shourya-khatiyan/Prime-TheHumanoid/obsidian-robot-vault/VAYN-TheUltimateBrain/Building VAYN - 6.2/VAYN — Phase 1 Electronics + RT Core Architecture.md

> **Revision note (2026-10-20, VAYN-6.2.1):** corrected in place to match the built hardware and live measurements:  
> gearbox 20:1 → **30:1 two-stage planetary (6:1 × 5:1)**; motor-turn sector 18° → **12°**  
> motor **EaglePower LA8308 KV90**, 20 pole pairs (counted)  
> torque targets → **30 N·m continuous / 50 N·m proof, theoretical**  
> RT computer Mac Mini → **Dell Latitude 5490** (PREEMPT_RT kernel 7.0)  
> Phase-1 power 6S battery → **bench PSU at about 24 V**  
> arm "3 kg / 10–13 N·m" → **1.414 kg / 3.26 N·m** (v0)  
> output reference: **hall homing** (the shoulder CAD has no output encoder)  
> ODESC firmware **0.5.1**, CAN currently 250 kbit/s (to be set to 1 Mbit/s)  
> The questions in §10 have been answered. See [VAYN-6.2.1](../VAYN - 6.2.1.md) and the [RT Core implementation spec](RT Core Implementation - VAYN 6.2.1.md).

### 1.1 The actuator is a 30:1 design (30 N·m continuous / 50 N·m proof targets)
Earlier docs used an 80:1 / 80+ N·m assumption, and then a 20:1 analysis. The built shoulder (`Prime-TheHumanoid/body parts/shoulder`) uses a **30:1 two-stage planetary**: stage 1 is 6:1 (18/36/90 teeth), stage 2 is 5:1 (18/27/72 teeth). That gives:

\[ K_t \approx \frac{8.27}{90}=0.0919\ Nm/A \] (ODrive convention; 90 KV is the seller's value, not measured)
`Ideal output per amp:`
\[ 0.0919\times30\approx2.76\ Nm/A \]
`At 87% gearbox efficiency (assumed in the actuator profile, unproven):`
\[ \boxed{\approx2.40\ Nm/A} \]

So this actuator is documented as:
> **30:1 reduction; 30 N·m continuous (about 12.1 A in** **`shoulder/cad/calc.txt`****) and 50 N·m proof targets. Theoretical; continuous torque must be proven by the thermal test.**

---

### 1.2 The motor's 22 A rating cannot be treated as our continuous actuator rating
This is probably the most important mechanical/electrical correction.
The motor is a drone motor. Its published current rating assumes substantial airflow from the propeller. Inside a relatively enclosed actuator, we cannot assume it can continuously dissipate the same heat. Pasted text
Therefore:

```css
22 A motor rating
        ≠
22 A continuous actuator rating
```

The real continuous rating will come from the **thermal test**.

---

### 1.3 Output encoder is now a Phase-1 requirement, not a later improvement
Previously I treated the second encoder as something we could add later.
I would change that.
Because the motor-side AS5047P is single-turn and the reduction is 30:1:
[ 360^\\circ / 30 = 12^\\circ ]
The motor encoder alone cannot tell us which 12° joint sector we're currently in after power-up.
Therefore:

```markdown
Motor AS5047P
      ↓
ODESC
      ↓
motor control

Output absolute encoder
      ↓
sensor MCU
      ↓
RT Core
```

The output encoder establishes the absolute joint position and resolves the motor-turn ambiguity. The analysis explicitly recommends treating it as required before the arm moves. Pasted text
So I now consider:
> **2 × AS5047P per actuator**  
> one motor-side + one output-side  
> a much more appropriate Phase-1 architecture, assuming we indeed use AS5047P for the output sensor.

> **Update (2026-10-20):** the shoulder CAD has no output encoder; it has a **DRV5033 hall homing sensor** on the output flange. Because 30:1 is an exact integer ratio, any reference better than ±6° (reference pose by hand, or the hall edge) selects the 12° sector, and the motor encoder then gives the absolute joint angle at about 0.03° precision. The output encoder is no longer a hard gate before arm motion. It stays the recommended later upgrade for homing without motion and two-channel plausibility. Note also that the AS5047P's 0.022° is its _resolution_; its _accuracy_ is ±0.8° (datasheet). See [VAYN-6.2.1 §8](../VAYN - 6.2.1.md).

---

### 1.4 Safety is now part of the actuator architecture, not a later Phase-1 addition
Our previous plan could be interpreted as:

```text
ODrive
→ RT Core
→ safety later
```

That is too loose.
The v0 arm is 1.414 kg, and the shoulder gravity torque is about 3.26 N·m with the arm horizontal; it rises to about 9.2 N·m with the planned "stage 2" wrist, gripper and 0.5 kg payload (`arm/cad/calc.txt`, `arm/research.md`). Loss of drive can cause the arm to fall. On ODESC3.6, a watchdog timeout or any drive fault disarms the motor. The new analysis therefore makes the **safe state** an architectural decision that has to happen before unrestricted arm testing. Pasted text
We therefore need to define:

```haskell
normal fault
→ controlled stop

hard fault
→ drive off + brake/safe mechanism

power loss
→ fail-safe mechanical/passive state
```

The exact mechanism is still open.

---

### 1.5 We need a Sensor/Interface MCU in addition to the Safety MCU
This is a new architectural element.
The RT computer (now a Dell Latitude 5490 laptop; previously a Mac Mini) has no native SPI/I²C/GPIO interface suitable for directly reading the output encoder, the hall homing sensor and future sensors.
So we should separate:

```cpp
Sensor MCU
    ↓
reads output encoder / future IMU
    ↓
CAN
    ↓
RT Core
```

from:

```markdown
Safety MCU
    ↓
independent safety monitoring
    ↓
fault response
```

The analysis explicitly recommends keeping the sensor-interface function separate from the Safety MCU so that the safety firmware stays small and deterministic. Pasted text
This is a good design decision, and I would adopt it.

---

### 1.6 The first RT control mode should be simpler than full torque-mode impedance control
This is another important change.
Previously our mental model was:

```text
RT Core
→ desired torque
→ ODESC torque mode
```

I would **not start there anymore**.
The new analysis recommends initially using the ODESC's own cascaded position/velocity control loops, which operate much faster and avoid putting a network-delay-sensitive damping loop immediately across CAN.
So our initial control architecture becomes:

```css
RT Core
   ↓
desired position
+
torque feedforward
   ↓
CAN
   ↓
ODESC
   ↓
position/velocity loops
   ↓
FOC/current control
```

Only later, once we have measured:

```swift
output encoder
Kt
friction
backlash
thermal behavior
CAN delay
```

do we move toward:

```sql
RT Core
   ↓
full joint impedance
   ↓
desired torque
   ↓
ODESC torque/current mode
```

The analysis estimates roughly 1–3 ms network delay and specifically warns that this constrains how much damping we can safely put into a network-level impedance loop. Pasted text
That is a much more conservative progression.

---

# 2. Revised Phase 1 architecture
Our physical Phase-1 prototype should now look like this:

```sql
                         VAYN PHASE 1
                              │
                 ┌────────────┴────────────┐
                 │                         │
                 ▼                         ▼
        ┌─────────────────┐       ┌─────────────────┐
        │  DELL 5490      │       │   SAFETY MCU    │
        │                 │       │                 │
        │ Linux           │       │ watchdog        │
        │ PREEMPT_RT      │       │ current         │
        │ RT Core         │       │ voltage         │
        │                 │       │ temperature     │
        └────────┬────────┘       │ encoder/fault   │
                 │                │ E-stop          │
                 │ CAN            └────────┬────────┘
                 │                         │
                 └────────────┬────────────┘
                              │
                         CAN BUS
                              │
        ┌─────────────────────┼─────────────────────┐
        │                     │                     │
        ▼                     ▼                     ▼
   ┌─────────┐          ┌─────────────┐       future nodes
   │ ODESC   │          │ Sensor MCU  │
   │ 3.6     │          │             │
   │         │          │ Hall homing │
   │ FOC     │          │ IMU later   │
   │ current │          └─────────────┘
   │ control │
   └────┬────┘
        │
      3-phase
        │
        ▼
     BLDC MOTOR
        │
   motor AS5047P
        │
     gearbox
        │
        ▼
    JOINT OUTPUT
        │
 DRV5033 hall homing (output AS5047P later)
```

---

# 3. Revised Phase-1 stages
I would now divide Phase 1 into **nine gates**.

---

## P1.0 — Requirements + safety freeze
Before we write serious code or spin anything:
### Freeze:

```sql
continuous torque target
peak torque target
maximum joint velocity
joint range
payload
duty cycle
stopping time
```

The current sensible starting point is:

```text
30 Nm continuous target   (shoulder/cad/calc.txt; earlier draft said 20)
50 Nm peak/proof target   (shoulder/cad/calc.txt; earlier draft said 35)
```

but we should explicitly mark those as **requirements/targets**, not measured capabilities. Pasted text
### Also freeze the safe-state behavior.
For example:

```sql
CAN failure
USB failure
ODESC fault
RT Core crash
Safety MCU crash
battery disconnect
E-stop
over-temperature
over-current
over-voltage
encoder failure
```

For every one:

```css
What happens to the joint?
```

This becomes our **Phase-1 Safety State Table**.

---

# P1.1 — Electrical power architecture
For Phase 1 we use a **bench power supply at about 24 V** with a current limit. A 6S-class battery (about 24 V) remains the later option.
At 24 V:
[ 90KV\\times24V\\approx2160RPM ]
At 30:1:
[ 2160/30\\approx72RPM ]
So roughly:

```perl
24 V
→ ~72 rpm output no-load (432 °/s)
```

The analysis warns against 12S for Phase 1 because a full 12S pack reaches 50.4 V before considering regenerative overshoot against the ODESC's 56 V limit.

A bench PSU usually **cannot absorb regenerated energy**. The ODESC is configured (read live) to send regen into its 2 Ω brake resistor (`dc_max_negative_current = -0.01`). Verify the resistor with a multimeter, and set the over-voltage trip to about 28 V for a 24 V bus.

For the later battery setup we need:

```text
6S battery (later; Phase 1 uses a bench PSU)
↓
anti-spark connector
↓
fuse
↓
contactor / power stage
↓
ODESC
```

and a proper regeneration strategy.

---

# P1.2 — ODESC identification and bring-up
Before motor power:

```text
Computer
   ↓ USB
ODESC
```

We collect:

```swift
hardware revision
firmware version
serial number
original configuration
CAN pinout
SPI pinout
termination
brake resistor circuit
```

And:
> **Do not flash firmware yet.**  
> The reason is that the ODESC3.6 is a clone and its firmware/hardware behavior must be identified before we blindly apply official ODrive assumptions. Pasted text  
> We should make an **ODESC Fact Sheet**.

---

# P1.3 — Motor + encoder commissioning
Do this with:

```diff
motor
+
ODESC
+
AS5047P
```

but **gearbox disconnected**.
We establish:

```css
pole pairs
phase resistance
inductance
encoder direction
encoder offset
motor direction
current limits
velocity limits
```

Start conservatively around:

```css
~5 A
```

for initial calibration/testing, as recommended in the analysis. Pasted text
Then:

```bash
slow velocity test
```

before anything remotely aggressive.

---

# P1.4 — Motor thermal instrumentation
This needs to move much earlier than our old plan.
The motor has no trusted built-in winding temperature measurement for our application.
We need:

```sql
NTC / thermistor
      ↓
motor winding/end-turn
      ↓
Sensor/Safety system
```

The important test points are:

```css
6 A
8 A
12 A
```

for approximately:

```python
30–60 min
```

while measuring winding temperature.
That will give us the first real continuous-duty data. Pasted text Pasted text

---

# P1.5 — Gearbox + actuator characterization
Only after the motor itself is understood:

```verilog
motor
 ↓
gearbox
 ↓
joint output
```

Then experimentally measure:
### Torque
Measure actual:
[ T_{output}/I_{motor} ]
This gives us the real effective (K_t) after losses.
### Efficiency
Measure input electrical/mechanical power against output mechanical power.
### Friction
Measure output breakaway torque in both directions.
### Backlash
Apply known torque in each direction and measure output movement.
### Thermal behavior
Hold:

```css
6 A
8 A
12 A
```

and measure steady-state temperature.
The result is a real actuator datasheet rather than relying on calculations. Pasted text

---

# P1.6 — Absolute joint sensing
This is now a hard gate before arm movement.
We need:

```bash
AS5047P #1
→ motor
→ ODESC

AS5047P #2
→ joint output
→ Sensor MCU
→ CAN
→ RT Core
```

The output encoder determines:

```scss
absolute joint position
joint zero
motor-turn ambiguity
```

At 14-bit resolution:
[ 360/16384 \\approx 0.02197^\\circ ]
so the raw encoder resolution is approximately:
[ \\boxed{0.022^\\circ} ]
The analysis recommended this architecture because the gearbox creates a joint ambiguity from a single motor-side turn: 12° at the current 30:1.

> **Update (2026-10-20):** this gate is replaced for Phase 1 by hall homing or reference-pose homing (see §1.3 update and [VAYN-6.2.1 §8](../VAYN - 6.2.1.md)). The output encoder becomes a later upgrade.

---

# P1.7 — Safety system
Now we bring in:

```diff
Safety MCU
+
E-stop
+
power control
+
brake / passive safety mechanism
```

The Safety MCU should independently monitor:

```sql
DC voltage
DC current
motor temperature
ODESC temperature
output encoder
E-stop
ODESC heartbeat
RT heartbeat
```

The analysis also points out that the Nucleo board itself is only a prototype board and has **no CAN transceiver or safety certification**, so an external CAN transceiver is required and a custom safety board will ultimately be preferable. Pasted text

---

P1.8 — RT Core development and real-time validationBuilding VAYN - [6.2.md](http://6.2.md)
•

# Building VAYN-6.2 — Versatile Arbitrated Embodied Nervous-System

> **VAYN-6.2 is not one AI model. It is a complete robot control system in which different computers and models have different jobs.**

# 1. VAYN-6.2 in very simple language

Think of the robot as having **three main computers**:

```text
             ┌─────────────────────┐
             │   AI COMPUTER       │
             │   Jetson Orin NX    │
             │                     │
             │ "What should I do?" │
             └──────────┬──────────┘
                        │
                 movement reference
                        │
                        ▼
             ┌─────────────────────┐
             │   RT MOTION CORE    │
             │                     │
             │ "How do I move      │
             │  safely right now?" │
             └──────────┬──────────┘
                        │
                   motor commands
                        │
                        ▼
             ┌─────────────────────┐
             │     ACTUATORS       │
             └─────────────────────┘

             ┌─────────────────────┐
             │    SAFETY MCU       │
             │                     │
             │ "Is anything        │
             │  dangerously wrong?"│
             └─────────────────────┘
```

The three computers **do not have equal authority**.

The key rule is:

```text
Orin = intelligence
RT Core = physical control
Safety MCU = independent protection
```

The Orin can disappear and the robot should still have a physical control path. The VAYN-6.2 document explicitly makes the RT Motion Core the owner of stabilization, arbitration, safety validation, fallback and final actuator commands, while the Safety MCU is independent.

---

# 2. The easiest way to understand the four parts

VAYN uses:

```text
THINK → PREDICT → MOVE → SURVIVE
```

# THINK = "What do I want to do?"

This is the intelligent/high-level part.

Example:

You say:

> "Pick up the red bottle."

The robot needs to figure out:

```text
What is the bottle?
Where is it?
Which hand should I use?
What skill should I execute?
```

This is where the VLM, memory and task planner live.

It is **not** controlling motors directly.

Think of it as the robot's **decision maker**.

---

# 3. PREDICT = "What is going to happen?"

Suppose the robot sees:

```text
cup is here
```

But the camera image is already 50 ms old.

The robot has moved during those 50 ms.

So instead of blindly saying:

> "The cup is exactly where the camera saw it."

the predictive system asks:

> "Given how the robot moved, where is the cup/robot likely to be now?"

And similarly:

> "If I move my hand like this, where will my hand/body probably be 30 ms later?"

VAYN-6.2 specifically uses a **hybrid prediction idea**:

```text
Known physics / kinematics
           +
learned residual
           +
contact information
           ↓
     predicted state
```

So we're not asking a neural network to relearn all of physics from zero.

---

# 4. MOVE = "What exact movement should happen?"

Now the robot has:

```text
task
+
vision
+
physical state
+
optional prediction
+
constraints
```

The action policy decides:

> "Move the right hand toward this position."

But this is very important:

# The AI does NOT say:

```text
Motor 1 = 2.37 A
Motor 2 = 1.83 A
Motor 3 = ...
```

Instead it produces a **motion reference**.

For example:

```text
Move right hand here
Move body this way
Put foot here
Maintain this grip force
```

The document calls this a **skill-specific motion reference**.

For example:

```text
GRASP

hand position
hand orientation
joint posture
grip force
contact mode
```

or:

```text
WALK

base velocity
turning velocity
footstep target
timing
body posture
```

---

# 5. SURVIVE = "Can the physical robot actually do this safely?"

This is the most important part of VAYN.

Suppose the AI says:

```text
Move arm here
```

The RT Motion Core asks:

```text
Is this allowed?
Is the joint limit exceeded?
Is the torque too high?
Is the command stale?
Is the robot falling?
Do I need to correct the motion?
```

Then it converts the reference into actual motor control.

Simplified:

```text
AI says:
"Put hand here"

        ↓

RT Motion Core

        ↓

check limits
check state
stabilize body
calculate trajectory
apply impedance/torque control

        ↓

motor driver

        ↓

motor
```

That ownership is explicitly frozen in VAYN-6.2.

---

# 6. Why do we need the RT Motion Core?

This is probably the **single most important concept** to understand before we build anything.

Imagine the Orin runs Linux and your neural model takes:

```text
50 ms
```

or crashes.

You don't want:

```text
AI crashed
   ↓
motors suddenly lose control
   ↓
robot falls
```

Instead:

```text
AI crashed
   ↓
RT Motion Core notices
   ↓
rejects stale command
   ↓
uses fallback behavior
   ↓
keeps controlling the robot
```

That is why VAYN calls it **real-time physical control** rather than simply putting everything inside Python/PyTorch.

---

# 7. Why the Safety MCU exists

Now imagine the RT computer itself crashes.

We don't want:

```text
Orin ──X
RT Core ──X
       ↓
motors continue doing something dangerous
```

The Safety MCU is another independent layer.

It watches things such as:

```text
motor current
encoder status
temperature
driver state
heartbeats
E-stop
```

and can constrain or disable actuation when necessary.

The important part is that it should not depend on:

```text
Linux
CUDA
VLM
Orin software
```

for its basic safety role.

---

# 8. So the robot has two different kinds of "brain"

This distinction is useful:

# AI brain

```text
"I want to pick up the cup."
```

# Physical brain

```text
"Your arm is moving too fast.
Your body is leaning.
Slow down.
Shift COM.
Don't exceed this torque."
```

The first is intelligent and flexible.

The second is **fast, predictable and physically constrained**.

VAYN-6.2 is basically saying:

> Don't force one computer/model to do both jobs.

---

# 9. What actually runs on the Orin?

The baseline assigns the Orin things like:

```text
Camera processing
Visual encoder
Object tracking
World model
Action policy
Cognitive model
Task planner
Event manager
Logging
Model management
```

So the Orin is doing the **expensive AI work**.

It is not the final authority on the motors.

---

# 10. What actually runs on the RT Motion Core?

This is where the real robotics/control engineering happens:

```text
IMU
Encoder
Force/torque
Contact information
       ↓
State estimation
       ↓
Stabilization
       ↓
Command arbitration
       ↓
Safety validation
       ↓
Trajectory generation
       ↓
Impedance / torque control
       ↓
Motor drivers
```

The RT core is the robot's **physical nervous system**.

The document explicitly assigns state estimation, arbitration, validation, fallback, stabilization, trajectory generation and impedance control here.

---

# 11. What is "physical state"?

The RT computer maintains the authoritative physical state.

For example:

```text
q            = joint positions
q_dot        = joint velocities

base pose
base velocity
body orientation

motor torque/current

contact state

COM position
COM velocity
```

Think:

```text
S_phys = "What is physically happening to my body right now?"
```

The Orin can **read** this state.

It doesn't get to create a competing version of physical truth.

---

# 12. Where does vision fit?

Vision is separate from physical state.

For example:

```text
Physical state:
"My right elbow is at 1.2 rad."

Vision:
"There is a red cup 40 cm in front of me."

Task state:
"I need to pick up that cup."

Prediction:
"My hand will probably reach this position in 30 ms."
```

VAYN intentionally keeps these representations separate because visual information contains details that cannot be compressed into simple physical variables.

---

# 13. What is the Reflex Layer?

Imagine the robot is holding a cup.

The high-level policy says:

```text
Hold cup
```

Suddenly:

```text
cup starts slipping
```

We don't want to wait for:

```text
camera
→ vision model
→ planner
→ policy
→ new command
```

Instead fast sensors can react:

```text
tactile / force / IMU / joint feedback
           ↓
        reflex
           ↓
small correction
```

For example:

```text
increase grip force
```

or:

```text
move wrist slightly
```

The important part is that the reflex is **bounded**.

It doesn't get unlimited authority.

---

# 14. What does "bounded" mean?

Suppose the AI says:

```text
move arm normally
```

and the reflex detects something unusual.

It can add:

```text
Δu_reflex
```

but only within a predefined authority.

Conceptually:

```text
final request =
normal AI request
+
limited reflex correction
```

The RT core decides whether that final command is actually allowed.

So:

```text
AI
 │
 ├── "move here"
 │
 ▼
Reflex
 │
 └── "slightly correct"
 │
 ▼
RT Core
 │
 └── "I decide what is physically allowed"
```

This is important because otherwise three systems could fight over the actuator.

---

# 15. What happens if AI stops?

This is where VAYN becomes much easier to understand.

# Normal

```text
Orin
 ↓
RT Core
 ↓
Robot
```

# Orin failure

```text
Orin X

RT Core
 ↓
fallback
 ↓
Robot remains physically controlled
```

# RT Core failure

```text
RT Core X

Safety MCU
 ↓
hardware-defined safety response
```

The exact final behavior depends on your actuator hardware: brakes, passive damping, driver safe-state behavior, etc.

So **we cannot finish the safety architecture without eventually knowing the actuator design**.

---

# 16. What does "stale command" mean?

Suppose the AI says:

```text
Move arm to position X
```

and then the AI freezes for 2 seconds.

We absolutely do not want the robot thinking:

> "This is the newest command, so I'll keep using it."

Every important command therefore contains:

```text
timestamp
sequence_id
valid_until
```

So the RT core can say:

```text
command expired
      ↓
reject
      ↓
fallback
```

This freshness idea is one of the important frozen architectural rules.

---

# 17. The entire robot in one example

Let's say you say:

> **"Pick up the bottle."**

# Step 1 — THINK

VLM:

```text
Task = pick up bottle
Object = bottle_01
Hand = right
Skill = GRASP
```

# Step 2 — PERCEIVE

Camera:

```text
Bottle location
Bottle orientation
Scene geometry
```

# Step 3 — PREDICT

Prediction:

```text
Given robot motion + sensing delay:
expected hand/object state = X
```

# Step 4 — MOVE

Action policy:

```text
Move right hand to X
Approach at this velocity
Use this grip force
```

# Step 5 — REFLEX

Tactile:

```text
Contact detected
Slip probability increasing
```

Reflex:

```text
increase grip slightly
```

# Step 6 — RT CORE

RT controller:

```text
Check joint limits
Check velocity
Check torque
Maintain balance
Combine nominal + reflex
Generate motor commands
```

# Step 7 — SAFETY MCU

Safety MCU:

```text
Everything within limits?
Heartbeat alive?
Motor current safe?
Temperature safe?
```

# Step 8 — ACTUATORS

Motors physically move.

That's VAYN-6.2.

---

# 18. The important part: we are NOT going to build everything at once

This is where your original architecture document is actually very good.

The document explicitly says the development should happen in phases, starting with physical control and only later adding the advanced AI components.

The actual build should look like this:

```text
PHASE 1
Physical control
        ↓
PHASE 2
Basic robot behavior
        ↓
PHASE 3
Vision
        ↓
PHASE 4
Prediction
        ↓
PHASE 5
Reflex
        ↓
PHASE 6
Cognition
        ↓
PHASE 7
Generalist / advanced AI
```

---

# 19. Phase 1 is the REAL beginning

This is where I would start with you.

We build:

```text
ACTUATORS
    ↓
MOTOR DRIVERS
    ↓
RT MOTION CORE
    ↓
STATE ESTIMATOR
    ↓
STABILIZATION
    ↓
IMPEDANCE CONTROL
    ↓
SAFETY MCU
```

And **this must work without the Orin**.

That is explicitly the first development phase in your baseline.

---

# 20. What Phase 1 actually means in practical terms

We don't start by training a VLM.

We don't start by building a world model.

We don't start by training an LNN.

We don't even need the full humanoid intelligence yet.

We first need to make one joint behave correctly.

Something like:

```text
Encoder
   ↓
position estimate
   ↓
controller
   ↓
motor driver
   ↓
motor
   ↓
encoder
   └──────────────┐
                  │
                  └── feedback loop
```

Then:

```text
one joint
↓
one actuator
↓
one limb
↓
multiple joints
↓
whole body
```

---

# 21. Then we build the robot's physical "brain"

Once actuators work:

```text
IMU
+
encoders
+
force sensors
        ↓
state estimator
        ↓
"Where is my body?"
```

Then:

```text
state
+
desired motion
        ↓
stabilization/controller
        ↓
motor commands
```

This becomes the RT Motion Core.

---

# 22. Then we make it move without AI

Before adding the fancy neural system:

```text
STAND
WALK
SIT
REACH
GRASP
```

using conventional/controlled methods.

Why?

Because otherwise, when something fails later, we won't know whether the problem is:

```text
motor
encoder
controller
state estimator
AI
vision
prediction
```

The baseline explicitly requires baseline locomotion and manipulation before research components.

---

# 23. Only then do we add AI

Once the physical robot works:

```text
Physical robot
      +
vision
      ↓
object understanding
```

then:

```text
vision
+
physical state
+
task
      ↓
action policy
```

then:

```text
prediction
```

then:

```text
reflex
```

then:

```text
VLM
```

This keeps debugging manageable.

---

# 24. Minimum VAYN-6.2

You don't actually need the full architecture to say:

> "I have started VAYN."

The minimum functioning version in your document is:

```text
Safety MCU
+
RT Motion Core
+
State Estimator
+
Stabilization
+
Impedance Control
+
Baseline Locomotion
+
Baseline Manipulation
+
Basic Perception
```

The more advanced pieces such as world model, reflex, Flow Matching, VLM, event manager, distillation and free-form policy are optional research additions.

That is extremely important.

---

# 25. So how we'll actually build it

I suggest we treat this as a real engineering project with the following sequence:

```text
VAYN-6.2 IMPLEMENTATION
│
├── 0. Hardware definition
│
├── 1. Actuator interface
│
├── 2. Safety MCU
│
├── 3. RT Motion Core
│     ├── real-time loop
│     ├── encoder reader
│     ├── IMU
│     ├── state estimator
│     ├── limits
│     ├── trajectory generator
│     └── impedance controller
│
├── 4. Single-joint testing
│
├── 5. Multi-joint testing
│
├── 6. Whole-body state estimation
│
├── 7. Stabilization
│
├── 8. Basic locomotion
│
├── 9. Basic manipulation
│
├── 10. Orin communication
│
├── 11. Visual perception
│
├── 12. Action policy
│
├── 13. Prediction
│
├── 14. Reflex
│
├── 15. VLM / task manager
│
└── 16. Full VAYN integration
```

And we should **test every layer before connecting the next one**.

---

# 26. One thing we need to settle before writing code

Your VAYN-6.2 document intentionally leaves some hardware choices open:

```text
RT processor
Actuator communication bus
Actuator safety mechanism
Motor drivers
Sensors
```

Those are not arbitrary software details. They determine how we implement the RT Motion Core.

The document itself says the RT hardware and actuator bus are still engineering parameters rather than frozen choices.

So the next stage should be:

```text
VAYN-6.2
      ↓
PHYSICAL ROBOT HARDWARE
      ↓
RT HARDWARE SELECTION
      ↓
ACTUATOR INTERFACE
      ↓
PHASE 1 IMPLEMENTATION
```

**We can build this with you step-by-step, including the actual code, processes, communication protocol, folder structure, controller mathematics, simulation, testing and eventually the Orin integration.**

# The first thing I would build is **Phase 1: one complete actuator control chain** — encoder → RT controller → motor driver → motor → feedback — because everything above it depends
Now the RT computer becomes important (Dell Latitude 5490 since 2026-10-20; this section originally described a Mac Mini).
## RT Core software stack

```swift
Ubuntu
   ↓
PREEMPT_RT
   ↓
C++
   ↓
VAYN RT Core
   ↓
SocketCAN
   ↓
CAN adapter
   ↓
ODESC
```

The RT Core should have:

```text
INIT
CHECKS
READY
RUN
FAULT
SAFE
```

as explicit states. Pasted text
And the real-time thread needs:

```cs
locked memory
fixed priority
CPU affinity
no allocation in loop
lock-free logging path
```

rather than simply "run a C++ loop on Linux." Pasted text

---

# P1.9 — Real RT-controlled single actuator
Only now do we combine everything:

```css
                 RT CORE
                    │
            desired position
            + torque FF
                    │
                   CAN
                    │
                 ODESC
                    │
            position/velocity
                 loops
                    │
                  FOC
                    │
                  BLDC
                    │
                gearbox
                    │
                 joint
              ↙         ↘
     motor encoder    output encoder
          │                 │
        ODESC           Sensor MCU
          │                 │
          └────── CAN ──────┘
                    │
                 RT Core
```

This is our first **true VAYN physical control loop**.

---

# 4. Revised RT Core development path
We should not wait until the physical actuator exists to write RT Core.
We'll develop it in parallel.
### RT-0 — Simulation

```css
desired q
 ↓
impedance/controller
 ↓
simulated actuator
 ↓
q, qdot
 ↓
feedback
```

Use the actual estimated parameters:

```text
30:1
Kt ≈ 0.092 (8.27/90; measure)
backlash 0.09–0.22° (CAD)
friction
delay ≈ 2–3 ms (measure)
arm inertia
motor/gear inertia
```

The analysis specifically recommends building the model around the measured values rather than generic assumptions. Pasted text

---

### RT-1 — Linux real-time timing
Run:

```diff
PREEMPT_RT
+
cyclictest
+
CPU stress
+
logging stress
```

But cyclictest isn't enough.
We need:

```cpp
RT thread
 ↓
SocketCAN
 ↓
USB-CAN
 ↓
CAN bus
 ↓
ODESC
 ↓
reply
 ↓
RT thread
```

and measure the **entire end-to-end path**.
The analysis explicitly calls for histogram, 99.9th percentile and worst-case latency over hours under CPU, USB, Ethernet and logging load. Pasted text
That becomes one of the exit criteria for the RT computer (now the Dell Latitude 5490; see the implementation spec §3.7 for the measurement procedure and targets).

---

# 5. CAN architecture is now clearer
For Phase 1 I would use:

```swift
Classic CAN
1 Mbit/s
```

with a SocketCAN-native adapter, preferably isolated.
Topology:

```cs
[120Ω]
   │
Dell 5490 (USB-CAN)
   │
   ├──── ODESC
   │
   ├──── Safety MCU
   │
   └──── Sensor MCU
   │
[120Ω]
```

Only the two physical ends get 120 Ω termination.
With roughly 0.11–0.135 ms per 8-byte standard frame at 1 Mbit/s (135 bit-times worst case with stuffing), one joint at 1 kHz is possible, but this absolutely does **not** scale to ten joints with the same message budget on one classic-CAN bus.

> **Update (2026-10-20):**  
> Firmware 0.5.1 has no periodic encoder messages, so the RT core must poll. That costs about 325 µs of bus time per joint per cycle (command, RTR, reply), which is about 33% load at 1 kHz.  
> The ODESC is currently at **250 kbit/s**, where even one joint at 1 kHz would need about 130% of the bus. It must be set to 1 Mbit/s.  
> See [VAYN-6.2.1 §12](../VAYN - 6.2.1.md).  
> That means we should design our software with:

```diff
actuator abstraction
+
bus abstraction
```

from the start, rather than hardcoding everything to "one CAN bus forever."

---

# 6. Updated control strategy
This is the most important software change.
## Level 1 — First real actuator

```rust
RT Core

desired position
+
gravity torque feedforward

        ↓ CAN

ODESC

position loop
velocity loop
current loop
FOC
```

The ODESC is doing the fast inner loops.

---

## Level 2 — After characterization
Once we know:

```css
Kt
friction
backlash
output position
thermal limits
network delay
```

we can move to:

```markdown
RT Core

state estimation
      ↓
impedance control
      ↓
joint torque
      ↓
CAN
      ↓
ODESC torque mode
```

This is where VAYN's true joint-level impedance controller begins to become useful.

---

# 7. Updated Phase-1 hardware list
So the "electronics we need" list has changed.
## Required
### Motor side
- EaglePower LA8308 KV90 BLDC motor (have)
- Flipsky ODESC3.6, firmware 0.5.1 (have)
- AS5047P #1 (have; must be mechanically mounted on the motor)
- encoder magnet (Ø6 × 2.5 diametric)
- motor temperature sensor (10 kΩ NTC; ODESC GPIO4 is taken by the encoder CS, so another pin or the Safety MCU must read it)
### Joint side
- DRV5033 hall homing sensor + Ø3 × 2 N52 magnet (in the shoulder CAD)
- output-side AS5047P: later upgrade, not a Phase-1 gate
### RT side
- Dell Latitude 5490 (have; replaces the Mac Mini)
- Ubuntu 26.04 + PREEMPT_RT kernel 7.0 (installed)
- isolated SocketCAN CAN adapter with hardware timestamps (to buy)
### Safety
- NUCLEO-G474RE/G484-class MCU board — exact board still needs confirmation
- CAN transceiver
- E-stop
- DC-rated fuse
- anti-spark connector
- contactor/relay
- chosen passive safe-state mechanism
### Sensor interface
- separate small MCU for output encoder / future IMU
- CAN transceiver
### Power
- Bench PSU at about 24 V with a current limit for Phase 1 (have; rating to confirm); 6S battery later
- appropriate wiring
- regeneration strategy
- DC bus protection

This is materially more complete than our previous list.

---

# 8. Phase-1 exit criteria
I would define Phase 1 as **complete only when all of these are true**:
### Actuator

```css
[✓] Motor calibrated
[✓] AS5047P motor encoder validated
[✓] Gearbox assembled
[✓] Absolute joint angle validated (hall / reference-pose homing; output encoder later)
[✓] Kt experimentally measured
[✓] Efficiency measured
[✓] Friction measured
[✓] Backlash measured
[✓] Thermal curve measured
[✓] Continuous torque experimentally established
```

### RT Core

```css
[✓] PREEMPT_RT installed
[✓] RT timing characterized
[✓] CAN path characterized
[✓] State machine implemented
[✓] Limits implemented
[✓] Command freshness implemented
[✓] Logging implemented
[✓] Simulation passes
```

### Safety

```css
[✓] E-stop tested
[✓] RT heartbeat tested
[✓] ODESC heartbeat tested
[✓] encoder fault tested
[✓] over-current response tested
[✓] over-temperature response tested
[✓] over-voltage response tested
[✓] CAN disconnect tested
[✓] power-loss response tested
```

### Control

```css
[✓] ODESC position control works
[✓] gravity compensation works
[✓] output position tracks correctly
[✓] slow-motion tests pass
[✓] full-range motion passes
[✓] disturbance tests pass
```

The VAYN Phase-1 philosophy remains the same: **one complete actuator/joint loop first, then expand to multiple joints.** Pasted text (2)

---

# 9. What I would NOT do yet
I would explicitly remove these from immediate Phase 1 work:

```css
ROS2 integration
Jetson integration
VLM
RL policy
whole-body AI
Isaac Sim
MPC
full humanoid
```

ROS2 can come later.
Jetson can come later.
The first objective is:
> **One actuator that can safely move, hold, stop, recover from faults, and report its actual state.**  
> That is much more useful than having a beautiful software architecture with an actuator we don't understand thermally or mechanically.

---

# 10. The few things I need you to confirm

> **Answered (2026-10-20):**  
> **A. Motor:** EaglePower LA8308 KV90 (in hand). 20 pole pairs, counted (40 magnets). KV not measured. The ODESC measured phase R = 0.0846 Ω and L = 37 µH.  
> **B. Gearbox:** 30:1 = 6:1 (18/36/90) × 5:1 (18/27/72), two-stage planetary (`shoulder/cad/calc.txt`).  
> **C. Output encoder:** not in the shoulder CAD. A DRV5033 hall homing sensor is used instead; an output encoder is a later upgrade.  
> **D. Safety MCU:** none bought yet. Recommended NUCLEO-G474RE + 3.3 V CAN transceiver (implementation spec §19).  
> **E. Safe state:** **D, guarded and tethered rig only**, for Phase 1.  
> **F. Power:** bench PSU (rating to confirm, recommended setting 24 V); no battery for Phase 1.  
> **G. RT computer:** the Mac Mini is dropped. The RT host is a Dell Latitude 5490 (i5-8350U), Ubuntu 26.04, PREEMPT_RT kernel 7.0.  
> The resulting plan is the [RT Core implementation spec](RT Core Implementation - VAYN 6.2.1.md). The original questions are kept below for history.

I've tried to infer everything possible from the analysis. I **do not** need you to reconfirm things we can calculate, like the ~35 Nm theoretical peak.
I need these specific answers because they materially change the hardware or software architecture:
### A. Motor
1. **Exact motor model / datasheet** — especially the manufacturer's stated 90 KV, 22 A, 0.186 Ω values.
2. Do you physically have the motor with you? If yes, we can determine **pole pairs from the rotor** rather than guessing.
### B. Gearbox
1. Please confirm the **actual final reduction is 20:1** and give me the exact stage arrangement/ratios from the latest CAD. The new analysis appears to be based on a different gear arrangement than our earlier "planetary + cycloidal" discussion, so I don't want to silently merge the two designs.
### C. Output encoder
1. Are we agreeing to use **a second AS5047P on the joint output**?
2. I recommend yes.
3. Do you already have the second AS5047P board and the two encoder magnets, or do we need to add them to the purchase list?
### D. Safety MCU
1. Which physical board do you actually have / intend to buy:
2. **NUCLEO-G474RE** or **STM32G484RE-based board**?
3. Do you already have a CAN transceiver module, or should we include one?
### E. Safe state
1. Which of these are you willing to use for the first physical arm test?

```cs
A. Mechanical brake
B. Phase-short / dynamic braking
C. Counterbalance spring
D. Guarded + tethered test rig only
```

My recommendation is **D for the earliest motor/gearbox experiments**, followed by a real fail-safe mechanism before unrestricted arm movement.
### F. Power
1. Do you already have a **6S battery/power source**? Tell me its:

```java
battery chemistry
capacity
maximum discharge current
BMS (if applicable)
connector
```

### G. Mac Mini
1. Confirm the exact Mac Mini model/year and whether you're okay installing Linux on it completely or whether you need to preserve macOS.

---

Once you give me those answers, I can turn this into a **final Phase 1 master plan with hardware BOM, electrical topology, software milestones, testing gates, and exact dependency order** rather than continuing to change the architecture later.
