shourya-khatiyan/Prime-TheHumanoid/obsidian-robot-vault/VAYN-TheUltimateBrain/VAYN Docs.md

# VAYN Documentation

A central index of the imported VAYN documents.

## Core architecture

- [VAYN - 1.md](VAYN - 1.md)
- [VAYN - 2.md](VAYN - 2.md)
- [VAYN - 3.md](VAYN - 3.md)
- [VAYN - 4.md](VAYN - 4.md)
- [VAYN - 5.md](VAYN - 5.md)
- [VAYN - 6.md](VAYN - 6.md)
- [VAYN - 6.2.md](VAYN - 6.2.md)
- [VAYN - 6.2.1.md](VAYN - 6.2.1.md): RT Motion Core Hardening Revision
- [VAYN - 6.3.md](VAYN - 6.3.md)
- [VAYN - 7.md](VAYN - 7.md)

## Related VAYN documents

- [From v1-v5.md](From v1-v5.md)
- [VAYN-Link vs other models.md](VAYN-Link vs other models.md)
- [VAYN-6.2: A Safety-Partitioned Multi-Timescale Architecture for Humanoid Robot Intelligence.md](VAYN-6.2_ A Safety-Partitioned, Multi-Timescale Architecture for Humanoid Robot Intelligence.md)
- [Building VAYN - 6.2.md](Building VAYN - 6.2/Building VAYN - 6.2.md)
- [Implementation Flow - VAYN 6.2.md](Building VAYN - 6.2/Implementation Flow - VAYN 6.2.md)
- [Electronic integration with VAYN](Building VAYN - 6.2/VAYN Electronic.md)
- [VAYN - Phase 1 Electronics for RT Core Architecture](Building VAYN - 6.2/VAYN — Phase 1 Electronics + RT Core Architecture.md)
- [RT Core Implementation - VAYN 6.2.1](Building VAYN - 6.2/RT Core Implementation - VAYN 6.2.1.md)
- [Safety MCU — Nucleo Build Guide](Building VAYN - 6.2/Safety MCU - Nucleo Build Guide.md)
- [RT Core - From Fundamentals to Advanced](Building VAYN - 6.2/RT Core - From Fundamentals to Advanced.md)
- [motor specification and actuator details](Building VAYN - 6.2/motor specification and actuator details.md)
- [VAYN - Phase 1 Electronics + RT Core Architecture](Building VAYN - 6.2/VAYN - Phase 1 Electronics + RT Core Architecture.md)
