shourya-khatiyan/Prime-TheHumanoid/obsidian-robot-vault/VAYN-TheUltimateBrain/VAYN - 6.2.md

> **Revision note (2026-10-20):**
> The structure of this baseline is unchanged and remains frozen.
> The RT Motion Core is refined by [**VAYN-6.2.1 — RT Motion Core Hardening Revision**](VAYN - 6.2.1.md). It adds two validation gates, braking-distance limits, the task and timing model, the fault-to-reaction matrix, homing, the CAN budget and `ACTION_ACK_V1`.
> It also fills parameterized items for Phase 1: RT hardware is a Dell Latitude 5490 with PREEMPT_RT, and the actuator bus is CAN 1 Mbit/s to an ODESC3.6.
> Where this document says "the exact processor remains an engineering decision" (§6) or leaves the bus open (§54), see 6.2.1 for the Phase-1 values.

# VAYN-6.2 — Versatile Arbitrated Embodied Nervous-System

## Implementation-Ready Heterogeneous Robot Intelligence Architecture

**Version:** 6.2  
**Status:** Architecture-Freeze Baseline  
**Baseline Tag:** VAYN-6.2-baseline  
**Primary Edge AI Target:** NVIDIA Jetson Orin NX 16GB  
**Control Architecture:** Heterogeneous AI + real-time motion control + independent safety supervision  
**Application:** Humanoid robotics, whole-body control, locomotion, manipulation, perception, prediction, and adaptive robot intelligence

---

# 1. Executive Summary

VAYN-6.2 is a hierarchical, heterogeneous robotic intelligence architecture designed to separate semantic reasoning, physical prediction, motion generation, reactive behavior, deterministic control, and safety.

The architecture is based on four fundamental responsibilities:

**THINK → PREDICT → MOVE → SURVIVE**

These responsibilities are implemented at different computational timescales and, where appropriate, on different hardware.

The architecture consists of:

1. **Cognitive Layer** — semantic understanding, reasoning, memory, task planning, and high-level decision making.
    
2. **Task and Skill Layer** — converts high-level intent into structured or free-form executable objectives.
    
3. **Perception Layer** — extracts visual and semantic information while maintaining a separate physical state.
    
4. **Predictive Layer** — forecasts short-horizon physical states using kinematic/dynamics prediction and, where useful, a learned residual model.
    
5. **Action Policy Layer** — generates motion references rather than raw motor-level commands.
    
6. **Reflex Layer** — produces bounded corrective residuals from fast physical feedback such as force, tactile, IMU, and joint data.
    
7. **RT Motion Core** — continuously owns stabilization, command arbitration, safety validation, trajectory generation, fallback behavior, and actuator command generation.
    
8. **Independent Safety MCU** — independently supervises the robot and can constrain or disable actuation regardless of the AI computer's state.

The most important architectural rule is:

> **The AI system can increase the robot's capabilities, but loss of the AI system must not automatically mean loss of physical controllability.**

VAYN-6.2 is therefore explicitly designed to degrade from full intelligence toward increasingly conservative physical control rather than directly transition from "AI operating" to "motors off."

The architecture does not assume that any particular neural model, parameter count, frequency, latency, or prediction mechanism will work as intended. Those values remain engineering parameters to be measured on the final hardware and software stack.

---
# 2. Architecture Philosophy

## 2.1 THINK
The cognitive layer answers:

- What should the robot do?
    
- Why should it do it?
    
- Which skill or behavior is appropriate?
    
- What objects and goals are relevant?
    
- Has the task changed?

This layer operates slowly compared with physical control.

---

## 2.2 PREDICT

The predictive layer answers:

- Where will the robot be after its command and sensing delays?
    
- What physical state is likely to occur next?
    
- Is contact expected?
    
- How certain is the prediction?

Prediction is used to compensate for latency and improve planning, but it is not a mandatory dependency.

---

## 2.3 MOVE

The action layer answers:

- What movement should be performed?
    
- What trajectory or motion reference should be executed?
    
- What corrective residual should be applied?

The action policy generates motion references.

The RT Motion Core converts those references into physically valid commands.

---

## 2.4 SURVIVE

The low-level control and safety system answers:

- Can the robot remain physically stable?
    
- What happens if the AI stops responding?
    
- What happens if a command is stale?
    
- What happens if a controller fails?
    
- What happens if an actuator reports a dangerous fault?
    
- When should motors be limited or disabled?

This layer must not depend on VLM inference.

---

# 3. Core Architectural Rules

VAYN-6.2 follows the following rules.

### Rule 1 — RT Motion Core owns physical control

The RT Motion Core always owns:

- Stabilization
    
- Command arbitration
    
- Safety validation
    
- Fallback reference generation
    
- Trajectory generation
    
- Impedance control
    
- Final actuator commands

The Orin does not directly own actuator control.

---

### Rule 2 — Safety MCU is independent

The Safety MCU must operate independently of:

- Linux
    
- CUDA
    
- VLM inference
    
- Orin application processes
    
- General-purpose middleware

It has its own safety-relevant sensing wherever the hardware permits.

---

### Rule 3 — No learned model bypasses safety

All neural commands pass through the RT control and safety architecture.

No neural network may directly bypass:

- Joint limits
    
- Velocity limits
    
- Torque/current limits
    
- Thermal limits
    
- Command validity
    
- Emergency-stop mechanisms

---

### Rule 4 — Stale commands cannot run indefinitely

Every control command must have:

- Timestamp
    
- Sequence ID
    
- Validity information
    
- `valid_until`

Expired commands cannot remain active indefinitely.

---

### Rule 5 — State is explicit, but vision remains available

VAYN-6.2 does not attempt to compress every relevant visual detail into a single explicit physical state.

The system maintains:

**Physical state + visual representation + task state + predicted state**

as separate but coordinated information domains.

---

### Rule 6 — Experimental modules must have baselines

Every proposed research component must be compared with a simpler alternative.

Examples:

- LNN vs GRU vs MLP
    
- Learned prediction vs kinematic prediction
    
- Reflex vs no reflex
    
- Event-driven cognition vs scheduled cognition
    
- Small student vs generalist baseline

---

# 4. High-Level Architecture

```text
                           VAYN-6.2
                              │
                  ┌───────────▼───────────┐
                  │     COGNITIVE LAYER   │
                  │                       │
                  │ VLM / Reasoning       │
                  │ Memory / Planning     │
                  │ ~0.5–3 Hz / events    │
                  └───────────┬───────────┘
                              │
                         Task / Intent
                              │
                  ┌───────────▼───────────┐
                  │   TASK / SKILL LAYER  │
                  │                       │
                  │ Structured skills     │
                  │ + Free-form pathway   │
                  └───────────┬───────────┘
                              │
          ┌───────────────────┴───────────────────┐
          │                                       │
          ▼                                       ▼
┌──────────────────────┐               ┌────────────────────────┐
│  VISUAL PERCEPTION   │               │  RT MOTION CORE        │
│                      │               │                        │
│ Visual encoder       │               │ Physical state         │
│ Object tracking      │               │ State estimation       │
│ Geometry / depth     │               │ Stabilization           │
│ Scene features       │               │ Arbitration             │
└──────────┬───────────┘               │ Safety validation       │
           │                           │ Fallback                 │
           ▼                           │ Impedance control        │
┌──────────────────────┐               └────────────┬───────────┘
│ VISUAL FEATURE CACHE │                            │
└──────────┬───────────┘                         Actuators
           │
           ▼
┌──────────────────────┐
│ HYBRID WORLD MODEL   │
│                      │
│ Kinematics / physics │
│ Learned residual     │
│ Contact model        │
│ Uncertainty          │
└──────────┬───────────┘
           │
           ▼
┌──────────────────────┐
│    ACTION POLICY     │
│                      │
│ Task                 │
│ Visual features      │
│ Physical state       │
│ Predicted state      │
│ Constraints          │
└──────────┬───────────┘
           │
      Nominal reference
           │
           ▼
┌──────────────────────┐
│    REFLEX LAYER      │
│                      │
│ IMU                  │
│ Force                │
│ Tactile              │
│ Contact              │
│ Joint feedback       │
│                      │
│ Bounded residual     │
└──────────┬───────────┘
           │
           ▼
       RT MOTION CORE

        ┌────────────────────────────────┐
        │      INDEPENDENT SAFETY MCU    │
        │                                │
        │ Watchdog                       │
        │ Current monitoring              │
        │ Encoder monitoring              │
        │ Fault detection                │
        │ Temperature                    │
        │ Hard limits                    │
        │ E-stop                         │
        │ Motor enable                   │
        └────────────────────────────────┘
```

---

# 5. Hardware Architecture

VAYN-6.2 contains three principal compute domains.

## 5.1 AI Compute Domain

Primary target:

**NVIDIA Jetson Orin NX 16GB**

Primary responsibilities:

- Visual perception
    
- Visual feature extraction
    
- World-model inference
    
- Action-policy inference
    
- Cognitive model
    
- Task planning
    
- Event management
    
- Logging
    
- Model management

The Orin is not the sole physical control computer.

---

# 6. Real-Time Motion Domain

A separate real-time-capable processor is responsible for the RT Motion Core.

The exact processor remains an engineering decision.

The hardware must provide sufficient compute for:

- Physical state estimation
    
- Stabilization
    
- Command arbitration
    
- Safety validation
    
- Fallback control
    
- Trajectory generation
    
- Impedance control
    
- Real-time communication with actuators

The controller must have sufficient deterministic timing margin after accounting for:

- OS/runtime overhead
    
- communication
    
- sensor processing
    
- estimator computation
    
- stabilization
    
- actuator communication

---

# 7. Independent Safety MCU

The Safety MCU is independent from the RT Motion Core.

Its purpose is not to perform full robot control.

Its responsibilities are:

```text
Supervise
Detect Fault
Constrain
Disable
```

It monitors safety-relevant information directly where possible.

Potential signals include:

- Encoder position
    
- Motor current
    
- Driver status
    
- Temperature
    
- Motor enable
    
- Emergency stop
    
- Communication heartbeat

The exact sensing architecture is determined by the actuator electronics.

---

# 8. Real-Time Motion Core

The RT Motion Core is the central physical-control authority.

It operates continuously during normal operation.

The neural system provides references.

The RT Motion Core turns those references into physically valid motion.

```text
AI Reference
     ↓
Command Arbitration
     ↓
Safety Validation
     ↓
Stabilization
     ↓
Trajectory Generation
     ↓
Impedance / Torque Control
     ↓
Motor Driver
     ↓
Actuator
```

The RT Motion Core does not disappear when the AI computer disappears.

---

# 9. Stabilization Ownership

VAYN-6.2 explicitly avoids having two independent balance controllers that must hand control from one to the other.

The RT Motion Core always owns stabilization.

Possible stabilization implementations include:

### Primary candidate

- Model-based whole-body control
    
- Whole-body inverse dynamics
    
- MPC
    
- Other deterministic control approaches

### Contingency

A compact learned stabilizer may be used if the classical controller cannot meet the required agility.

However:

> **Any learned stabilizer used for this purpose must run inside the RT Motion Core's independent control domain rather than depend on the Orin.**

Therefore:

```text
AI on Orin
    ↓
Motion Reference
    ↓
RT Stabilizer
    ↓
Actuator
```

not:

```text
Orin Balance Policy
      ↕
RT Balance Policy
```

---

# 10. Physical State Ownership

The RT Motion Core is the single owner of the robot's physical control state.

Define:

```text
S_phys
```

as the authoritative real-time physical state.

It may include:

- Joint position
    
- Joint velocity
    
- Base position
    
- Base orientation
    
- Base linear velocity
    
- Base angular velocity
    
- Torque/current estimates
    
- Contact state
    
- Contact probability
    
- Center of mass
    
- Center-of-mass velocity
    
- Control-related uncertainty

The Orin consumes this state.

It does not create a competing "physical truth" stream.

---

# 11. VAYN State Representation

VAYN-6.2 uses several complementary representations:

```text
VAYN_STATE_V1 =
{
    S_phys,
    V_scene,
    G_task,
    S_pred,
    uncertainty
}
```

Where:

### `S_phys`

Physical state owned by the RT Motion Core.

### `V_scene`

Visual scene representation.

### `G_task`

Task and goal representation.

### `S_pred`

Predicted future physical state.

### `uncertainty`

Confidence information associated with estimation and prediction.

---

# 12. Sensor Architecture

Sensors are divided according to their role.

## 12.1 Physical Sensors

Primary users:

- RT Motion Core
    
- Reflex layer
    
- Safety MCU

Examples:

- IMU
    
- Joint encoder
    
- Motor current
    
- Torque sensor
    
- Force sensor
    
- Foot-contact sensor
    
- Tactile sensor

---

## 12.2 Semantic Sensors

Primary user:

- Orin AI domain

Examples:

- RGB cameras
    
- Stereo cameras
    
- Depth cameras
    
- LiDAR
    
- Microphone

The same sensor can be used by multiple layers, but the timing and ownership of each data product must remain explicit.

---

# 13. State Estimation

The RT state estimator fuses physical sensing.

Conceptually:

```text
IMU
 +
Encoders
 +
Force / Torque
 +
Contact
        ↓
State Estimator
        ↓
S_phys
```

The estimator may use:

- EKF
    
- UKF
    
- Factor graph
    
- Other validated filtering approach

A learned estimator may be investigated experimentally.

The deployed system must have a clearly defined authoritative physical state output.

---

# 14. Visual Perception

The visual subsystem converts camera information into:

```text
V_scene
```

Potential outputs include:

- Visual features
    
- Object tracks
    
- Object pose
    
- Geometry
    
- Scene context
    
- Relevant visual descriptors

The visual subsystem should not be assumed to perfectly describe the environment.

Visual uncertainty and data age should be retained where useful.

---

# 15. Visual Feature Cache

The visual encoder does not necessarily need to run at the same frequency as the action policy.

For example:

```text
Visual Encoder:
10–20 Hz target

Action Policy:
25–50 Hz target
```

The action policy consumes the latest valid feature representation.

Each cached feature must contain:

```text
timestamp
sequence_id
source_id
frame_id
valid_until
```

This makes visual age measurable.

---

# 16. Visual Freshness

Visual freshness is skill-dependent.

Examples:

```text
Walking:
relatively tolerant of older visual features

Reach:
moderately sensitive

Grasp:
more sensitive

Fine manipulation:
highly sensitive
```

Therefore there is no universal visual TTL.

The TTL becomes a configuration parameter for each skill.

---

# 17. Cognitive Layer

The cognitive layer handles:

- Language
    
- Semantic reasoning
    
- Scene understanding
    
- Task decomposition
    
- Memory
    
- Skill selection
    
- High-level planning

It is not inside the hard real-time control path.

Its output is structured intent rather than direct actuator commands.

---

# 18. Task and Skill Manager

The Task Manager converts:

```text
Intent
  ↓
Task
  ↓
Skill
  ↓
Parameters
```

Example:

```text
Task:
Pick up the red cup

Skill:
GRASP_OBJECT

Parameters:
object_id = cup_03
hand = right
approach = front
speed_limit = configured value
force_limit = configured value
```

---

# 19. Hybrid Skill Architecture

VAYN-6.2 uses two pathways.

## Structured Skill Path

Examples:

- WALK
    
- STAND
    
- SIT
    
- REACH
    
- GRASP
    
- RELEASE
    
- PUSH
    
- PULL
    
- RECOVER

Advantages:

- Easier constraints
    
- Easier testing
    
- Easier safety validation
    
- More predictable behavior

---

## Free-Form Path

Used for:

- Unstructured tasks
    
- Long-tail tasks
    
- Novel combinations
    
- Tasks outside the predefined skill library

The free-form path remains subject to the same lower-level control and safety system.

---

# 20. Skill-Specific Motion References

The action policy does not send an undefined generic "trajectory."

It sends a structured motion reference appropriate for the selected skill.

## WALK Reference

Possible fields:

```text
base_linear_velocity
base_angular_velocity
footstep_targets
footstep_timing
body_pose_target
COM_target
contact_phase
```

---

## MANIPULATION Reference

Possible fields:

```text
end_effector_pose
end_effector_velocity
joint_posture_target
grip_force_target
contact_mode
```

---

## WHOLE-BODY Reference

Possible fields:

```text
task-space targets
posture target
COM target
contact targets
priority
constraints
```

---

## RECOVERY Reference

Possible fields:

```text
COM target
foot-placement target
body orientation
protective posture
maximum allowed velocity
```

---

# 21. Motion Reference Interface

All motion references must specify:

```text
reference_type
frame_id
units
timestamp
sequence_id
priority
valid_until
constraints
```

The frame and unit definitions are part of the interface contract.

SI units should be used unless a subsystem-specific contract explicitly defines otherwise.

---

# 22. Required and Optional Fields

Each interface field must be classified as:

```text
REQUIRED
OPTIONAL
DEFAULTED
FORBIDDEN
```

The RT Motion Core must never silently infer missing critical information.

Examples:

```text
Required field missing
→ reject command
```

```text
Optional field missing
→ use documented default
```

```text
Posture field absent
→ retain documented controller behavior
```

---

# 23. Command Arbiter

The Command Arbiter operates inside the RT Motion Core.

The Orin may generate:

```text
u_nominal
```

and a reflex subsystem may produce:

```text
Δu_reflex
```

The RT Core determines:

```text
u_requested = u_nominal + bounded(Δu_reflex)

u_final = RT_Control(u_requested)
```

The RT Core enforces the reflex authority limits.

The Orin is not trusted to enforce its own limits.

---

# 24. Reflex Authority

The reflex layer is allowed to modify the nominal action only within a defined authority envelope.

Conceptually:

```text
|Δu_reflex| ≤ AuthorityLimit(skill, state)
```

The limit can vary with:

- Skill
    
- Joint
    
- Controller mode
    
- Robot state
    
- Disturbance level

The authority envelope remains experimentally determined.

---

# 25. Reflex Layer

The reflex layer is designed for rapid physical correction.

Possible inputs:

- IMU
    
- Encoder state
    
- Torque/current
    
- Force
    
- Tactile
    
- Contact state

Possible outputs:

- Joint residual
    
- Foot-placement correction
    
- Grip-force correction
    
- COM correction
    
- Contact response
    
- Disturbance rejection

The reflex does not replace the RT Motion Core.

---

# 26. Reflex Model Candidates

Possible models:

- MLP
    
- GRU
    
- Small recurrent model
    
- State-space model
    
- LNN/CfC

The architecture does not assume LNN superiority.

The correct comparison is:

```text
MLP
vs
GRU
vs
LNN/CfC
```

under comparable:

- Parameter budgets
    
- Input information
    
- Training data
    
- Latency constraints
    
- Disturbances

---

# 27. Locomotion Reflex

For locomotion, the baseline locomotion policy may already contain disturbance rejection.

Therefore a separate learned reflex residual is an experiment rather than a mandatory component.

The experimental comparison is:

```text
Locomotion Policy
        vs
Locomotion Policy + Reflex Residual
```

Metrics include:

- Fall rate
    
- Recovery rate
    
- Reaction latency
    
- Stability
    
- Energy
    
- Tracking error

---

# 28. Manipulation Reflex

Manipulation is the primary intended application of the reflex research.

The system can use:

```text
Visual Policy
   +
Tactile
   +
Force
   +
Joint feedback
      ↓
Contact Reflex
```

Potential applications:

- Slip recovery
    
- Grip-force adjustment
    
- Unexpected contact
    
- Collision response
    
- Small trajectory correction

---

# 29. Reflex Training

The reflex must be explicitly trained on disturbances.

Training scenarios should include:

```text
forward push
backward push
lateral push
foot slip
unexpected contact
late contact
sensor noise
sensor dropout
actuator delay
control delay
object collision
```

Recovery is considered learned only when the corresponding corrective behavior is demonstrated in training/evaluation.

---

# 30. Predictive World Model

The predictive layer is designed to reduce the effect of sensing and computation latency.

It predicts:

```text
future physical state
```

rather than generated future video frames.

Input:

```text
S_phys
+
action buffer
+
task context
+
contact state
```

Output:

```text
S_pred
+
uncertainty
```

---

# 31. Hybrid Prediction Architecture

VAYN-6.2 does not require the neural network to rediscover basic physics.

The prediction pipeline is:

```text
Current State
+
Known Action
+
Actuation Delay
        ↓
Kinematic / Dynamics Prediction
        ↓
Baseline Prediction
        +
Learned Residual
        +
Contact Model
        ↓
Predicted State
+
Uncertainty
```

This allows the learned model to focus on effects that are difficult to capture analytically.

---

# 32. Prediction Targets

Potential predicted quantities:

- Joint position
    
- Joint velocity
    
- Base pose
    
- Base velocity
    
- COM position
    
- COM velocity
    
- Contact probability
    
- Object-relative motion
    
- Expected physical state
    
- Prediction uncertainty

The final prediction vector is task-dependent.

---

# 33. Contact-Aware Prediction

Contact events may produce discontinuous changes.

Relevant events include:

- Foot-ground contact
    
- Hand-object contact
    
- Impact
    
- Slip
    
- Grasp
    
- Collision

The prediction system therefore represents contact explicitly.

Potential contact modes:

```text
FREE_MOTION
FOOT_CONTACT
HAND_CONTACT
OBJECT_CONTACT
IMPACT
SLIP
RECOVERY
```

---

# 34. Adaptive Prediction Trust

Prediction should not be trusted equally in every situation.

Conceptually:

```text
low uncertainty
→ use prediction more strongly
```

and:

```text
high uncertainty
→ reduce reliance on prediction
→ rely more on current physical state
→ potentially reduce motion aggressiveness
```

Prediction is therefore an assistive capability rather than a single point of failure.

---

# 35. Prediction Ablation

The required baseline set is:

```text
A — No Prediction

B — Kinematic Extrapolation

C — Physics / Dynamics Prediction

D — Learned Residual Prediction

E — Hybrid Prediction
```

The learned component must demonstrate measurable benefit over simpler alternatives before becoming a required deployment component.

---

# 36. Action Policy

The Action Policy receives:

```text
Task
+
V_scene
+
S_phys
+
S_pred
+
Contact State
+
Constraints
```

and generates a motion reference.

Initial design target:

**Approximately 25–50 Hz**

The final rate is determined by measured latency and compute capacity.

---

# 37. Prediction-Optional Policy

The action policy should support operation with or without a learned predicted-state input.

Conceptually:

```text
Policy Input =
S_phys
+
V_scene
+
Optional S_pred
+
Task
```

This permits:

- Full predictive mode
    
- Physics-only prediction
    
- Prediction-disabled mode
    
- Degraded operation

The training distribution must include the intended degraded modes.

---

# 38. Receding-Horizon Execution

The action policy must not generate a long open-loop action sequence and execute it blindly.

Instead:

```text
Generate future reference
        ↓
Execute short portion
        ↓
Measure new state
        ↓
Generate updated reference
        ↓
Blend
        ↓
Continue
```

Example:

```text
250 ms future reference
        ↓
execute only an initial portion
        ↓
new state measurement
        ↓
new 250 ms reference
```

The exact execution window remains a measured parameter.

---

# 39. Trajectory Blending

New references must be integrated continuously with existing motion.

The system should preserve, where required:

- Position continuity
    
- Velocity continuity
    
- Acceleration continuity
    
- Appropriate jerk limits

This reduces command discontinuities at policy-update boundaries.

---

# 40. Flow Matching

Flow Matching may be used as a motion-generation method.

It can be investigated for:

- Reach
    
- Manipulation
    
- Whole-body movement
    
- Multimodal trajectories

Flow Matching is not treated as:

- A safety mechanism
    
- A replacement for feedback control
    
- A deterministic actuator controller
    
- A guarantee of cross-chunk continuity

All Flow Matching outputs pass through the same motion-reference, arbitration, safety, and control layers.

---

# 41. RT Stabilization

The RT stabilization layer is responsible for maintaining physical stability.

Possible control objectives include:

- Body orientation
    
- COM regulation
    
- Foot placement
    
- Whole-body constraints
    
- Joint limits
    
- Contact constraints
    
- Balance

Possible approaches:

```text
Whole-Body Control
MPC
Inverse Dynamics
Model-Based Stabilization
Compact Learned Stabilizer
```

The selected controller must be verified on the chosen hardware and embodiment.

---

# 42. Impedance Control

A conceptual joint-space impedance controller is:

```text
τ = Kp(qd − q)
  + Kd(q̇d − q̇)
  + τff
```

where:

- `q` = current joint position
    
- `qd` = desired position
    
- `q̇` = current velocity
    
- `q̇d` = desired velocity
    
- `Kp` = stiffness
    
- `Kd` = damping
    
- `τff` = feed-forward torque

The deployed system must also enforce:

- Torque limits
    
- Current limits
    
- Velocity limits
    
- Thermal constraints
    
- Saturation handling
    
- Actuator-specific compensation

Physical compliance comes from the actuator/control system, not from trajectory smoothness alone.

---

# 43. Fallback Architecture

Fallback behavior is state-dependent.

There is no single universal fallback action.

Possible physical conditions include:

```text
STABLE
MOVING
UNSTABLE
RECOVERING
FALLING
HARDWARE_FAULT
```

The fallback strategy depends on the current state.

---

# 44. AI Failure

If the Orin becomes unavailable:

```text
Orin failure
     ↓
RT Motion Core continues operating
     ↓
determine robot state
     ↓
select fallback reference
     ↓
continue physical control
```

The RT Motion Core does not require the Orin to remain active.

---

# 45. State-Dependent Safe-State Strategy

The robot may respond differently depending on its physical condition.

## Stable Standing

Possible response:

```text
Maintain / settle posture
```

## Walking

Possible response:

```text
Decelerate
→ stabilize
→ transition toward safe posture
```

## Unstable but Recoverable

Possible response:

```text
Recovery controller
→ stabilize
```

## Falling

Possible response:

```text
Protective/fall-mitigation behavior
```

## Hardware Fault

Possible response:

```text
Actuator-specific hardware safety mode
```

A motor power cut is a possible final hardware response but is not considered the universal definition of safe behavior.

---

# 46. `valid_until` Semantics

When an AI-generated reference reaches `valid_until`:

```text
Command expires
     ↓
reject stale command
     ↓
bounded extrapolation window
     ↓
RT fallback reference
```

The extrapolation window is:

- Finite
    
- Skill-specific
    
- Measured experimentally

The robot must never depend indefinitely on stale AI commands.

---

# 47. Bounded Extrapolation

During the short expiration window, the RT Motion Core may extrapolate the existing reference using bounded:

- Velocity
    
- Acceleration
    
- Jerk

After the maximum allowed window:

```text
reference = INVALID
```

The RT Motion Core switches to its fallback reference source.

---

# 48. Bumpless Degradation

The RT Motion Core remains active during both normal and fallback operation.

Therefore degradation occurs at the reference level.

```text
AI Reference
      ↓
smooth transition
      ↓
Fallback Reference
```

rather than:

```text
AI Controller
      ↓
sudden controller shutdown
      ↓
different controller
```

The handover should preserve compatible state wherever possible.

---

# 49. RT Controller Failure

If the RT Motion Core fails:

```text
RT heartbeat lost
        ↓
Safety MCU detects failure
        ↓
hardware-defined mitigation
```

The Safety MCU must not be expected to perform full humanoid stabilization unless it has the necessary hardware capability.

Possible actuator-level mitigation includes:

- Passive damping
    
- Mechanical brakes
    
- Controlled torque-off
    
- Driver-level safe mode
    
- Energy dissipation
    
- Other actuator-specific protection

The actual mechanism must be designed together with the actuator hardware.

---

# 50. Actuator Safety Dependency

Safe-state behavior depends on:

- Actuator back-drivability
    
- Mechanical braking
    
- Passive damping
    
- Driver behavior
    
- Motor-controller behavior
    
- Mechanical stops
    
- Battery/contactor architecture
    
- Stored mechanical energy
    
- Robot geometry

Therefore:

> **Actuator design and safety-state design must be finalized together.**

---

# 51. Independent Safety MCU Behavior

The Safety MCU continuously checks:

```text
Orin heartbeat
RT Core heartbeat
Motor driver status
Current
Temperature
Encoder status
Emergency stop
```

Depending on the fault:

```text
Normal
→ no intervention

Warning
→ constrain

Fault
→ disable affected actuator/system

Critical fault
→ execute hardware safety response
```

The exact safety response must come from hazard analysis and actuator characteristics.

---

# 52. Collision Detection

Human-safety-relevant collision detection should not depend entirely on vision.

Potential independent indicators include:

- Motor current
    
- Torque deviation
    
- Encoder error
    
- Unexpected acceleration
    
- Force sensors
    
- Tactile sensors
    
- Actuator-driver fault signals

Vision may supplement collision perception but should not be the only mechanism available to detect dangerous physical interaction.

---

# 53. Software Architecture

The main software domains are logically separated.

```text
Safety MCU
    │
    └── Independent hardware safety

RT Motion Controller
    ├── State estimation
    ├── Command arbiter
    ├── Safety validator
    ├── Stabilization
    ├── Fallback
    ├── Trajectory generation
    └── Impedance control

Orin
    ├── Vision
    ├── Visual encoder
    ├── World model
    ├── Action policy
    ├── Cognitive model
    ├── Event manager
    └── Data/logging
```

Large image/feature data should use efficient zero-copy/shared-memory mechanisms where practical.

Hard control loops should not rely on general-purpose messaging deadlines.

---

# 54. Orin-to-RT Communication

The Orin communicates motion references to the RT Motion Core through a deterministic or bounded-latency communication path.

Candidate technologies include:

- EtherCAT
    
- CAN-FD
    
- Deterministic Ethernet
    
- Other suitable real-time interfaces

The final choice is dependent on:

- Actuator architecture
    
- Required bandwidth
    
- Required latency
    
- Network topology
    
- Controller hardware

---

# 55. Communication Timing Contract

The Orin-to-RT interface must be measured for:

- Communication latency
    
- Jitter
    
- Packet loss
    
- Queueing delay
    
- Synchronization error
    
- Failure-detection time

The architecture should have a defined budget for each.

---

# 56. Data Freshness Contract

Every asynchronous data product should have:

```text
timestamp
sequence_id
source_id
frame_id
deadline
valid_until
```

The consumer can calculate:

```text
data_age =
current_time - timestamp
```

Data exceeding its TTL or validity window must be:

- Rejected
    
- Down-weighted
    
- Replaced
    
- Or trigger a degraded mode

---

# 57. Clock Synchronization

Within one compute domain, a common monotonic or hardware timestamp system should be used.

Across distributed hardware, an appropriate synchronization mechanism should be used when necessary.

Possible mechanisms include:

- Hardware timestamps
    
- PTP
    
- Other synchronized clock systems

The requirement is not "use PTP everywhere."

The requirement is:

> **The timing relationship between components must be known and measurable.**

---

# 58. Cognitive Event Manager

The Event Manager controls when expensive semantic computation should occur.

Potential signals:

```text
semantic novelty
object motion
task relevance
scene change
prediction error
physical anomaly
user input
```

The event system operates using:

```text
Periodic low-cost monitoring
+
Event-driven escalation
```

It is not purely event-driven.

---

# 59. Periodic Coverage

The Event Manager must periodically inspect relevant information even when no explicit event is detected.

This prevents:

- Slow changes
    
- Low-motion important objects
    
- Gradual scene changes
    
- Event-detector failures

from remaining invisible indefinitely.

The exact periodic rate is parameterized.

---

# 60. Cognitive Model Scheduling

The cognitive model runs asynchronously.

Potential triggers:

```text
new task
task failure
important object detected
unexpected environment
large prediction error
user instruction
skill completion
```

The robot should not stop physical control merely because cognitive inference is slow.

---

# 61. Compute Scheduling

VAYN-6.2 does not rely on CUDA stream priority as a hard real-time mechanism.

GPU jobs are managed through application-level scheduling and workload control.

Typical GPU workloads:

```text
Vision
Visual Encoder
World Model
Action Policy
VLM
```

The hard physical control path remains outside the GPU dependency chain.

---

# 62. Compute Degradation

If AI resources become constrained:

```text
Reduce VLM frequency
        ↓
Reduce expensive visual processing
        ↓
Reduce background inference
        ↓
Reduce non-critical AI workloads
        ↓
Preserve RT motion and safety
```

The principle is:

> **Reduce intelligence before reducing safety-critical physical control.**

---

# 63. Edge Deployment Profile

The primary Orin NX profile uses:

```text
Small Visual Encoder
+
Compact World Model
+
Small Action Policy
+
Small Reflex Model
+
Event-Driven Cognitive Model
+
RT Motion Core
+
Safety MCU
```

Initial model-size targets are:

|Component|Initial target|
|---|--:|
|Fast perception|10–50M parameters|
|Semantic perception|50–300M|
|World model|20–100M|
|Action policy|20–100M|
|Reflex|1–10M|
|Cognitive model|Approximately 1–3B quantized|

These are engineering targets, not proven runtime guarantees.

---

# 64. Memory and Compute Feasibility

A model fitting into physical memory is not sufficient evidence of feasibility.

Feasibility must be evaluated across:

```text
Memory capacity
+
Memory bandwidth
+
Compute throughput
+
Latency
+
Thermal load
+
Concurrent workload contention
```

For every model, measure:

- Model memory
    
- Activation memory
    
- Runtime buffers
    
- Inference latency
    
- Memory traffic
    
- GPU utilization
    
- CPU utilization
    
- Power
    
- Temperature

---

# 65. Generalist Deployment Profile

A larger deployment target may use a higher-capacity AI platform.

This profile can support:

- Larger VLA models
    
- Larger visual backbones
    
- More context
    
- Larger world models
    
- More generalist action policies

The physical-control hierarchy remains unchanged.

The hardware changes.

The safety principles do not.

---

# 66. GR00T Relationship

VAYN-6.2 does not define GR00T as an internal mandatory component.

Instead, a GR00T-class generalist system may serve as:

- A benchmark
    
- A teacher
    
- A high-capacity deployment option
    
- A source of demonstrations

This avoids conflating a large generalist VLA with the smaller edge policy.

---

# 67. Teacher–Student Strategy

A possible development strategy is:

```text
Large Generalist Teacher
        ↓
Robot-specific fine-tuning
        ↓
Demonstrations
        +
Corrective rollouts
        ↓
Student Policy
        ↓
Orin NX
```

This strategy is experimental.

The student is not assumed to retain all teacher capabilities.

The initial student target should be:

- Robot-specific
    
- Embodiment-specific
    
- Skill-specific where appropriate

---

# 68. Training Architecture

Training is staged.

## Stage 1 — Perception

Train:

- Object detection
    
- Tracking
    
- Depth
    
- Pose
    
- Visual representation
    
- Contact perception

---

## Stage 2 — State Estimation

Train and validate sensor fusion under:

- Noise
    
- Bias
    
- Dropout
    
- Timing error
    
- Encoder error
    
- Contact uncertainty

---

## Stage 3 — Prediction

Train:

```text
S_phys + action
→ future state
```

using estimator outputs rather than only perfect ground-truth states.

---

## Stage 4 — Action Policy

Suggested progression:

```text
Behaviour Cloning
        ↓
Simulation Training / RL
        ↓
Disturbance Training
        ↓
Controlled Real-World Fine-Tuning
```

---

## Stage 5 — Reflex

Train using:

- Slip
    
- Push
    
- Impact
    
- Unexpected contact
    
- Sensor noise
    
- Sensor dropout
    
- Delays
    
- Actuation disturbances

---

## Stage 6 — Cognitive Model

Train/configure the cognitive system independently.

Output:

```text
Task
+
Skill
+
Parameters
+
Constraints
```

rather than direct motor commands.

---

# 69. Training With Deployment Errors

Downstream modules must be trained using the conditions they will see during deployment.

Training should include:

```text
sensor noise
state-estimation error
visual staleness
latency
timestamp jitter
dropped frames
contact uncertainty
actuation delay
communication jitter
```

This prevents the system from depending on unrealistic perfect information.

---

# 70. Data Architecture

The robot should record multi-rate synchronized information.

## High Rate

Potentially:

```text
IMU
Joint encoders
Motor current
Torque
Force
Contact
Tactile
```

## Medium Rate

```text
Physical state
Policy state
Policy references
Reflex residuals
Controller state
```

## Vision Rate

```text
Images
Visual features
Object tracks
Scene state
```

## Event-Driven

```text
VLM decisions
Task transitions
Skill transitions
Faults
Contacts
Mode transitions
```

---

# 71. Replay Infrastructure

All critical experiments should be replayable offline.

```text
Robot Run
     ↓
Recorded Sensor Stream
     ↓
Offline Replay
     ↓
New Model
     ↓
Comparison
```

Replay should preserve, where possible:

- Original timestamps
    
- Sequence IDs
    
- Sensor order
    
- Data age
    
- Policy outputs
    
- Mode transitions

This allows new models to be evaluated without repeating the entire physical experiment.

---

# 72. Versioned Interfaces

Required interface families include:

```text
STATE_V1
VISUAL_FEATURE_V1
TASK_V1
ACTION_V1
CONTACT_V1
SAFETY_V1
```

These interfaces must be version-controlled.

A downstream model must not silently receive a changed representation after an upstream model update.

---

# 73. STATE_V1

Conceptual content:

```text
timestamp
sequence_id

base_pose
base_velocity

joint_position
joint_velocity

torque_estimate

contact_state
contact_probability

COM
COM_velocity

uncertainty
```

The exact field count is embodiment-dependent.

---

# 74. VISUAL_FEATURE_V1

Conceptual content:

```text
timestamp
sequence_id
frame_id

feature representation
object information
scene metadata

confidence
valid_until
```

The representation is designed for policy consumption rather than human readability.

---

# 75. TASK_V1

Conceptual content:

```text
task_id
skill_type
object_id
target
parameters
constraints
priority
timestamp
valid_until
```

The task contract should distinguish required from optional fields.

---

# 76. ACTION_V1

Conceptual content:

```text
timestamp
sequence_id
skill_id
reference_type
frame_id
motion reference
constraints
confidence
valid_until
```

The motion reference is skill-dependent.

Examples:

```text
walking
→ base velocity + footstep targets

manipulation
→ end-effector + joint + force targets

recovery
→ COM + foot placement + posture
```

---

# 77. CONTACT_V1

Conceptual content:

```text
timestamp
sequence_id
contact_state
contact_probability
contact_location
force estimate
confidence
```

This interface allows contact information to be shared between:

- State estimation
    
- Prediction
    
- Manipulation policy
    
- Reflex
    
- Safety

---

# 78. SAFETY_V1

Conceptual content:

```text
timestamp
sequence_id

motor_enable
fault_state

joint limits
velocity limits
torque limits
thermal limits

E-stop state
watchdog state

controller heartbeat
```

The Safety MCU maintains its own hardware-level safety state independently.

---

# 79. Command Expiration

When an `ACTION_V1` command expires:

```text
expired command
      ↓
reject
      ↓
bounded continuation if permitted
      ↓
RT fallback reference
```

The maximum continuation duration is skill-specific.

No indefinite stale-command execution is permitted.

---

# 80. Mode Management

VAYN-6.2 uses explicit operating modes.

```text
FULL
COGNITIVE_DEGRADED
PREDICTION_DEGRADED
VISION_DEGRADED
POLICY_DEGRADED
AI_OFFLINE
RT_DEGRADED
HARDWARE_FAULT
EMERGENCY
```

Transitions must be defined and logged.

---

# 81. Full Mode

```text
Cognition
+
Perception
+
Prediction
+
Action Policy
+
Reflex
+
RT Motion Core
+
Safety MCU
```

This is the nominal operating condition.

---

# 82. Cognitive-Degraded Mode

```text
No VLM / limited reasoning
        ↓
Current skill continues
        ↓
Task manager operates from existing state
```

Physical control continues normally.

---

# 83. Prediction-Degraded Mode

```text
Learned predictor unavailable
        ↓
Kinematic / physics prediction
or
current-state control
```

The policy must have been trained/evaluated for the relevant degraded representation.

---

# 84. Vision-Degraded Mode

```text
Vision unavailable
        ↓
IMU
+
Encoders
+
Force
+
Tactile
+
RT control
```

Depending on the task:

- Slow down
    
- Restrict behavior
    
- Complete current safe motion
    
- Transition toward fallback mode

---

# 85. Policy-Degraded Mode

If the action policy becomes unavailable:

```text
RT Motion Core
        ↓
fallback reference
        ↓
stabilization
```

The robot does not simply freeze its last neural command indefinitely.

---

# 86. AI-Offline Mode

If the Orin completely fails:

```text
RT Motion Core
        +
Safety MCU
```

remain active.

The RT Motion Core determines the state-dependent response.

---

# 87. RT-Degraded Mode

If the RT controller reports degraded operation:

```text
Safety MCU
        ↓
evaluate fault
        ↓
hardware-defined mitigation
```

The robot is not assumed to retain full balance capability unless the remaining hardware supports it.

---

# 88. Emergency Mode

Emergency handling is determined by:

- Fault type
    
- Robot posture
    
- Motion state
    
- Actuator properties
    
- Environmental conditions
    
- Hazard analysis

Possible outcomes include:

- Constrained control
    
- Controlled stop
    
- Protective posture
    
- Braking
    
- Controlled torque-off
    
- Motor disable

---

# 89. Power and Thermal Management

A Power/Thermal Manager monitors:

- GPU temperature
    
- CPU temperature
    
- System power
    
- Battery state
    
- Battery current
    
- Motor temperature
    
- Controller temperature

When resources are limited:

```text
Reduce expensive AI
        ↓
Reduce VLM
        ↓
Reduce visual workload
        ↓
Reduce background computation
        ↓
Maintain physical control
```

Safety-critical control should not be the first subsystem sacrificed for power or temperature.

---

# 90. Cybersecurity

The system should provide:

- Secure boot
    
- Signed firmware
    
- Signed model packages
    
- Authenticated software updates
    
- Versioned configuration
    
- Rollback
    
- Local recovery image
    
- Network isolation of safety controller
    
- Authenticated control communication

No remote software interface should bypass the RT safety and control path.

---

# 91. OTA and Model Rollback

Model updates should use controlled deployment.

```text
Candidate Model
       ↓
Offline Validation
       ↓
Regression Testing
       ↓
Deployment Package
       ↓
Versioned Installation
       ↓
Runtime Monitoring
       ↓
Rollback if required
```

The active model version should always be identifiable.

---

# 92. Online Adaptation

Uncontrolled continuous model updates are not part of the baseline architecture.

Local adaptation can be explored experimentally.

Core model changes must pass through:

```text
Data Collection
→ Training
→ Validation
→ Regression
→ Controlled Deployment
```

---

# 93. Latent Interface Stability

If learned latent representations are used internally, they must have versioned contracts.

Example:

```text
LATENT_V1
LATENT_V2
```

A downstream model must not silently consume a changed latent distribution.

Where possible, stable explicit interfaces should be preferred over undocumented latent coupling.

---

# 94. Latency Architecture

Total robot response time is represented as:

```text
L_total =
    L_sensor
  + L_readout
  + L_transport
  + L_perception
  + L_state
  + L_prediction
  + L_policy
  + L_reference
  + L_RT
  + L_actuation
```

The system must measure these components individually.

No single value should be called "the robot latency" unless the measurement definition is explicitly stated.

---

# 95. Prediction Horizon Selection

Prediction horizon should be derived from measured system latency and task dynamics.

Longer prediction:

```text
more latency compensation
+
more accumulated prediction error
```

Shorter prediction:

```text
less prediction error
+
less latency compensation
```

The correct horizon is therefore task- and system-dependent.

---

# 96. Contact Prediction Limitation

Prediction should be expected to become less reliable around:

- Impacts
    
- Unexpected contact
    
- Slip
    
- Sudden friction changes
    
- Unmodeled interaction

The architecture therefore uses:

```text
Prediction
+
Uncertainty
+
Reactive sensing
```

instead of relying entirely on long-horizon prediction.

---

# 97. Locomotion Architecture

Locomotion follows:

```text
Task
 ↓
WALK skill
 ↓
Locomotion policy
 ↓
Motion reference
 ↓
Optional bounded reflex
 ↓
Command Arbiter
 ↓
RT Motion Core
 ↓
Stabilization
 ↓
Impedance Control
 ↓
Actuator
```

The RT Motion Core remains the final physical authority.

---

# 98. Manipulation Architecture

Manipulation follows:

```text
Task
 ↓
Object understanding
 ↓
Manipulation skill / free-form policy
 ↓
Visual features
+
Physical state
+
Tactile / force
 ↓
Action Policy
 ↓
Motion reference
 ↓
Contact Reflex
 ↓
Command Arbiter
 ↓
RT Motion Core
 ↓
Impedance Control
 ↓
Actuator
```

---

# 99. Research Hypotheses

VAYN-6.2 should primarily test the following.

## H1 — Contact Reflex

A tactile/force-based bounded residual improves manipulation performance under contact disturbances.

---

## H2 — Latency-Compensated Prediction

Hybrid prediction improves closed-loop performance under realistic sensing/inference latency compared with no prediction and physics-only baselines.

---

## H3 — Event-Driven Cognition

Semantic event-driven escalation reduces expensive reasoning workload without unacceptable task degradation.

---

# 100. Ablation Framework

Each hypothesis is evaluated independently.

```text
Baseline
      ↓
+ Prediction
      ↓
+ Reflex
      ↓
+ Event Cognition
```

Prediction specifically uses:

```text
No Prediction
Kinematic
Physics
Learned Residual
Hybrid
```

Reflex specifically uses:

```text
No Reflex
MLP
GRU
LNN/CfC
```

This ensures that the architecture is evidence-driven.

---

# 101. Performance Metrics

## Control Metrics

- Average latency
    
- 99th-percentile latency
    
- Worst observed latency
    
- Deadline miss rate
    
- Control jitter
    
- Sensor-to-actuator latency

---

## Prediction Metrics

- Position error
    
- Velocity error
    
- COM prediction error
    
- Contact classification
    
- Multi-step error growth
    
- Uncertainty calibration

---

## Reflex Metrics

- Recovery success
    
- Reaction time
    
- Residual magnitude
    
- Overshoot
    
- Stability impact
    
- Contact-force error

---

## Locomotion Metrics

- Fall rate
    
- Recovery rate
    
- Foot-placement error
    
- COM tracking
    
- Walking stability
    
- Energy consumption

---

## Manipulation Metrics

- Task success
    
- Slip recovery
    
- Contact-force error
    
- Object-placement error
    
- Grasp stability
    
- Collision response

---

## Hardware Metrics

- GPU utilization
    
- CPU utilization
    
- Memory usage
    
- Memory bandwidth
    
- Power
    
- Temperature
    
- Thermal throttling

---

# 102. Feasibility Criteria

A system component is deployable only when:

### Memory

```text
weights
+
activations
+
runtime buffers
+
system overhead
<
available memory
```

### Compute

```text
worst-case workload
<
available compute margin
```

### Timing

```text
worst-case latency
<
allocated deadline
```

### Communication

```text
transport
+
queueing
+
jitter
<
allocated timing budget
```

### Thermal

```text
sustained workload
<
thermal capability
```

### Safety

```text
AI failure
≠
loss of safety supervision
```

---

# 103. Architecture Freeze Rules

VAYN-6.2 is considered frozen at the structural level.

The architecture should not be redesigned merely because:

- A model needs tuning
    
- A specific neural network fails
    
- A parameter needs adjustment
    
- A frequency needs adjustment
    
- An experimental component provides no benefit

Experimental components can be removed without reopening the complete architecture.

---

# 104. Conditions for Reopening the Architecture

The freeze may be reopened if measurements show a structural failure such as:

```text
RT compute margin fundamentally insufficient
```

```text
Orin-to-RT communication cannot meet required timing
```

```text
Actuator architecture cannot support required failure behavior
```

```text
RT stabilization cannot meet required agility
```

```text
A required interface is physically infeasible
```

```text
Hardware architecture fundamentally conflicts with the safety requirements
```

These are architecture-level failures.

---

# 105. Experimental Failure Does Not Automatically Break the Architecture

For example:

```text
LNN performs no better than GRU
```

Result:

```text
remove LNN
```

not:

```text
redesign VAYN
```

Similarly:

```text
World model provides negligible improvement
```

Result:

```text
remove learned residual
```

while retaining:

```text
kinematic / physics prediction
```

if that remains useful.

---

# 106. Development Phases

## Phase 1 — Physical Control Foundation

Build:

```text
Actuators
+
Motor Drivers
+
Safety MCU
+
RT Motion Core
+
State Estimator
+
Stabilization
+
Impedance Control
```

This system must operate without the AI computer.

---

## Phase 2 — Baseline Robot Behavior

Implement:

```text
Baseline Locomotion
+
Baseline Manipulation
```

before introducing research components.

---

## Phase 3 — Visual Perception

Add:

```text
Visual Encoder
+
Object Tracking
+
Visual Feature Cache
```

---

## Phase 4 — Hybrid Prediction

Add:

```text
Kinematic / Physics baseline
+
Learned residual
+
Contact prediction
```

Run the prediction ablation.

---

## Phase 5 — Reflex

Add:

```text
Tactile / Force Reflex
```

Evaluate manipulation and locomotion separately.

---

## Phase 6 — Cognitive Layer

Add:

```text
VLM
+
Task Manager
+
Event Manager
```

---

## Phase 7 — Generalist Benchmark

Evaluate against appropriate large-model baselines.

---

# 107. Minimum Viable VAYN-6.2

The minimum functioning architecture is:

```text
Safety MCU
+
RT Motion Core
+
State Estimator
+
Stabilization
+
Impedance Control
+
Baseline Locomotion
+
Baseline Manipulation
+
Basic Perception
```

The following are optional research additions:

```text
World Model
Reflex
Flow Matching
VLM
Event Manager
Teacher/Student Distillation
Free-Form Policy
```

This allows the physical robot platform to become functional before all AI components are complete.

---

# 108. Development Environment

The development stack should maintain separate environments for:

### Simulation

- Robot dynamics
    
- Sensor simulation
    
- Disturbance injection
    
- Policy training
    
- Prediction experiments

### Offline Evaluation

- Dataset replay
    
- Model comparison
    
- Latency profiling
    
- Safety scenario replay

### Hardware-in-the-Loop

- Real actuators
    
- Real controller
    
- Simulated environment
    
- Fault injection

### Physical Robot

- Constrained real-world experiments
    
- Progressive autonomy
    
- Human-supervised tests

---

# 109. Hardware-in-the-Loop Testing

Before autonomous physical operation, test:

```text
Sensor dropout
Communication loss
Orin shutdown
RT heartbeat loss
Stale action
Invalid action
Encoder fault
Motor-current anomaly
Temperature fault
E-stop
```

The purpose is to verify the degradation architecture independently of nominal AI performance.

---

# 110. Safety Test Sequence

The recommended sequence is:

```text
No AI
 ↓
RT controller only
 ↓
RT + safety MCU
 ↓
Add baseline policy
 ↓
Add perception
 ↓
Add prediction
 ↓
Add reflex
 ↓
Add cognition
```

Each added component must preserve previously verified safety behavior.

---

# 111. Logging Requirements

Log at minimum:

```text
sensor timestamps
state estimates
visual feature timestamps
task state
policy outputs
reflex outputs
arbitrated commands
safety decisions
controller mode
fault events
model versions
temperature
power
```

Every autonomous run should be reconstructable from its logs to the greatest practical extent.

---

# 112. Model Management

Every deployed model must have:

```text
model_id
version
training dataset version
configuration version
interface version
quantization format
deployment runtime
```

Model changes must be traceable.

---

# 113. Reproducibility

Every experiment should record:

- Robot configuration
    
- Software version
    
- Model version
    
- Controller configuration
    
- Sensor configuration
    
- Environment
    
- Test condition
    
- Random seed where applicable
    
- Hardware power mode
    
- Thermal state

This prevents performance claims that cannot be reproduced.

---

# 114. Safety Standards Strategy

VAYN-6.2 does not assign a fixed SIL, PL, or equivalent safety target before hazard analysis.

The process is:

```text
Application
 ↓
Hazard Identification
 ↓
Risk Assessment
 ↓
Safety Functions
 ↓
Required Risk Reduction
 ↓
Applicable Standards
 ↓
Implementation
 ↓
Verification
```

Standards selection must depend on the robot's intended application and operating environment.

For industrial dynamically stable robots, ISO/CD 25785-1 is relevant to safety requirements for actively controlled dynamically stable industrial mobile robots, including bipedal robots, but remains under development.

For service-robot applications, ISO/FDIS 13482 is under approval and is intended to replace ISO 13482:2014; applicability depends on the deployment context.

---

# 115. Long-Term Learning Architecture

A long-term learning pipeline may be:

```text
Robot Experience
      ↓
Data Collection
      ↓
Dataset Curation
      ↓
Offline Training
      ↓
Evaluation
      ↓
Regression
      ↓
Candidate Model
      ↓
Controlled Deployment
      ↓
Monitoring
      ↓
Rollback if required
```

The robot is therefore part of a controlled learning loop rather than an uncontrolled self-modifying system.

---

# 116. Core Architectural Tradeoffs

VAYN-6.2 intentionally accepts the following tradeoffs.

### Generality vs. Edge Efficiency

Large generalist policies offer greater behavioral coverage.

Small policies provide better edge deployment efficiency.

---

### Structured Skills vs. Free-Form Behavior

Structured skills provide:

- Safety
    
- Testability
    
- Predictability

Free-form policies provide:

- Generality
    
- Long-tail behavior
    
- Compositionality

The architecture supports both.

---

### Prediction Horizon vs. Prediction Accuracy

Longer prediction compensates more latency but accumulates more error.

Shorter prediction is more accurate but compensates less latency.

---

### Reflex Authority vs. Policy Stability

More reflex authority enables stronger correction.

Too much authority can interfere with the nominal policy.

Therefore reflex authority is bounded and experimentally determined.

---

### Large Model Capability vs. Hardware Constraints

More parameters do not automatically produce more useful edge capability.

The deployment model must fit:

- Memory
    
- Compute
    
- Timing
    
- Thermal
    
- Communication constraints

---

# 117. What VAYN-6.2 Does Not Claim

VAYN-6.2 does not claim:

- That a parameter count guarantees intelligence.
    
- That active MoE parameters equal the total capability of a dense model.
    
- That Flow Matching automatically produces safe motion.
    
- That trajectory smoothness automatically creates physical compliance.
    
- That CUDA scheduling provides deterministic hard real-time behavior.
    
- That a learned world model can perfectly predict contact events.
    
- That an LNN is automatically superior to an MLP or GRU.
    
- That the Orin NX can run every proposed model at every target rate.
    
- That any numerical latency target is guaranteed before measurement.
    
- That a small student model retains all generality of a large teacher.
    
- That online learning is automatically safe.
    
- That vision alone is sufficient for physical safety.
    
- That cutting motor power is a universal safe-state strategy.
    
- That the architecture is superior to current leading robot systems before comparative evaluation.

---

# 118. Primary Research Differentiators

The architecture intentionally narrows its research claims.

The strongest candidates are:

## 1. Manipulation Contact Reflex

Use tactile and force information to provide a bounded residual that improves contact-rich manipulation.

---

## 2. Latency-Compensated Hybrid Prediction

Combine:

```text
known physical prediction
+
learned residual
+
contact information
+
uncertainty
```

to compensate for measured system latency.

---

## 3. Event-Driven Semantic Reasoning

Use low-cost monitoring and semantic events to activate expensive cognitive reasoning only when required.

These components are hypotheses to be experimentally validated.

---

# 119. Final Architecture Summary

VAYN-6.2 can be summarized as:

```text
                         THINK
                ┌────────────────────┐
                │ Cognition / VLM     │
                │ Memory / Reasoning  │
                └─────────┬──────────┘
                          │
                     Task / Intent
                          │
                ┌─────────▼──────────┐
                │ Task / Skill Layer │
                │ Structured + Free  │
                └─────────┬──────────┘
                          │
                          ▼
                     PERCEPTION
                          │
              ┌───────────┴───────────┐
              │                       │
              ▼                       ▼
          V_scene                  S_phys
              │                       │
              └───────────┬───────────┘
                          ▼
                       PREDICT
                          │
                ┌─────────▼──────────┐
                │ Hybrid World Model │
                │ Physics + Residual │
                │ Contact + Uncertainty
                └─────────┬──────────┘
                          │
                       S_pred
                          │
                          ▼
                        MOVE
                          │
                ┌─────────▼──────────┐
                │   Action Policy    │
                │ Motion Reference   │
                └─────────┬──────────┘
                          │
                    Nominal Reference
                          │
                          +
                 Bounded Reflex Residual
                          │
                          ▼
                ┌──────────────────────┐
                │   RT MOTION CORE     │
                │                      │
                │ State Estimation     │
                │ Command Arbitration  │
                │ Safety Validation    │
                │ Stabilization        │
                │ Fallback             │
                │ Trajectory Generation│
                │ Impedance Control    │
                └──────────┬───────────┘
                           │
                         Robot

                      SURVIVE
                ┌──────────────────────┐
                │   Independent MCU    │
                │                      │
                │ Watchdog             │
                │ Fault Detection      │
                │ Current / Encoder    │
                │ Thermal Monitoring   │
                │ Hard Limits          │
                │ E-Stop               │
                │ Motor Enable         │
                └──────────────────────┘
```

---

# 120. Final System Principle

VAYN-6.2 is based on the following principle:

> **High-level intelligence should be allowed to fail without causing uncontrolled physical behavior.**

The architecture therefore assigns different responsibilities to different layers:

```text
THINK
    Cognition and task reasoning

PREDICT
    Physical prediction and uncertainty

MOVE
    Action policy and bounded reactive correction

SURVIVE
    RT stabilization, deterministic control, and independent safety
```

The Orin AI system provides capability.

The RT Motion Core provides continuous physical control.

The Safety MCU provides independent supervision.

The actuators execute only commands that survive the lower-level constraints.

---

# 121. Architecture-Freeze Status

VAYN-6.2 is frozen at the structural level.

The following are frozen:

```text
Four responsibility model:
THINK / PREDICT / MOVE / SURVIVE

RT Motion Core always owns stabilization

RT Motion Core owns command arbitration

RT Motion Core owns safety validation

RT Motion Core owns final actuator commands

Safety MCU is independent

Safety MCU has independent safety sensing

State-dependent fallback

Skill-specific motion references

Freshness / TTL contracts

Versioned interfaces

No AI bypass of safety

AI degradation before safety degradation

Baseline-before-novelty principle
```

The following remain parameterized:

```text
RT hardware
Actuator bus
Model sizes
Inference frequencies
Control frequencies
Visual TTLs
Prediction horizons
Command-expiration window
Reflex authority
Safety thresholds
Memory allocation
Compute allocation
```

The following remain experimental:

```text
LNN / GRU / MLP reflex model
Learned prediction residual
Flow Matching
Tactile reflex
Locomotion residual
Event-driven cognition
Teacher/student distillation
Free-form policy
```

---

# 122. Final Development Rule

After this freeze, architectural changes should be driven by measurements rather than intuition.

The development sequence is:

```text
DESIGN
   ↓
IMPLEMENT
   ↓
MEASURE
   ↓
COMPARE
   ↓
ABLATE
   ↓
VALIDATE
   ↓
DEPLOY
```

The next phase is therefore not another architecture revision.

The next phase is engineering:

```text
1. Select RT Motion Core hardware
2. Select actuator communication bus
3. Finalize actuator safety mechanism
4. Define ACTION_V1
5. Define timing budgets
6. Build RT controller
7. Build Safety MCU
8. Build baseline locomotion/manipulation
9. Instrument the complete system
10. Begin controlled ablation experiments
```

VAYN-6.2 should be considered successful only when its major claims are supported by measured evidence on the actual robot hardware.

---

# 123. Final Statement

VAYN-6.2 is not designed to maximize neural model size or architectural complexity.

It is designed to combine:

**semantic intelligence, physical prediction, learned reaction, deterministic control, and independent safety**

without requiring one subsystem to perform every function.

The resulting system follows a single architectural rule:

> **Large models provide reasoning where reasoning is valuable. Small learned models provide fast adaptation where learning is useful. Deterministic controllers provide physical stability. Independent hardware provides protection when the AI system fails.**

This is the frozen VAYN-6.2 baseline from which implementation, benchmarking, and experimental validation should proceed.
