shourya-khatiyan/Prime-TheHumanoid/obsidian-robot-vault/Research article and blogs/Locomotion Model training.md

training will majorly happen in a simulation environment, training policies using Proximal Policy Optimization (PPO), and also handling the "sim-to-real" gap.

### Our Locomotion Architecture

To achieve state-of-the-art results, our tech stack:

- **Simulation Environment:** NVIDIA Isaac Lab for massive parallelization of environments on the GPU.
    
- **RL Framework:** RSL-RL, specifically tailored for legged locomotion using PPO.
    
- **Deployment:** Exporting the trained PyTorch policy to ONNX or TensorRT, and running inference via ROS 2 on the robot's onboard compute.

### Execution Roadmap

Here is the step-by-step plan to build our locomotion brain from scratch:

1. **Building the Digital Twin (URDF/MJCF):** Export the CAD models into a URDF or MJCF file, defining the exact mass, inertia tensors, friction coefficients, and joint/actuator limits to match the physical hardware.
    
2. **Setting Up the Simulation Environment:** Install NVIDIA Isaac Lab, import the digital twin, set up procedural terrain, and configure the observation space to include joint positions, velocities, IMU data, and user velocity commands.
    
3. **Shaping the Reward Function:** Program task rewards for tracking forward velocity, apply smoothness penalties for excessive joint torque to protect the motors, and set survival rewards that penalize falling.
    
4. **Implement Domain Randomization:** Add simulated noise to the observations, randomize the robot's mass and ground friction, and apply random lateral pushes during training to ensure the policy can survive the real world.
    
5. **Train the Teacher-Student Policy:** Train a "Teacher" policy that has access to exact physics data, then train a "Student" policy to mimic those actions using only the sensors actually available on our physical robot.
    
6. **Hardware Deployment (Inference):** Export the final Student policy to ONNX, set up a ROS 2 node on the robot's compute board, and write a low-level PD control loop to track the neural network's target joint positions at a high frequency.
