shourya-khatiyan/Prime-TheHumanoid/obsidian-robot-vault/Research article and blogs/Setting up for training.md

Now that we have our URDF file, our exact next step is to import this digital twin into our physics simulator, NVIDIA Isaac Lab, to verify its physical behavior and wire up the inputs and outputs for our neural network.

**The "Drop Test" (Verifying the URDF)**
Before we attempt to train the AI, we must ensure our digital body isn't fundamentally broken. When converting CAD to URDF, tiny glitches often happen that ruin physics simulations.

- **Checking for "Explosions":** If the invisible collision boundaries of two parts (like the thigh and the shin) overlap in the URDF, the physics engine calculates an infinite collision force. The robot will instantly fly apart or "explode" the millisecond the simulation starts. We must adjust the collision meshes until the robot rests peacefully.
    
- **Verifying Joint Limits:** We will manually move the robot's joints using a digital slider. We need to ensure the knees bend the right way and that the motors stop exactly where the physical metal limits would stop them.
    
- **Testing Mass and Gravity:** We lift the robot in the virtual air and drop it. If it floats like a feather or falls impossibly fast, our mass or inertia values from the CAD export are incorrect and need to be fixed.

**Setting Up the Training Sandbox**
Once the single robot's physics are stable, we build the environment where the AI will practice.

- **The Infinite Floor:** We start with a perfectly flat, high-friction ground plane. We will not add stairs, slopes, or obstacles yet; our first milestone is simply standing up and balancing.  
    
- **Cloning the Robot:** We will write a script to spawn 4,096 identical copies of our robot in a massive grid on the screen. This allows the AI to practice walking 4,096 times faster than real time, with every clone feeding its successes and failures back into our single master policy.

**Wiring the Digital Brain (Observations & Actions)**
We must explicitly code what the neural network is allowed to "feel" (inputs) and "do" (outputs).

- **Defining the Observation Space (Sensors):** We write code to collect data from the digital robot at every fraction of a second. We bundle up the simulated IMU data (is the pelvis tilting?), the current joint angles (how far are the knees bent?), and the user command (which direction do we want to go?).
    
- **Defining the Action Space (Motors):** We configure the output channels. The neural network will spit out a target angle for each leg motor. We configure our simulated motors to move toward those target angles using the specific stiffness and damping parameters of our real-world actuators.
