shourya-khatiyan/Prime-TheHumanoid/obsidian-robot-vault/Research article and blogs/Training on a Budget.md

# Blog: Scaling VLA Model Training on a Budget: Lessons From 100+ Fine-Tunes

> https://www.roboticscenter.ai/blog/scaling-vla-training-on-a-budget

Based on the latest industry data from the Robotics Center of Silicon Valley, here is a comprehensive breakdown of the insights gained from over 100 VLA model fine-tuning runs, tailored to your goal of building an efficient, high-performance robotic brain.

---

## Part 1: Article Summary (Lessons from 100+ Fine-Tunes)

The article dispels the myth that fine-tuning a 7B-parameter Vision-Language-Action (VLA) model is restricted to elite, well-funded research labs. By analyzing hundreds of training iterations, researchers proved that high-quality, task-specific robotics policies can be trained using accessible, consumer-to-mid-tier enterprise hardware (like a single 24GB or 40GB GPU) combined with Parameter-Efficient Fine-Tuning (PEFT) methods.

The overarching takeaway is that compute is a commodity, while clean data is the actual bottleneck. The success of an embodied AI model scales primarily with data quality, task-appropriate camera placement, and rigorous physical evaluation frameworks—not the raw parameter size of the model.

---

## Part 2: The "Red Pill" Insights

These are the unfiltered realities of robot learning that challenge standard deep-learning assumptions:

- Model Size is Merely Third Place: A massive model will not save you from a messy pipeline. The literal predictors of real-world robotic success are ranked as follows: (1) Data Quality $\rightarrow$ (2) Camera Setup $\rightarrow$ (3) Model Size.
- The Loss Curve Is a Lie: Standard training loss curves do not correlate with real-world physical success. A model can display a beautifully declining loss graph while consistently crashing your humanoid hardware.
- The Data Scaling Law Secret: Expanding your dataset yields significantly better results than upgrading your model architecture. Doubling your high-quality demonstration data completely outperforms upgrading from a 1B model to a 7B model.
- Adapters Match Full Training: You do not need to rewrite or fine-tune all 7 Billion parameters. Freezing the base VLA and utilizing Low-Rank Adaptation (LoRA) reduces trainable parameters by 100x while yielding identical manipulation performance.

---

## Part 3: Actionable Evidence

To apply these insights directly to your dual-system brain development, utilize this empirical evidence:

- Quantization Constraints: If you lack massive multi-GPU clusters, you can run OpenVLA fine-tuning on a single 40GB A100 or 24GB consumer card by loading the base model in 4-bit NF4 quantization (QLoRA). It slashes memory usage in half with minimal throughput penalties.
- Hyperparameter Defaults: When initializing your System 2 LoRA adapter, set the rank explicitly to 16 or 32. Going lower (rank 8) causes the model to underfit complex, bimanual humanoid tasks; going higher (rank 64) induces rapid overfitting on limited datasets.
- Memory Optimization Stack: To prevent your edge training/inference from crashing, your codebase _must_ activate:
    
    1. FlashAttention-2: Reduces attention memory consumption by 3–4x.
    2. Gradient Checkpointing: Discards intermediate activations to halve your peak memory footprint at a modest 20–30% throughput cost.
    
- The Data Curation Threshold: Do not scale your model until you cross 500 well-curated demonstration episodes. If you have fewer than 500 episodes, a simpler, non-language-conditioned action decoder (like Octo) reliably beats a 7B model.

---

## Part 4: What We Can Learn (Applying This to Your Architecture)

Incorporate these major design principles directly into your Fused Single-Engine (System 2 + System 1) framework:

## 1. Implement Early-Stopping Based Solely on Real Rollouts

Do not let your System 2 model train indefinitely based on token accuracy. Because LoRA adapters overfit rapidly on compact robotics datasets, you must implement an evaluation checkpoint pipeline. Test the model using at least 50 simulated or real physical rollouts, and freeze training the moment real-world task success peaks, ignoring the mathematical training loss.

## 2. Standardize Your Action Normalization Immediately

The absolute most common engineering failure mode in VLA deployment is an action normalization mismatch. If the training demonstrations track joint velocities or angles in one format (e.g., radians normalized between -1 and 1) but your System 1 Fast Reactor pushes raw ticks or unnormalized values to the motors, the robot will behave erratically despite a flawless model architecture. Lock, version, and hardcode your action normalization constraints before writing a single line of your fused TensorRT engine.

## 3. Anchor Your Robot's Extrinsic Camera Matrices

Because your fused architecture directly bridges visual feature tokens to low-level motor torques, it is hyper-sensitive to spatial data. Physical camera drift (vibrations from the humanoid walking or moving its head) will alter the spatial tokens coming out of the vision encoder. If the extrinsic camera angles wander, your dense latent vectors will lose alignment, causing the reactor to miss physical targets entirely. Build a rigid physical mount for your cameras and execute a camera re-calibration sequence before every major testing session.

Given that data quality and action boundaries dictate success, let me know:

- How are you currently segmenting your training episodes (how do you mark the exact start and end frames of a task)?
- What camera hardware and mounting positions (egocentric/head-mounted vs. static workspace cameras) are you using?

I can help you design a data quality checklist and coordinate-mapping script to ensure your data format integrates seamlessly with your fused model.
