shourya-khatiyan/Prime-TheHumanoid/obsidian-robot-vault/self discussions/budget and expenditure.md

(jay) 15k[pcb] - 1200 + 99 + 149 + 25 + 89 + 99 + 35 + 418 + 398 + 799 + 49 + 85 + 300 = rs. 3745, 11255 left
(navi) 15k [workspace] = completely spent, 0 left
(shourya) 10k [gaerbox] = rs. 15k left
