shourya-khatiyan/Prime-TheHumanoid/obsidian-robot-vault/VAYN-TheUltimateBrain/From v1-v5.md

### Version 1: The Standard Modular Brain (The Bureaucracy)

**How it worked:**

In traditional robotics, engineers build the brain using separate, isolated software programs called **Nodes** (usually running on a system called ROS2). You have one Node for the cameras, one Node for the high-level AI (the thinking), and one Node for the motors (the moving).

**The Technical Translation:**
- **Inter-Process Communication (IPC):** Because these programs are isolated, they cannot share memory. To talk to each other, the vision program must take its mathematical plan, pack it into network bytes (a process called **Serialization**), send it through the computer's internal network, and the motor program must unpack it (**Deserialization**).

**Why it needed an upgrade:**
Think of IPC as inter-office mail. The vision department writes a letter, puts it in an envelope, and sends it to the motor department. This packing and unpacking takes **30 to 50 milliseconds**. For a computer, that is an eternity. If the robot slips, the legs don't get the "catch yourself" letter until 50 milliseconds later. By then, the robot is already on the floor.

### Version 2: The Monolithic Fused Engine (The Single Room)

**How it worked:**
To eliminate the inter-office mail delay, we took the massive 7-billion parameter vision AI and the fast motor AI and fused them into one single, massive software file (a `.engine` file). 

**The Technical Translation:**
- **TensorRT Engine & Subgraphs:** We compiled the math into a single file with two different "paths" (subgraphs).
- **Zero-Copy Memory:** Because they were in the same file, the vision part and the motor part could directly hand data to each other instantly. The data physically never moved inside the computer chip. The delay dropped to 0.0 milliseconds.

**Why it needed an upgrade:**
1. **SM Starvation (The Checkout Lane Problem):** The computer chip does math using physical calculator cores called **Streaming Multiprocessors (SMs)**. Think of these as checkout lanes at a grocery store. The 7-billion parameter vision model is a customer with 100 overflowing shopping carts; it takes over every single lane. When the fast motor program needs to calculate the robot's balance 200 times a second, all the lanes are blocked. The motors stall, and the robot falls.
2. **Catastrophic Coupling:** Because everything is crammed into one file, if a corrupted camera pixel causes the vision AI to crash, the motor AI dies with it. A single glitch causes the robot to instantly go limp.

### Version 3: The Tri-System Zero-Copy (The Shared Whiteboard)

**How it worked:**
We separated the vision AI and the motor AI back into two different files so a crash in one wouldn't kill the other, but we didn't go back to sending letters.

We allocated a single, permanent block of Video RAM (VRAM). The vision AI was hardcoded to write its plan to this specific memory address, and the motor AI was hardcoded to read from it. We called this the **Shared Latent Tensor**. We also introduced a middle-layer called the Cerebellum to help bridge the two speeds.

**The Technical Translation:**
- **CUDA Streams:** To fix the grocery store checkout problem, we gave the motor AI a VIP fast-pass. We put it on a "Maximum Priority Non-Blocking CUDA Stream." This means the computer chip is physically forced to pause the massive vision math, instantly calculate the motor balance, and then resume the vision math.

**Why it needed an upgrade:**
1. **L2 Cache Thrashing (The Erased Memory):** The computer has a small, ultra-fast memory area right next to the calculator cores called the L2 Cache. The massive 7-billion parameter vision model was so big it constantly flooded and erased this fast memory. The motor AI was forced to fetch its data from the slow, main RAM, causing micro-stutters.
2. **Latent Stagnation (The Blind Spot):** The big vision model was so heavy it could only update the shared whiteboard 5 times a second (every 200 milliseconds). For the 199 milliseconds in between, the motor AI was blindly acting on old instructions, completely unaware if the world had changed.

### Version 4: The Adaptive State-Space (The Lightweight Brain)

**How it worked:**
We decided the 7-billion parameter vision model was just too fat for our edge computer. We deleted it and replaced it with a sleek, 1.7-billion parameter model. Because it was so small, we could run it much faster.

**The Technical Translation:**
- **Vision-Mamba (State Space Model):** Older AIs (like ChatGPT) use a memory system that keeps a log of every word or picture they see. Eventually, this log gets so huge the computer crashes (Out of Memory). A State Space Model works like a magical ZIP file that never grows. It mathematically compresses all past memories into a fixed-size box.
- **The Thalamic Gate:** We added a motion-detector (pixel-entropy filter) to the camera. If the room is completely still, it slows the brain down to 1 thought per second to save battery. If something moves, it cranks the brain up to 10 thoughts per second.
- **1-Step Consistency Policy:** Instead of giving the motors one rigid command ("move exactly 12 inches"), the motor AI generated a **Vector Field**—a fluid range of acceptable movements.

**Why it needed an upgrade:**
1. **The Parameter Paradox (The Dumb Brain):** A 1.7-billion parameter model is blazing fast, but it doesn't have enough artificial neurons to understand complex physics. It doesn't instinctively know that a glass cup is fragile or that a lopsided box will tip over.
2. **State Dilution (Amnesia):** That magical Mamba ZIP file that never grows? It turns out that if you keep shoving new rooms and new memories into a fixed-size box, the old memories get overwritten and diluted. After walking for 5 minutes, the robot would forget what the first room looked like.
3. **Torque Chatter (Shaking Motors):** The fluid "Vector Field" motor commands gave the robot too many options. To turn those options into electrical currents for the motors 200 times a second, the math had to randomly sample the options. This statistical noise made the motors vibrate violently, stripping their physical metal gears.
4. **Photon Latency (Living in the Past):** A standard camera takes 33 milliseconds to open its shutter and collect light. Even if our AI calculates an answer in 0.0 milliseconds, it is calculating a response to a picture that is 33 milliseconds old.

### Version 5: The Final Unified Architecture (VAYN-5)

To build VAYN-5, we stopped treating the robot like a calculator and started treating it like a biological creature. We engineered ways to predict the future, manage extreme intelligence without overheating the chip, and output smooth, biological muscle movements.

Here is the absolute deep-dive into how VAYN-5 works today.
#### 1. Zero-Copy Asynchronous Execution (The Foundation)

VAYN-5 keeps the greatest success of Version 3: The Shared Whiteboard.

The entire brain runs in a single process. A block of Video RAM is pinned open. The top brain writes to it, the bottom brain reads from it. No data is ever serialized, packed, or mailed. The latency between the top brain and the bottom brain remains exactly 0.0 milliseconds. Hardware VIP lanes (CUDA streams) ensure the motors are never starved for calculator cores.

#### 2. The Thalamic Gate (Dynamic Frequency)

The motion-detector algorithm remains. By measuring **Pixel Entropy** (how many pixels change color from frame to frame), the robot knows when to pay attention. If it is staring at a wall, the brain runs at 1Hz (1 thought per second). If an object is thrown at it, the gate unlocks the hardware, allowing the brain to spike to 25Hz to track the object in real-time.

#### 3. System 2: The Cortex (The Time-Traveling Expert)

The Cortex is the high-level brain. It looks at the cameras, understands human commands, and decides the robot's main goal (the Intent). We solved both the "Dumb Brain" problem and the "Camera Lag" problem here.

- **Sparse Mixture of Experts (SMoE):** To understand complex physics, you _need_ an 8-billion parameter model. But to run fast, you _need_ a 1.5-billion parameter model. SMoE gives us both. We built an 8-billion parameter brain, but divided it into distinct "expert" pathways (e.g., an expert for grasping, an expert for walking). When the robot looks at a cup, a router instantly turns on _only_ the 1.5-billion parameters that know about cups. The rest of the brain stays asleep. We get massive, deep intelligence, but only pay the computational cost of a tiny model.

- **The Generative Latent World Model:** How do we fix the 33-millisecond camera shutter lag? We stop reacting to the current picture. We turned the Cortex into an **Autoregressive** model—an AI that predicts the future. When a camera frame comes in, the Cortex mathematically hallucinates what the _next_ 33 milliseconds of reality will look like. It builds its plan based on that hallucinated future. By the time the electrical signals reach the physical motors to move the arm, the real world has exactly caught up to the hallucination. The robot effectively neutralizes hardware lag by predicting the future.

#### 4. System 1.5: The Cerebellar Bridge (The Hot-Stove Reflex)

Even at 25Hz, the Cortex is too slow to save the robot if it steps on a patch of ice. System 1.5 is a microscopic, ultra-fast brain layer sitting right below the Cortex, acting like a human reflex.

- **High-Frequency Multimodal Injection:** The Cerebellum does not use slow cameras. It is hardwired directly to the tactile touch sensors in the fingertips, the pressure pads in the feet, and the audio microphones. It reads this data **1,000 times a second (1kHz)**.

- **Liquid Neural Network (LNN):** Standard AI ticks like a clock. An LNN is a continuous-time model; its math flows constantly like a river. If the foot slips on ice, the LNN feels the pressure change instantly. It intercepts the Cortex's plan, mathematically bends it, and sends a "throw your arms out to balance" command to the spine before the Cortex even realizes the robot is falling.

- **The Kalman Gate:** Because the LNN flows like water, the constant vibrations of the robot walking can cause the math to drift, making the robot forget its main goal (State Washout). The Kalman Gate acts as a mathematical rubber band. It allows the Cerebellum to stretch and bend the plan to dodge a rock, but it constantly pulls the math back to the Cortex's original goal, ensuring the robot always stays on task.

#### 5. System 1: The Spinal Cord (Biological Muscle)

This is the lowest level of the brain. It takes the final plan and turns it into exact electrical currents (**PWM signals**) to physically rotate the motors. We completely eliminated the "Torque Chatter" gear-stripping problem here.

- **Flow-Matching over Action Chunking:** Instead of asking the AI "where do I move next?" every single millisecond (which results in shaky, uncertain vibrations), we use a generative math formula called **Flow Matching**. This formula calculates an "Action Chunk"—a pre-drawn, perfectly smooth, 50-step curve reaching a quarter-second into the future.

- **Fluid Compliance:** Because the curve is pre-calculated and mathematically flawless, the 200Hz motor loop simply reads the next point on the curve and glides to it. All statistical noise is eradicated. The motors run silently, and if a human pushes the robot's arm, the arm yields smoothly like a biological muscle rather than fighting back like a rigid industrial machine.

#### 6. Proprioceptive Backpropagation (Dreaming and Rewiring)

VAYN-5 does not need a cloud server to get smarter. It learns from its own physical mistakes on the edge device.

- During the day, whenever System 1.5 (the Cerebellum) has to aggressively catch the robot from a fall, the system writes down an "Error Delta"—the exact mathematical difference between what the Cortex _predicted_ would happen and what physical reality _actually_ did.

- At night, when the robot is plugged into the wall in Sleep Mode, it runs a **Low-Rank Adaptation (LoRA)** script. It uses those Error Deltas to slightly tweak the weights inside the Cortex's "experts." The robot replays its physical mistakes in its sleep, permanently rewiring its high-level reasoning so it never trips over the same obstacle the next day.
