shourya-khatiyan/Prime-TheHumanoid/obsidian-robot-vault/VAYN-TheUltimateBrain/VAYN - 4.md

# VAYN-4 — Versatile Arbitrated Embodied Nervous-System

## Architecture Documentation: Adaptive State-Space Evolution

This document details the transition from VAYN-3 (Neuromorphic Tri-System Zero-Copy Pipeline) to VAYN-4 (Adaptive State-Space Architecture). The evolution is driven by four targeted physics and compute simulations designed to stress-test the VAYN-3 constraints within a bipedal humanoid framework operating on a single Jetson Orin edge device.

---

## Simulation 1: The "Blind Reflex" (Sensory Bottleneck)

**The Scenario:**
The humanoid grasps a plastic cup that immediately begins to buckle under the grip pressure, or steps on an unstable, fracturing surface like glass.

**The VAYN-3 Bottleneck:**
In the previous architecture, the 200Hz System 1 (Spinal Cord) exclusively receives proprioceptive data (joint angles and velocities). It feels the physical resistance of the cup, but lacks the sensory context to understand what the resistance means. The tactile sensors (fingertip pressure) and acoustic sensors (the sound of crushing plastic) are routed to the 5Hz System 2 (Cortex). Consequently, the Spinal Cord acts blindly for 200 milliseconds while the Cortex processes the multi-sensory data. By the time the Cortex issues a "stop gripping" command, the cup is already crushed.

**The Breakthrough:**
High-Frequency Multimodal Injection. System 1.5 (The Cerebellar Bridge) is upgraded to natively process high-frequency 1D signals. By routing 1kHz tactile arrays, force-torque sensors, and audio waveforms directly into the active shared memory layer, the architecture bypasses the slow visual cortex entirely for reactive sensory events.

### Key Terms

* **Proprioception:** The system's ability to sense its own internal state, specifically the position, velocity, and effort of its mechanical joints.
* **Modality Mismatch:** A structural flaw where high-speed physical reactions are bottle-necked by routing fast sensory data (audio/touch) through slow analytical pipelines (vision/language).
* **High-Frequency Multimodal Injection:** The architectural routing of diverse sensor types (sound, touch, force) directly into the lowest-latency control loop (System 1.5) rather than the high-latency reasoning loop (System 2).

---

## Simulation 2: The "Rigid Reaction" (Action Space Trap)

**The Scenario:**
The humanoid is shoved laterally while navigating through a densely cluttered physical environment (e.g., a room full of chairs and scattered objects).

**The VAYN-3 Bottleneck:**
System 1 is built on a Multi-Layer Perceptron (MLP). MLPs function as deterministic regression models—they calculate a single, highly optimized numerical trajectory to recover balance. If the MLP calculates that the optimal recovery step is to place the left foot precisely 12 centimeters to the left, but a chair leg occupies that exact coordinate, the system fails. The MLP cannot hold multiple valid recovery states simultaneously; it commits to one rigid plan.

**The Breakthrough:**
Consistency Policy (1-Step Diffusion). The MLP is replaced with a continuous action-space generative model. Standard diffusion models (like image generators) take hundreds of steps and are too slow for robotics. A Consistency Model is a mathematical distillation of a diffusion model that denoises and generates a result in a single step. Instead of predicting one rigid motor trajectory, it generates a "fluid distribution" or vector field of acceptable trajectories, allowing the robot to comply dynamically if a specific path is blocked.

### Key Terms

* **Multi-Layer Perceptron (MLP):** A standard feedforward artificial neural network consisting of input, hidden, and output layers, known for mapping static inputs to static outputs.
* **Deterministic Regression:** A mathematical process that always produces the exact same single output for a given input, lacking the ability to represent uncertainty or alternative options.
* **Consistency Model:** A class of generative AI models trained to map noisy data to clean data in a single computational step, enabling the generation of complex distributions in real-time (200Hz).
* **Vector Field (Action Space):** A mathematical representation where, instead of a single point (one action), the system outputs a region of valid points (multiple acceptable actions), allowing physical compliance.

---

## Simulation 3: The "Exhausted Cortex" (Compute Waste)

**The Scenario:**
The humanoid stands completely still, observing a static, empty room for 10 consecutive seconds.

**The VAYN-3 Bottleneck:**
The 7B-parameter Vision-Language-Action (VLA) Cortex operates on a hardcoded, fixed 5Hz loop. Even when nothing in the visual field changes, the system forces 35 billion parameter calculations per second. This continuously floods the Jetson Orin's L2 cache and rapidly drains the battery for zero informational gain (zero entropy).

**The Breakthrough:**
Thalamic Gating. In biological systems, the thalamus gates sensory information. VAYN-4 introduces an ultra-lightweight pixel-entropy filter at the camera intake. This filter calculates how much the scene has dynamically changed. If the scene is static, the Cortex frequency is artificially suppressed to 1Hz. If an object is thrown or a human begins speaking, the Thalamic Gate forces the Cortex to spike to 10Hz, dedicating maximum compute only when physical precision is required.

### Key Terms

* **L2 Cache Thrashing:** A hardware bottleneck where a massive model constantly overwrites the CPU/GPU's fast localized memory, forcing other critical processes to wait for slower main RAM data fetches.
* **Visual Entropy:** A mathematical measure of randomness or change in a video feed. High entropy means rapid movement or new objects; low entropy means a static, unchanging scene.
* **Thalamic Gating (Dynamic Frequency Scaling):** An architectural control mechanism that dynamically speeds up or slows down a neural network's execution loop based on the complexity and urgency of incoming sensor data.

---

## Simulation 4: The "Amnesic Memory" (VRAM Collapse)

**The Scenario:**
The humanoid is given a long-horizon, multi-room instruction: "Walk to the kitchen, locate the blue mug, carry it to the living room, and place it on the glass table."

**The VAYN-3 Bottleneck:**
System 2 relies on a standard Transformer backbone. Transformers require a Key-Value (KV) cache to remember past video frames and contextual data. As the robot traverses multiple rooms, this KV cache grows exponentially with every new frame. On a Jetson Orin NX with a hard physical limit of 16GB VRAM, the Transformer exhausts all available memory, triggering a catastrophic Out-Of-Memory (OOM) crash within minutes of active navigation.

**The Breakthrough:**
State Space Models (SSMs). The Transformer backbone is completely removed. VAYN-4 utilizes a Vision-Mamba (Vim) or Jamba architecture for System 2. Mamba-class architectures possess an $O(1)$ constant memory footprint. Instead of appending new video frames to an ever-growing list, SSMs continuously compress the context into a fixed-size hidden state. The system can process video indefinitely without consuming additional VRAM.

### Key Terms

* **Key-Value (KV) Cache:** A memory mechanism used by Transformers to store previously computed data tokens, allowing the model to "remember" the start of a sequence. Its size grows linearly or quadratically with time.
* **Out-Of-Memory (OOM) Crash:** A fatal system failure occurring when software attempts to allocate more Random Access Memory (RAM/VRAM) than the hardware physically possesses.
* **State Space Model (SSM):** A type of neural architecture (like Mamba) that maps sequences through continuous-time differential equations, allowing it to compress infinite sequences into a fixed, unchanging memory footprint (denoted mathematically as $O(1)$).

---

## The Complete VAYN-4 Stack

The integration of these four breakthroughs forms the VAYN-4 architecture. It shifts the design philosophy from maximizing brute-force computation to managing hardware attention and memory states efficiently.

### 1. System 2: The Cortex (Adaptive Reasoning)

* **Backbone:** 7B Vision-Mamba (SSM).
* **Memory:** $O(1)$ constant footprint (Infinite theoretical context).
* **Clock Speed:** Governed dynamically by the Thalamic Gate (1Hz to 10Hz).
* **Output:** Semantic Latent Vector ($Z$) and Latent Velocity ($\Delta Z$).

### 2. System 1.5: The Cerebellum (Active Extrapolation)

* **Backbone:** Multimodal Liquid Neural Network (LNN).
* **Inputs:** $Z$, $\Delta Z$, 1kHz Audio, 1kHz Tactile/Force-Torque, 1kHz Proprioception.
* **Clock Speed:** 200Hz.
* **Output:** The instantly shifted, reality-adjusted Latent Vector ($Z'$).

### 3. System 1: The Spinal Cord (Fluid Execution)

* **Backbone:** 1-Step Consistency Policy (Distilled Diffusion).
* **Inputs:** $Z'$, instant joint positions.
* **Clock Speed:** 200Hz.
* **Output:** Vector field of compliant joint torques (PWM).

### Execution Flow Diagram

```text
 [ High-Res Cameras ]                  [ Tactile Arrays / Audio / Encoders ]
          │                                              │
      [Entropy Filter]                                   │
      (Thalamic Gate)                                    │
          │                                              │
          ▼                                              ▼
┌──────────────────────────────────────────────────────────────────────────────┐
│  [ SYSTEM 2: THE CORTEX ]                  │                                 │
│  Backbone: Vision-Mamba (SSM)              │                                 │
│  Freq: DYNAMIC (1Hz to 10Hz)               │                                 │
│  Context: Infinite (O(1) memory)           │                                 │
│         │                                  │                                 │
│         │ (Outputs Z & ΔZ)                 │                                 │
│         ▼                                  │                                 │
│  ==========================================================================  │
│  ||               SYSTEM 1.5: THE CEREBELLAR BRIDGE                      ||  │
│  ||                                                                      ||  │
│  ||  Architecture: Multimodal Liquid Neural Network                      ||  │
│  ||  Inputs: Z, ΔZ + 1kHz Audio + 1kHz Tactile + 1kHz Proprioception     ||  │
│  ||  Output: Instantly Extrapolated Latent State (Z')                    ||  │
│  ==========================================================================  │
│         │                                                                    │
│         │ (Zero-Copy Transfer pointer)                                       │
│         ▼                                                                    │
│  [ SYSTEM 1: THE SPINAL CORD ]                                               │
│  Backbone: 1-Step Consistency Policy (Distilled Diffusion)                   │
│  Freq: 200 Hz                                                                │
│  Function: Generates continuous fluid action distributions                   │
│                                                                              │
└────────────────────────────────────────┬─────────────────────────────────────┘
                                         ▼
                               [ Compliant Joint Torques ]

```

### Key Terms

* **Adaptive Reasoning:** The ability of the core intelligence model to throttle its own computational speed based on the necessity of the current environment.
* **Active Extrapolation:** The mathematical process where System 1.5 does not just read data, but actively calculates and shifts the intended target before passing it downstream.
* **Fluid Execution:** The physical result of the Consistency Policy, allowing the robot's limbs to yield to unexpected physical barriers rather than breaking components trying to reach a mathematically rigid target.
