shourya-khatiyan/Prime-TheHumanoid/obsidian-robot-vault/VAYN-TheUltimateBrain/VAYN - 5.md

# VAYN-5 — Versatile Arbitrated Embodied Nervous-System

## Adaptive Generative Humanoid Control System

**System Design and Engineering Specification**
The VAYN-5 architecture is a neuromorphic, edge-native humanoid control system that resolves the strict physical trilemma of robotics: the historical inability to simultaneously achieve deep physical intuition, zero-latency execution, and hardware compliance on a strictly constrained 16GB edge device.
## Part 1: The Catalyst for VAYN-5 (The Need for the Upgrade)

Prior iterations of this architecture successfully established a shared-memory pipeline but exposed catastrophic mathematical and physical bottlenecks when forced to interact with chaotic, real-world environments. The upgrade to VAYN-5 was necessitated by four specific defects in the previous baselines:

1. **The Parameter vs. Compute Paradox:** Previous architectures attempted to use a massive 7-billion parameter model to maintain physical intuition. However, calculating 7 billion parameters at high frequencies completely monopolizes the Jetson Orin NX's Streaming Multiprocessors (SMs), causing the hardware to choke. Conversely, shrinking the model below 2 billion parameters restores speed but destroys the robot's emergent physical intuition—causing it to fail at zero-shot reasoning, such as understanding that a clear glass is solid or that an asymmetrical box will tip when lifted.
    
2. **Memory Saturation (State Dilution):** Relying purely on a State Space Model (SSM) to achieve a constant memory footprint caused catastrophic forgetting. Because an SSM continually multiplies new video data into a single, fixed-size mathematical vector, the vector eventually saturates. After several minutes of navigating a physical space, the model mathematically overwrites its oldest memories, causing the robot to forget its original instructions and starting location.
    
3. **Torque Chatter (Actuator Physics):** Using a 1-step diffusion model to generate motor commands created a probabilistic "vector field." Because physical actuators require a single absolute number (e.g., exact electrical current), the system had to mathematically sample the field at 200Hz. This high-speed statistical sampling introduced noise, causing the motors to rapidly vibrate (torque chatter)—a defect that physically strips metal gears and overheats servos in minutes.
    
4. **Photon Latency (The Time-Travel Problem):** Standard hardware cameras require approximately 33 milliseconds to open their shutters and collect enough photons to form an image. Regardless of how fast the AI calculates a response, it is always reacting to the physical world as it was 33 milliseconds ago. For a bipedal robot catching a thrown object or preventing a fall, this hardware lag guarantees spatial overshoot and missed targets.

## Part 2: The VAYN-5 Unified Architecture
VAYN-5 abandons static computing paradigms. It operates as a fully asynchronous, generative brain that predicts the future to neutralize hardware latency, relies on specialized expert pathways to maximize intelligence without choking the GPU, and outputs smooth, continuous motion curves to protect physical hardware.

### 1. Core Paradigm: Zero-Copy Asynchronous Execution

The foundation of VAYN-5 is its memory routing. In standard robotics, AI models are isolated in separate software containers, and passing data between them requires copying information from the GPU to the CPU, serializing it, and sending it over a local network socket. This introduces 30 to 50 milliseconds of lethal delay.

VAYN-5 loads its entire neural stack into a single unified process on the Jetson Orin NX. Upon boot, the operating system allocates a single, fixed block of Video RAM (VRAM). The high-level vision system is hardcoded to write its calculations directly into this memory address. The low-level motor system reads from the exact same address. Data physically never moves across the motherboard, resulting in absolute 0.0ms data-transfer latency.

To prevent the vision model from starving the hardware, the motor system runs on a maximum-priority, non-blocking CUDA stream (hardware queue). The GPU is physically forced to pause vision calculations every 5 milliseconds, instantly compute the motor commands to keep the humanoid standing, and seamlessly resume the vision math.
### 2. The Thalamic Gate: Dynamic Frequency Scaling

Continuous video processing rapidly drains batteries and generates excessive heat. If a robot is staring at a static wall, forcing the brain to compute the scene 20 times a second is computational waste.

VAYN-5 utilizes a Thalamic Gate—an ultra-lightweight pixel-entropy filter sitting directly behind the camera lenses. This algorithm calculates the amount of randomness or change between visual frames. If the scene is static, the Gate artificially suppresses the main vision model's clock speed down to 1Hz (one thought per second). If an object enters the frame or a human speaks, the Gate instantly unlocks the clock speed, allowing the brain to spike to 25Hz to track high-speed dynamics.
### 3. System 2: The Cortex (SMoE + Generative World Model)

The Cortex is the highest level of the brain, responsible for visual processing, physics intuition, and semantic intent. To solve the parameter paradox and the photon-latency problem, System 2 utilizes a highly specialized dual-architecture

- **Backbone: Sparse Mixture of Experts (SMoE).** The Cortex is structured as an 8-billion parameter model, giving it the deep physical intuition required to understand gravity, occlusion, and friction. However, it is divided into distinct "expert" neural pathways. During any single calculation, a routing algorithm only activates the 1.5 billion parameters relevant to the specific objects in view. This yields the deep intelligence of an 8B model but executes with the blazing compute speed of a 1.5B model, perfectly fitting the constraints of the edge device.

- **The Generative Latent World Model:** To defeat the 33ms camera lag, the Cortex ceases to react to current images. Instead, it operates as an autoregressive predictive engine. When a camera frame arrives, the Cortex mathematically hallucinates what the next 33 milliseconds of video will look like before it happens. It generates its intent ($Z$) based on this future state. When the physical motors actually execute the movement, the physical world has exactly caught up to the robot's hallucination, resulting in perfect temporal alignment.

### 4. System 1.5: The Cerebellar Bridge (Kalman-Gated LNN)

System 1.5 sits physically between the Cortex and the Spinal Cord. It is a microscopic, continuous-time network designed to alter the robot's plan before the motors receive it, keeping the robot alive when unexpected physical collisions occur.

- **Multimodal High-Frequency Injection:** Even a 25Hz Cortex is too slow to react to a sudden slip on ice. Therefore, tactile sensors (fingertips), pressure plates (soles), and audio microphones feed raw data into System 1.5 at a blisteringly fast 1,000Hz (1kHz).
    
- **Active Extrapolation:** If the robot steps on an unstable surface, the Liquid Neural Network (LNN) processes the tactile anomaly and instantly shifts the Cortex's intended target into a "recovery" state within milliseconds, long before the Cortex's cameras register the slip.
    
- **The Kalman Gate:** Because continuous mathematical models can "drift" or forget their original goal when exposed to constant vibration (state washout), System 1.5 features a Kalman Gate. This acts as a mathematical anchor. It allows the Cerebellum to aggressively dodge obstacles and react to slips, but acts like a spring that constantly pulls the system's focus back to the Cortex's original intent, ensuring the robot never forgets its primary objective.
### 5. System 1: The Spinal Cord (Flow-Matching Action Chunking)

The lowest level of the brain translates the heavily refined intent directly into electrical currents for the physical actuators. To solve the torque chatter that destroys gears, System 1 abandons discrete, rigid mathematical steps.

- **Architecture: Flow-Matching over Action Chunking.** Instead of calculating a single, noisy 5-millisecond motor target, System 1 calculates an entire "Action Chunk"—a smooth, continuous 50-step trajectory reaching 250 milliseconds into the future.
    
- **Fluid Compliance:** By using Flow Matching (a highly stable, deterministic variant of diffusion models), the generated motor curve is mathematically perfectly smooth. The 200Hz motor loop simply reads the next point along this pre-calculated curve. Statistical noise is eradicated, the motors run silently, and the limbs move with the compliant, fluid grace of biological muscle.
### 6. Hardware Allocation & VRAM Footprint (Jetson Orin NX 16GB)

By utilizing the Sparse Mixture of Experts and aggressive INT4 quantization via TensorRT-LLM, VAYN-5 secures absolute stability on the edge device without risking Out-Of-Memory (OOM) crashes.

|**Subsystem / Resource**|**Backbone Architecture**|**Precision**|**VRAM Allocation**|
|---|---|---|---|
|**Host OS & Drivers**|Linux, CUDA Toolkit, Camera ISPs|Native|**2.0 GB**|
|**System 2 (Cortex)**|8x1B SMoE + Generative World Model|INT4|**~5.0 GB** _(Only 1.5B active per tick)_|
|**System 1.5 (Cerebellum)**|Multimodal LNN + Kalman Gate|FP16|**0.1 GB** _(Pinned in L2/SRAM)_|
|**System 1 (Spinal Cord)**|Flow-Matching Action Chunking|FP16|**2.0 GB** _(High-precision for motors)_|
|**Sensor Buffers & Zero-Copy**|1kHz Audio, Tactile, High-Res Video, Pinned Latent Memory|FP16|**1.6 GB**|
|**Dynamic Headroom**|**AVAILABLE IDLE MEMORY**|N/A|**~5.3 GB (Free)**|

### Complete VAYN-5 Execution Flow

Plaintext

```
 [ High-Res Cameras ]                  [ Tactile Arrays / Audio / Encoders ]
          │                                              │
      [Entropy Filter]                                   │
      (Thalamic Gate)                                    │
          │                                              │
          ▼                                              ▼
┌──────────────────────────────────────────────────────────────────────────────┐
│  [ SYSTEM 2: THE CORTEX ]                                                    │
│  Backbone: 8x1B Sparse Mixture of Experts (SMoE)                             │
│  Augmentation: Generative Latent World Model                                 │
│  Freq: DYNAMIC (1Hz to 25Hz)                                                 │
│         │                                                                    │
│         │ (Outputs Intent Z Hallucinated 33ms into the future)               │
│         ▼                                                                    │
│  ==========================================================================  │
│  ||               SYSTEM 1.5: THE CEREBELLAR BRIDGE                      ||  │
│  ||                                                                      ||  │
│  ||  Architecture: Multimodal Liquid Neural Network (LNN) + Kalman Gate  ||  │
│  ||  Inputs: Z + 1kHz Audio + 1kHz Tactile + 1kHz Proprioception         ||  │
│  ||  Output: Instantly Extrapolated Latent State (Z')                    ||  │
│  ||  Location: Pinned in GPU L2 Cache (Zero Memory Thrashing)            ||  │
│  ==========================================================================  │
│         │                                                                    │
│         │ (Shared VRAM Pointer - Zero-Copy Transfer)                         │
│         ▼                                                                    │
│  [ SYSTEM 1: THE SPINAL CORD ]                                               │
│  Backbone: Flow-Matching Action Chunking                                     │
│  Freq: 200 Hz (Maximum hardware priority stream)                             │
│  Function: Generates smooth 50-step continuous motion curves                 │
│                                                                              │
└────────────────────────────────────────┬─────────────────────────────────────┘
                                         ▼
                               [ Compliant Joint Torques ]
```
