shourya-khatiyan/Prime-TheHumanoid/obsidian-robot-vault/VAYN-TheUltimateBrain/VAYN - 6.md

# VAYN-6 — Versatile Arbitrated Embodied Nervous-System

## Feasible Heterogeneous Robot Intelligence Architecture

**Version:** 6.0  
**Architecture Type:** Hierarchical, heterogeneous, real-time robotic intelligence system  
**Primary Compute Target:** NVIDIA Jetson Orin NX 16GB + independent real-time safety controller  
**Application:** Humanoid and whole-body robotic control, perception, manipulation, locomotion, and adaptive intelligence

---

# 1. Abstract

VAYN-6 is a redesigned robotic intelligence architecture intended to provide a practical separation between cognitive reasoning, physical prediction, motion generation, reflexive response, and low-level actuator control.

The architecture is designed around a central principle:

> **Different robotic problems require different computational timescales, model sizes, and reliability guarantees.**

Instead of using a single large neural architecture to perform cognition, prediction, reflexes, and motor control, VAYN-6 distributes these responsibilities across specialized layers.

The system consists of:

1. A **Cognitive Layer** for semantic understanding, task reasoning, and high-level planning.
    
2. A **Predictive World Model** for short-horizon physical-state prediction and uncertainty estimation.
    
3. An **Action Policy Layer** for whole-body and manipulation motion generation.
    
4. A **Real-Time Reflex Layer** for rapid corrective responses using proprioceptive, tactile, force, and inertial information.
    
5. A **Joint and Actuator Control Layer** for deterministic impedance, torque, velocity, and current control.
    
6. An **Independent Safety Layer** implemented outside the main neural compute system.

The NVIDIA Jetson Orin NX is treated primarily as an AI compute platform rather than as the sole real-time controller. Hard safety and actuator-control functions remain independent of Linux, CUDA, and high-level neural inference.

The architecture intentionally avoids several assumptions present in earlier versions, including direct VLM-to-motor control, large high-frequency neural models, open-loop execution of long action chunks, dependence on CUDA stream priority for hard real-time behavior, and uncontrolled online model updates.

VAYN-6 should therefore be regarded as a **research and engineering architecture with explicit feasibility constraints**, rather than as a claim that all target frequencies and latencies have already been demonstrated.

---

# 2. Design Philosophy

VAYN-6 follows six primary principles.

## 2.1 Hierarchical Timescales

Robotic intelligence operates at multiple timescales.

High-level reasoning can tolerate hundreds of milliseconds of latency, while motor control and safety cannot.

Therefore:

- Cognition operates slowly and asynchronously.
    
- World-state prediction operates at an intermediate frequency.
    
- Motion policies operate faster.
    
- Reflexes operate faster still.
    
- Joint and actuator control operate at the highest deterministic frequency.

---

## 2.2 Neural Intelligence Is Not the Final Safety Authority

Neural models are probabilistic and can fail in unexpected ways.

A neural command must therefore pass through a deterministic safety layer before reaching an actuator.

The command path is:

**Neural policy → Safety validation → Real-time controller → Motor driver → Actuator**

The safety system must be capable of disabling or constraining the robot even when the main AI computer is malfunctioning.

---

## 2.3 Physical State Is Explicit

Rather than relying entirely on an unspecified shared latent representation, VAYN-6 defines an explicit physical state representation.

The learned models may internally use latent states, but important physical quantities such as joint state, body motion, contact state, and uncertainty remain explicitly represented.

---

## 2.4 Prediction Is an Assistive Layer

Prediction is used to compensate for computational and sensing delays.

However, the robot must remain capable of operating safely when prediction becomes uncertain or inaccurate.

Prediction therefore supplements reactive control rather than replacing it.

---

## 2.5 Computation Must Match the Hardware

The Orin NX 16GB is treated as a constrained edge-compute system.

The design considers:

- Memory capacity
    
- Memory bandwidth
    
- GPU utilization
    
- CPU utilization
    
- Thermal limits
    
- Sensor-processing overhead
    
- Concurrent model execution
    
- Runtime memory allocation
    
- Worst-case latency

A model is not considered feasible merely because its weights fit into memory.

---

## 2.6 Fail Gracefully

Failure of a non-critical AI component must not automatically result in total system failure.

For example:

- VLM failure should not disable the motor controller.
    
- Vision failure should allow a degraded proprioceptive mode.
    
- World-model failure should allow fallback to direct control.
    
- Orin failure should allow the independent safety controller to place the robot into a safe state.

---

# 3. High-Level Architecture

The VAYN-6 architecture is divided into six functional layers.

```text
                       VAYN-6
                          │
              ┌───────────▼───────────┐
              │    COGNITIVE LAYER    │
              │  VLM / Task Reasoning │
              │      ~0.5–3 Hz        │
              └───────────┬───────────┘
                          │
                    Task / Skill
                          │
              ┌───────────▼───────────┐
              │     TASK MANAGER      │
              │ Skill selection       │
              │ Parameters            │
              │ Constraints            │
              └───────────┬───────────┘
                          │
              ┌───────────▼───────────┐
              │   WORLD MODEL         │
              │ State prediction      │
              │ Contact prediction    │
              │ Uncertainty           │
              │       ~10–20 Hz       │
              └───────────┬───────────┘
                          │
                    Future State
                          │
              ┌───────────▼───────────┐
              │    ACTION POLICY      │
              │ Whole-body / skill    │
              │ trajectory generation │
              │       ~25–50 Hz       │
              └───────────┬───────────┘
                          │
                  Desired Trajectory
                          │
              ┌───────────▼───────────┐
              │   REFLEX LAYER        │
              │ IMU / tactile / force │
              │ encoder feedback       │
              │      ~100–250 Hz      │
              └───────────┬───────────┘
                          │
                   Corrected Command
                          │
              ┌───────────▼───────────┐
              │   SAFETY VALIDATOR    │
              │ Limits / fault checks │
              └───────────┬───────────┘
                          │
                 Safe Joint Targets
                          │
              ┌───────────▼───────────┐
              │ JOINT CONTROL LAYER   │
              │ Impedance / Torque    │
              │ ~500–1000 Hz target   │
              └───────────┬───────────┘
                          │
                     Motor Driver
                          │
                       Actuator
```

An independent safety controller exists outside the neural architecture:

```text
             INDEPENDENT SAFETY MCU
                      │
        ┌─────────────┼─────────────┐
        │             │             │
    Watchdog      Hard Limits     E-Stop
        │             │             │
        └─────────────┼─────────────┘
                      │
                Motor Enable
```

---

# 4. Hardware Architecture

## 4.1 Main AI Computer

The main AI computer is an NVIDIA Jetson Orin NX 16GB.

It is responsible for:

- Camera processing
    
- Visual perception
    
- Object tracking
    
- World-model inference
    
- Action-policy inference
    
- High-level planning
    
- VLM inference
    
- Data logging
    
- Model management
    
- Non-critical decision making

The Orin is not treated as the sole real-time control computer.

---

## 4.2 Independent Safety Controller

A separate MCU or dedicated real-time controller is responsible for:

- Emergency stop
    
- Joint-limit enforcement
    
- Motor-enable control
    
- Torque/current limit enforcement
    
- Thermal protection
    
- Communication watchdog
    
- AI heartbeat monitoring
    
- Fault handling
    
- Safe-state transition

The safety controller must be able to respond without depending on:

- Linux scheduling
    
- CUDA
    
- VLM inference
    
- GPU availability
    
- ROS message timing
    
- High-level planning

---

## 4.3 Real-Time Controller

A deterministic CPU, MCU, or actuator-level controller handles:

- Joint control
    
- Impedance control
    
- Torque control
    
- Velocity control
    
- Trajectory interpolation
    
- Sensor fusion required for control
    
- Reflex-command execution

This layer is intentionally separated from large neural models.

---

# 5. Sensor Architecture

Sensors are divided according to the type of information they provide.

## 5.1 Fast Physical Sensors

These are primarily used by the real-time layers.

Typical inputs include:

- IMU
    
- Joint encoders
    
- Joint velocity
    
- Motor current
    
- Torque sensors
    
- Force sensors
    
- Foot-contact sensors
    
- Tactile sensors

These signals are important for determining the robot's immediate physical state.

---

## 5.2 Semantic Sensors

The main semantic sensors include:

- RGB cameras
    
- Depth cameras
    
- Stereo cameras
    
- LiDAR, if available
    
- Microphones
    
- Environmental sensors

These are primarily responsible for answering questions such as:

- What objects exist?
    
- Where are they?
    
- What is the robot being asked to do?
    
- Has the environment changed?
    
- What action is appropriate?

---

# 6. Physical State Representation

VAYN-6 defines a physical state vector:

```text
S(t) =
[
    Base Position
    Base Orientation
    Base Linear Velocity
    Base Angular Velocity

    Joint Positions
    Joint Velocities

    Estimated Joint Torques

    Contact State
    Contact Probability

    Center of Mass
    Center of Mass Velocity

    Object Tracks

    Task State

    State Uncertainty
]
```

The exact dimensions depend on the robot.

The important requirement is that the state definition is explicit and version-controlled.

---

# 7. State Estimation

The state estimator combines information from:

```text
IMU
+
Joint Encoders
+
Force / Torque Sensors
+
Tactile Sensors
+
Vision
```

to produce:

```text
Estimated Physical State S(t)
+
Uncertainty
```

A filtering method such as an EKF, UKF, factor-graph estimator, or another validated state-estimation method may be used.

A learned state estimator may also be investigated, but the baseline should remain interpretable and measurable.

---

# 8. Cognitive Layer

## 8.1 Purpose

The Cognitive Layer handles problems that require semantic reasoning rather than millisecond-level physical reactions.

Examples:

- Natural-language instructions
    
- Task decomposition
    
- Object identification
    
- Goal selection
    
- High-level planning
    
- Skill selection
    
- Contextual reasoning
    
- Long-term task memory

---

## 8.2 Operating Frequency

Initial target:

**Approximately 0.5–3 Hz or event-driven**

This is a design target rather than a guaranteed benchmark.

The cognitive system does not directly generate motor commands.

---

## 8.3 Output

The cognitive system produces structured task information.

Example:

```text
Task:
    Pick up the red cup

Skill:
    GRASP_OBJECT

Object:
    cup_03

Hand:
    right_hand

Approach:
    front

Maximum speed:
    0.3 m/s

Force constraint:
    task dependent
```

The lower-level systems determine how the movement is physically executed.

---

# 9. Task Manager

The Task Manager converts high-level reasoning into an executable skill representation.

Its responsibilities include:

- Selecting the appropriate skill
    
- Maintaining task state
    
- Supplying skill parameters
    
- Applying task constraints
    
- Handling task transitions
    
- Detecting skill completion
    
- Requesting replanning when necessary

Example skill set:

```text
WALK
REACH
GRASP
RELEASE
PUSH
PULL
SIT
STAND
TURN
RECOVER
```

The skill library should remain modular so that individual skills can be trained and evaluated independently.

---

# 10. Predictive World Model

## 10.1 Purpose

The Predictive World Model compensates for latency by predicting future physical states.

It should primarily predict **robot and environment state**, rather than generating future video frames.

Input:

```text
S(t)
+
Action A(t)
+
Contact State
+
Task Context
```

Output:

```text
S(t + Δ)
+
Uncertainty
```

for one or more future horizons.

---

## 10.2 Multi-Horizon Prediction

Example:

```text
Prediction Horizon

50 ms
100 ms
150 ms
250 ms
```

The exact horizons should be determined by measured system latency and prediction accuracy.

---

## 10.3 Contact-Aware Prediction

The world model explicitly represents contact conditions.

Possible physical modes include:

```text
FREE MOTION
FOOT CONTACT
HAND CONTACT
OBJECT CONTACT
IMPACT
SLIP
RECOVERY
```

The model may use a shared network with contact-conditioned components rather than completely independent networks.

---

## 10.4 Uncertainty

Prediction must include uncertainty.

Conceptually:

```text
Predicted Position = x
Prediction Uncertainty = σ
```

Low uncertainty permits greater reliance on prediction.

High uncertainty causes the system to rely more heavily on current sensor measurements and reactive control.

---

# 11. Action Policy

The Action Policy converts:

```text
Task
+
Current State
+
Predicted State
+
Contact Information
+
Constraints
```

into a desired motion trajectory.

Initial target rate:

**25–50 Hz**

This is a design target that must be benchmarked on the actual hardware and model implementation.

---

# 12. Receding-Horizon Action Generation

The Action Policy must not generate a long trajectory and blindly execute the complete trajectory open-loop.

Instead, VAYN-6 uses receding-horizon control.

Example:

```text
Policy generates:
250 ms future trajectory

Robot executes:
~40 ms

Policy generates:
new 250 ms trajectory

Robot executes:
next ~40 ms

Policy generates:
new trajectory
...
```

The future trajectory is continually replaced as new sensor information becomes available.

This preserves the benefits of trajectory generation while maintaining feedback.

---

# 13. Trajectory Representation

The policy does not have to output raw motor commands at every millisecond.

Instead it can generate trajectory points or motion primitives.

Example:

```text
t = 0 ms      q0
t = 40 ms     q1
t = 80 ms     q2
t = 120 ms    q3
t = 160 ms    q4
t = 200 ms    q5
t = 250 ms    q6
```

A deterministic trajectory generator then interpolates between these points.

The exact representation can be:

- Joint-space trajectory
    
- Cartesian trajectory
    
- Whole-body pose trajectory
    
- Motion primitive
    
- Velocity target
    
- Task-space target

depending on the skill.

---

# 14. Trajectory Blending

When a new policy output replaces an existing trajectory, the transition should be blended.

```text
Old Trajectory ────────┐
                       ├── Blended Trajectory
New Trajectory ────────┘
```

The blending system should maintain, as appropriate:

- Position continuity
    
- Velocity continuity
    
- Acceleration continuity

This reduces discontinuities between consecutive planning cycles.

---

# 15. Flow Matching

Flow Matching may be used as an action-generation method for multimodal motion.

Suitable applications include:

- Reaching
    
- Manipulation
    
- Whole-body movements
    
- Object interaction
    
- Motion generation

However, Flow Matching is not treated as:

- A deterministic safety mechanism
    
- A replacement for feedback control
    
- A direct 1 kHz motor controller
    
- A guarantee of smoothness across independently generated action chunks

The generated trajectories must still pass through the trajectory-management, safety, and control layers.

---

# 16. Real-Time Reflex Layer

## 16.1 Purpose

The Reflex Layer provides fast physical corrections that do not require semantic reasoning.

Inputs include:

```text
IMU
Joint Encoders
Force Sensors
Tactile Sensors
Torque Estimates
Contact State
Current Motion
```

Outputs may include:

```text
Foot-placement correction
COM correction
Joint trajectory residual
Velocity correction
Posture correction
Disturbance rejection
Emergency recovery command
```

---

## 16.2 Neural Model

The reflex model should remain small.

Candidate architectures include:

- MLP
    
- GRU
    
- Small recurrent network
    
- State-space model
    
- LNN/CfC

No single architecture is assumed to be superior without experimental comparison.

This allows the system to test whether an LNN provides an actual benefit over simpler alternatives.

---

## 16.3 Target Frequency

Initial target:

**100–250 Hz neural reflex inference**

The actual rate must be established through hardware benchmarking.

The underlying joint-control loop operates independently at a higher deterministic rate.

---

# 17. Reflex Training

The reflex policy must be explicitly trained on disturbances.

Training scenarios include:

```text
Forward Push
Backward Push
Side Push

Foot Slip
Unexpected Contact

Late Foot Placement
Incorrect Contact Detection

Arm Collision
Object Collision

Sensor Noise
Sensor Dropout
Temporary Vision Loss

Actuation Delay
Control Delay
```

The objective is to learn:

```text
Physical disturbance
        ↓
State change
        ↓
Corrective response
```

A perturbation in latent or state representation alone does not guarantee useful recovery behavior.

---

# 18. Locomotion Architecture

Legged locomotion should have its own specialized control pathway.

```text
Cognitive Layer
       ↓
WALK skill
       ↓
Locomotion Policy
       ↓
Footstep / COM Controller
       ↓
Reflex Correction
       ↓
Impedance Controller
       ↓
Actuators
```

The locomotion policy can be a compact RL policy rather than a large generative model.

This reduces compute requirements and gives the architecture a conventional fallback controller.

---

# 19. Manipulation Architecture

Manipulation follows a separate pathway.

```text
Task
 ↓
Object Identification
 ↓
Manipulation Skill
 ↓
Arm / Hand Action Policy
 ↓
Contact / Tactile Feedback
 ↓
Reflex Correction
 ↓
Impedance Control
 ↓
Actuators
```

The perception and state representation can be shared with locomotion, while the final action policy remains task-specific.

---

# 20. Impedance and Torque Control

Physical compliance must be implemented at the control level.

A conceptual joint impedance controller is:

```text
τ = Kp(qd − q)
  + Kd(q̇d − q̇)
  + τff
```

where:

- `q` = current joint position
    
- `qd` = desired joint position
    
- `q̇` = current joint velocity
    
- `q̇d` = desired joint velocity
    
- `Kp` = position stiffness
    
- `Kd` = damping
    
- `τff` = feed-forward torque

Additional limits and actuator-specific terms are required in a real implementation.

A smooth trajectory by itself does not provide physical compliance.

---

# 21. Safety Validator

All neural commands must pass through a deterministic safety validator.

The validator checks:

```text
Joint Position Limits
Joint Velocity Limits
Joint Acceleration Limits
Torque Limits
Motor Current
Temperature
Battery State
Communication Health
Collision Conditions
Robot Fall State
Command Validity
```

Example:

```text
AI requests:
Knee = 170°

Safety limit:
Knee = 0°–150°

Result:
Command rejected or constrained
```

The neural policy therefore cannot directly bypass physical safety limits.

---

# 22. Independent Safety Layer

The safety system must run independently from the primary AI process.

The MCU should monitor:

```text
Orin Heartbeat
Controller Heartbeat
Motor Driver Status
Current
Temperature
Encoder Health
Communication Timeout
Emergency Stop
```

A missing heartbeat can trigger:

```text
Safe Command
Motor Disable
Controlled Shutdown
```

depending on the failure condition.

---

# 23. GPU Scheduling

VAYN-6 does not rely on CUDA stream priority as a hard real-time preemption mechanism.

Instead, the software scheduler controls when expensive GPU jobs are launched.

Example:

```text
High-frequency:
    State / Reflex on CPU/MCU

GPU:
    Vision
    World Model
    Action Policy
    VLM
```

The GPU tasks are divided into bounded workloads where possible.

Hard real-time safety does not depend on the GPU scheduler.

---

# 24. Event-Driven Cognition

The previous concept of using raw image entropy as an attention gate is replaced with a higher-level event manager.

Example event score:

```text
Event Score =
    Semantic Novelty
  + Object Motion
  + Task Relevance
  + Scene Change
  + Prediction Uncertainty
  + Physical Anomaly
```

Possible triggers:

```text
New object detected
Important object moved
Prediction unexpectedly failed
Collision detected
Task state changed
User instruction received
Environment changed
```

The event manager decides when expensive semantic reasoning is necessary.

---

# 25. Vision Architecture

Two vision pathways are used.

## Always-On Vision

Runs continuously at a comparatively low computational cost.

Possible functions:

- Object tracking
    
- Low-resolution scene understanding
    
- Motion estimation
    
- Pose estimation
    
- Depth estimation
    
- Relevant object tracking

---

## Expensive Vision

Activated when required.

Possible functions:

- High-resolution detection
    
- Segmentation
    
- Detailed VLM reasoning
    
- Fine-grained recognition

This prevents expensive semantic models from permanently occupying the computational budget.

---

# 26. Memory Architecture

Feasibility must be considered in three dimensions:

```text
1. Memory Capacity
2. Compute Throughput
3. Memory Bandwidth
```

A model fitting into 16 GB does not mean it can run at the required frequency.

For a model with effective working-set size `W` GB running at frequency `F` Hz:

```text
Approximate full-stream traffic =
W × F GB/s
```

This is only a simplified upper-level estimate because actual traffic depends on:

- Cache reuse
    
- Tensor reuse
    
- Memory hierarchy
    
- Kernel implementation
    
- Quantization
    
- Activation traffic
    
- Weight residency

Therefore every high-frequency neural component requires actual profiling.

---

# 27. Preliminary Memory Budget

The following is an initial planning budget and is not a measured runtime allocation.

```text
Operating System + Middleware      ~2 GB
Vision / Runtime                   ~1.5 GB
World Model + Action Policy       ~1.5 GB
Cognitive Model                    ~2–3 GB
CUDA / TensorRT Buffers            ~1.5–2 GB
Shared Buffers + Logging           ~0.5–1 GB

Approximate working range          ~9–11 GB

Reserved headroom                  ~5–7 GB
```

The final memory budget must be established using the actual software stack and models.

The architecture should intentionally avoid operating close to the full physical memory limit.

---

# 28. Preliminary Model-Size Targets

These values are engineering targets for initial implementation, not proven requirements.

|Component|Initial Target|Purpose|
|---|--:|---|
|Fast Perception|10–50M|Tracking / pose / lightweight perception|
|Semantic Perception|50–300M|Higher-level vision|
|World Model|20–100M|State prediction|
|Action Policy|20–100M|Motion generation|
|Reflex Policy|1–10M|Fast physical correction|
|Cognitive VLM|~1–3B quantized|Semantic reasoning|

The architecture is intentionally biased toward smaller specialized models rather than one large model.

---

# 29. MoE Usage

Mixture-of-Experts is not required for the first implementation.

If MoE is introduced later, the architecture must explicitly specify:

- Number of experts
    
- Expert size
    
- Shared parameters
    
- Top-k routing
    
- Routing location
    
- Load balancing
    
- Prefill behavior
    
- Decode behavior
    
- Memory traffic
    
- Actual active compute

The term "active parameters" must not be interpreted as equivalent to total-model intelligence.

The system should be benchmarked using actual:

- Latency
    
- Throughput
    
- Memory traffic
    
- Quality
    
- Power

rather than parameter-count assumptions.

---

# 30. Cognitive Model Behavior During Failure

The cognitive system is asynchronous.

Therefore:

```text
VLM running normally
        ↓
Task updated

VLM temporarily unavailable
        ↓
Current skill continues

VLM permanently unavailable
        ↓
Fallback task / safe state
```

A temporary VLM delay should not interrupt the low-level controller.

---

# 31. Fault-Isolated Software Architecture

The main software stack should not be implemented as one giant process.

Recommended logical separation:

```text
Safety Controller           → Independent MCU

Real-Time Control           → RT CPU / MCU
State Estimator             → CPU
Reflex Policy               → CPU / MCU

Vision                      → GPU
World Model                 → GPU
Action Policy               → GPU
Cognitive Model             → GPU

Supervisor                  → CPU
Logger                      → CPU / Storage
```

Large data structures should use efficient shared-memory or zero-copy mechanisms where available.

Hard control loops should not depend on generic high-latency messaging.

---

# 32. Data Flow

## Sensor to Action

```text
Sensors
   ↓
State Estimator
   ↓
Current Physical State
   ↓
World Model ───────→ Predicted State
   │                       │
   └──────────┬────────────┘
              ↓
        Action Policy
              ↓
       Desired Trajectory
              ↓
       Reflex Correction
              ↓
       Safety Validator
              ↓
      Impedance Controller
              ↓
          Actuator
              ↓
        Physical Robot
              ↓
            Sensors
```

This creates the closed-loop physical control path.

---

# 33. Task-Level Data Flow

```text
User Instruction
       ↓
Cognitive Model
       ↓
Task Representation
       ↓
Task Manager
       ↓
Skill Selection
       ↓
Skill Parameters
       ↓
Action Policy
```

The cognitive model therefore influences physical behavior indirectly through structured commands.

---

# 34. Latency Model

VAYN-6 does not define robot latency as a single fixed value such as 33 ms.

Total latency is represented as:

```text
Ltotal =
    Lsensor
  + Lreadout
  + LISP
  + Ltransport
  + Lperception
  + Lstate
  + Lworld
  + Lpolicy
  + Ltrajectory
  + Lcontroller
  + Lactuation
```

The actual values must be measured on the complete hardware/software stack.

The prediction horizon should then be chosen according to measured latency.

---

# 35. Adaptive Prediction Horizon

Prediction should depend on uncertainty.

Conceptually:

```text
Low Prediction Uncertainty
        ↓
Longer useful horizon
        ↓
More reliance on planned motion
```

and:

```text
High Prediction Uncertainty
        ↓
Shorter useful horizon
        ↓
More reliance on reactive control
        ↓
Potential reduction in robot speed
```

This is especially important during contact, impacts, slips, and unexpected interactions.

---

# 36. Degradation Modes

VAYN-6 defines multiple degraded modes.

## Mode 1 — Full Intelligence

```text
Vision
+
VLM
+
World Model
+
Action Policy
+
Reflex
+
Control
```

---

## Mode 2 — No VLM

```text
Vision
+
World Model
+
Action Policy
+
Reflex
+
Control
```

---

## Mode 3 — No World Model

```text
Vision
+
Direct Policy
+
Reflex
+
Control
```

---

## Mode 4 — No Vision

```text
IMU
+
Encoders
+
Force/Tactile
+
Reflex
+
Control
```

Robot speed and behavior may be reduced.

---

## Mode 5 — AI Computer Failure

```text
Orin unavailable
       ↓
Independent controller
       ↓
Safe-state behavior
```

---

# 37. Training Architecture

VAYN-6 uses staged training rather than attempting to train the entire architecture simultaneously.

## Stage 1 — Perception

Train:

```text
Detection
Tracking
Pose
Depth
Contact perception
```

---

## Stage 2 — State Estimation

Train and validate fusion of:

```text
IMU
Encoders
Force
Torque
Tactile
Vision
```

---

## Stage 3 — World Model

Train using self-supervised temporal data.

Input:

```text
S(t) + A(t)
```

Target:

```text
S(t + Δ)
```

Potential objectives:

```text
State Prediction Loss
Velocity Prediction Loss
Contact Classification Loss
Multi-Step Consistency Loss
Uncertainty Calibration Loss
```

---

## Stage 4 — Action Policy

Start with:

```text
Imitation / Behaviour Cloning
```

then progress to:

```text
Simulation Reinforcement Learning
```

and finally:

```text
Controlled Real-World Fine-Tuning
```

---

## Stage 5 — Reflex Policy

Train using:

```text
External Perturbations
Foot Slips
Unexpected Contacts
Sensor Noise
Sensor Dropout
Delay Injection
Actuation Noise
```

---

## Stage 6 — Cognitive System

Train or configure the cognitive layer independently.

Its responsibility is:

```text
Language / Scene
        ↓
Task
        ↓
Skill
        ↓
Parameters
```

rather than direct motor control.

---

# 38. On-Device Learning

Uncontrolled nightly model updates are not part of the baseline architecture.

Instead:

```text
Robot Experience
       ↓
Data Logging
       ↓
Dataset Construction
       ↓
Offline Training
       ↓
Validation
       ↓
Regression Testing
       ↓
Candidate Model
       ↓
Controlled Deployment
```

Local adaptation may still be investigated, but any update to a core model must preserve its downstream interface.

---

# 39. Latent Interface Stability

If latent representations are used between models, the representation must be version controlled.

Example:

```text
STATE_V1
ACTION_V1
TASK_V1
CONTACT_V1
```

A downstream model must not silently receive a changed representation after an upstream model update.

This reduces interface drift.

---

# 40. Safety-Critical Design Rule

The following rule applies to the entire architecture:

> **No learned model may directly bypass the deterministic safety and actuator-control layers.**

The architecture must always preserve:

```text
AI Command
     ↓
Safety Constraints
     ↓
Controller
     ↓
Motor
```

The safety controller remains capable of overriding AI commands.

---

# 41. Primary Communication Interfaces

The architecture should define explicit interfaces between modules.

## State Interface

```text
STATE_V1

timestamp
base_pose
base_velocity
joint_positions
joint_velocities
torque_estimates
contact_state
contact_probability
object_state
uncertainty
```

---

## Task Interface

```text
TASK_V1

task_id
skill_type
object_id
target_pose
speed_limit
force_limit
priority
constraints
```

---

## Action Interface

```text
ACTION_V1

timestamp
trajectory
velocity_targets
acceleration_limits
skill_id
confidence
valid_until
```

---

## Safety Interface

```text
SAFETY_V1

joint_limits
velocity_limits
torque_limits
temperature_limits
motor_enable
emergency_stop
fault_state
heartbeat
```

These interfaces should be versioned and tested independently.

---

# 42. Performance Metrics

The architecture must be evaluated using measurable metrics.

## AI Performance

```text
Task Success Rate
Object Recognition Accuracy
Action Prediction Error
World-Model Prediction Error
Reflex Success Rate
Recovery Success Rate
```

## Real-Time Performance

```text
Average Latency
99th Percentile Latency
Worst Observed Latency
Deadline Miss Rate
Control Jitter
Sensor-to-Actuator Latency
```

## Hardware Performance

```text
GPU Utilization
CPU Utilization
DRAM Bandwidth
Memory Usage
Power Consumption
Temperature
Thermal Throttling
```

## Robotic Performance

```text
Fall Rate
Slip Recovery Rate
Trajectory Error
Contact Force Error
Balance Recovery Time
Manipulation Success
Locomotion Stability
```

---

# 43. Benchmarking Strategy

VAYN-6 should not be evaluated only as a complete architecture.

Use progressive ablation.

### Baseline

```text
Conventional perception
+
standard policy
+
standard control
```

### Experiment 1

```text
Baseline
+
VAYN Reflex Layer
```

### Experiment 2

```text
Baseline
+
Reflex
+
Predictive World Model
```

### Experiment 3

```text
Previous
+
Event-Driven Cognition
```

### Experiment 4

```text
Previous
+
Uncertainty-Aware Contact Prediction
```

Each additional component should demonstrate measurable benefit.

---

# 44. Research Hypotheses

VAYN-6 is based on the following hypotheses.

## Hypothesis 1

A dedicated fast reflex layer can improve recovery from unexpected disturbances compared with relying only on a slower high-level policy.

## Hypothesis 2

Short-horizon state prediction can reduce the effect of perception and inference latency in smooth physical motion.

## Hypothesis 3

Event-driven semantic computation can reduce unnecessary high-cost inference while preserving task-relevant reasoning.

## Hypothesis 4

Separating neural action generation from deterministic actuator control can improve safety and physical robustness.

## Hypothesis 5

A heterogeneous architecture can provide a more practical allocation of computational resources than a single large model operating across all timescales.

These are hypotheses to be tested, not predetermined conclusions.

---

# 45. Components That Are Mandatory

The minimum viable VAYN-6 implementation should include:

```text
1. State Estimator
2. Compact Action Policy
3. Reflex Controller
4. Impedance / Torque Controller
5. Safety MCU
6. Basic Vision
7. Task Manager
```

The following can be introduced incrementally:

```text
World Model
Flow Matching
VLM
Event Manager
Tactile Learning
LNN/CfC Reflex Model
Advanced Online Adaptation
```

This allows the system to function before all experimental components are completed.

---

# 46. Components That Are Experimental

The following are research components rather than guaranteed improvements:

```text
LNN / CfC Reflex Model
Learned Predictive Dynamics
Flow Matching Action Generation
Semantic Event Manager
Uncertainty-Aware Contact Prediction
On-Device Adaptation
Latent-Space Planning
```

Each should have a baseline alternative.

Examples:

```text
LNN        ↔ GRU / MLP
World Model ↔ No Prediction
Flow Model  ↔ Behaviour Cloning / RL
Event Gate  ↔ Fixed Scheduling
```

---

# 47. Major Design Constraints

VAYN-6 must respect the following constraints.

### Constraint 1 — Memory Bandwidth

High-frequency large neural models are not acceptable merely because their weights fit in memory.

### Constraint 2 — Real-Time Determinism

Hard control loops cannot depend on nondeterministic GPU scheduling.

### Constraint 3 — Safety Independence

Robot safety cannot depend solely on neural inference.

### Constraint 4 — Contact Uncertainty

Prediction must explicitly account for contact and physical discontinuities.

### Constraint 5 — Interface Stability

Model updates cannot silently change downstream representations.

### Constraint 6 — Compute Budget

Every model must have a measured runtime and memory budget on target hardware.

---

# 48. What VAYN-6 Does Not Claim

VAYN-6 does not claim:

- That a particular model size guarantees intelligence.
    
- That a particular parameter count guarantees performance.
    
- That Flow Matching automatically produces safe motion.
    
- That trajectory smoothness automatically creates physical compliance.
    
- That CUDA stream priority provides hard real-time preemption.
    
- That a prediction model can perfectly predict impacts or slips.
    
- That an LNN is automatically superior to conventional recurrent or RL policies.
    
- That the Orin NX can execute every proposed model at the target frequency.
    
- That any target latency is guaranteed before hardware benchmarking.
    
- That online model updates are automatically safe.
    
- That every component must use neural networks.

---

# 49. Feasibility Position

VAYN-6 is designed to be **architecturally feasible** on an Orin NX-class edge platform because high-frequency responsibilities are deliberately assigned to smaller models and deterministic controllers.

However, architectural feasibility is not the same as demonstrated runtime feasibility.

The following must still be measured:

```text
Exact model latency
Memory usage
DRAM traffic
GPU utilization
CPU utilization
Thermal behaviour
Sensor pipeline latency
Control latency
Action-policy frequency
Reflex-policy frequency
End-to-end timing
```

No performance target should be treated as final until it is measured on the intended hardware.

---

# 50. Recommended Initial Implementation

The first implementation should be intentionally small.

## Phase 1

Build:

```text
Sensors
 ↓
State Estimator
 ↓
Basic Locomotion / Manipulation Policy
 ↓
Reflex Controller
 ↓
Impedance Controller
 ↓
Safety MCU
```

This establishes the physical control foundation.

---

## Phase 2

Add:

```text
Vision
+
Task Manager
```

---

## Phase 3

Add:

```text
Predictive World Model
```

and measure whether latency compensation actually improves performance.

---

## Phase 4

Add:

```text
VLM / Cognitive Layer
+
Event Manager
```

---

## Phase 5

Evaluate:

```text
LNN/CfC Reflex
+
Flow Matching
+
Advanced Contact Prediction
```

against simpler baselines.

---

# 51. Final Architecture

The complete VAYN-6 system can therefore be summarized as:

```text
                    ┌──────────────────────┐
                    │      COGNITION       │
                    │ VLM / Memory / Task  │
                    └──────────┬───────────┘
                               │
                               ▼
                    ┌──────────────────────┐
                    │     TASK MANAGER     │
                    │ Skills / Constraints │
                    └──────────┬───────────┘
                               │
                               ▼
                    ┌──────────────────────┐
                    │    WORLD MODEL       │
                    │ State Prediction     │
                    │ Contact + Uncertainty│
                    └──────────┬───────────┘
                               │
                               ▼
                    ┌──────────────────────┐
                    │    ACTION POLICY     │
                    │ Whole-body / Skill    │
                    │ Receding Horizon     │
                    └──────────┬───────────┘
                               │
                               ▼
                    ┌──────────────────────┐
                    │    REFLEX LAYER      │
                    │ IMU / Force / Tactile │
                    │ Rapid Correction      │
                    └──────────┬───────────┘
                               │
                               ▼
                    ┌──────────────────────┐
                    │   SAFETY VALIDATOR   │
                    │ Limits / Fault Check │
                    └──────────┬───────────┘
                               │
                               ▼
                    ┌──────────────────────┐
                    │  IMPEDANCE / TORQUE  │
                    │       CONTROL        │
                    └──────────┬───────────┘
                               │
                               ▼
                         MOTOR DRIVERS
                               │
                               ▼
                           ACTUATORS
                               │
                               ▼
                         ROBOT BODY
                               │
                               └───────────────┐
                                               ▼
                                      SENSOR FEEDBACK
                                               │
                                               └──────→
                                             State Estimator
```

Alongside this architecture:

```text
             ┌──────────────────────────┐
             │  INDEPENDENT SAFETY MCU  │
             │                          │
             │ Watchdog                 │
             │ Joint Limits             │
             │ Torque Limits            │
             │ Thermal Protection       │
             │ E-Stop                   │
             │ Motor Enable             │
             └──────────────────────────┘
```

---

# 52. Final Design Statement

VAYN-6 is a heterogeneous robotic intelligence architecture in which semantic reasoning, predictive modelling, action generation, learned reflexes, and physical control operate at different timescales and on appropriate hardware.

The architecture intentionally places:

- **Semantic intelligence** at the high level,
    
- **Predictive intelligence** at the intermediate level,
    
- **Reactive intelligence** at the fast level,
    
- **Deterministic control** at the actuator level,
    
- **Safety supervision** outside the neural system.

The central design principle is:

> **Use large models where reasoning is valuable, small models where reaction speed matters, and deterministic control where reliability is mandatory.**

This architecture is intended to be developed and validated incrementally. Its novel components should be treated as research hypotheses and evaluated through controlled experiments and ablation studies rather than assumed to provide benefits in advance.

The final goal is not to maximize model size or architectural complexity.

The goal is to construct a robotic intelligence system that is:

**computationally feasible, physically responsive, fault-tolerant, measurable, and safe to integrate with real actuators.**
