shourya-khatiyan/Prime-TheHumanoid/obsidian-robot-vault/VAYN-TheUltimateBrain/VAYN-Link vs other models.md

# VAYN-Link — Versatile Arbitrated Embodied Nervous-System

### Part 1: How the Architecture Compares to the State-of-the-Art

**1. Figure AI (Helix 02 Architecture)**

Figure recently deleted 100,000 lines of traditional C++ control theory and replaced it with a multi-tiered neural brain:

- **System 2 (Cortex):** A Vision-Language Model (VLM) running slowly, processing language and scene semantics to set "intent".
- **System 1 (Visuomotor):** A 200Hz transformer mapping cameras and tactile fingertip sensors directly to joint targets.
- **System 0 (Spinal Cord):** A 10M-parameter neural network running at an ultra-fast **1,000Hz (1kHz)**. It takes the S1 targets and human motion data to output raw actuator torques, acting as digitized muscle memory.

**2. NVIDIA GR00T-N1**

- **System 2:** A Vision-Language Module (using NVIDIA Eagle-2) that encodes images and text into latent embeddings.
    
- **System 1:** A Diffusion Transformer (DiT) flow-matching policy running at **120Hz**, which takes the latent embeddings from System 2 via cross-attention to generate fluid motor actions.

**Where  Novelty Lies:**

Both Figure and NVIDIA typically run these massive stacks on heavy, multi-GPU systems or offboard compute clusters. Your novelty is **hardware-mapping**. By using the Multi-Engine Zero-Copy methodology, you are forcing a million-dollar dual-system VLA architecture onto a $500 Jetson Orin NX by treating TensorRT not just as an optimizer, but as an asynchronous bare-metal operating system.
