shourya-khatiyan/Prime-TheHumanoid/body parts/claw/bom.md

# Neck claw — parts to buy

One claw. Printed parts are the STEP and the 3MF, in PLA. This list is only the parts you buy or already have.

Print at 15% gyroid, 3 walls, 0.2 mm layers, 0.4 mm nozzle. Do not print solid. A solid print is about 191 g and, with the servo and a full 250 ml bottle, goes over the 500 g limit.

| Qty | Part | Size | Where it goes |
|---|---|---|---|
| 1 | Tower Pro MG995 | standard servo, 25 tooth spline, body 40 × 20 × 36.5 mm | shaft points down, ears on the carriage |
| 1 | 25T metal servo horn | disk Ø20 mm, 4 × M3 on a 14 mm diagonal | between the servo and the cam. The servo's own center screw holds it |
| 2 | Compression spring, music wire | wire 0.4 mm, mean diameter 8.0 mm, 22 active coils, free length 70 mm, outside diameter 8.4 mm | one in each carriage tube |
| 4 | M3 × 12 button screw | — | drone plate, through the four slots |
| 4 | M3 nylon lock nut | — | those four drone screws |
| 2 | M3 × 12 button screw | — | stop into the rail ends |
| 2 | M3 nut | — | side pockets in the rail ends |
| 4 | M3 × 10 button screw | — | servo ears into the carriage |
| 4 | M3 nut | — | pockets in the carriage, under the ears |
| 3 | M3 × 16 button screw | — | down through the carriage into the three posts |
| 3 | M3 nut | — | pockets in the tops of the posts |
| 4 | M3 × 8 button screw | — | cam into the metal horn. The horn holes are already threaded |
| 3 | M3 × 12 button screw | — | retainer into the housing |
| 3 | M3 nut | — | pockets in the housing, under the retainer |
| 3 | M3 × 8 button screw | — | guide into the housing |
| 3 | M3 nut | — | pockets in the housing, under the guide |
| 4 | M3 × 8 button screw | — | feet into the guide |
| 4 | M3 nut | — | under the foot ears |
| 1 | Cable tie | 2.5 mm | servo lead on the carriage |
| 120 g | PLA | — | all printed parts at 15% infill. The solid model is about 191 g |

The MG995 mounting screws in the servo bag are too small for these holes. Use the M3 screws above. The four ear holes are slots, so a clone whose holes are about 1 mm off still bolts on.

Spring rate used for the mast is Gd⁴ / (8 D³ n) with G = 80,000 MPa. The two springs together push 1.6 N when the mast is extended and 2.5 N when it is fully shortened.
