shourya-khatiyan/Prime-TheHumanoid/body parts/shoulder/parts.md

# Shoulder actuator

Z = 0 is the rear face. The axis is Z, pointing toward the arm. Masses of machined parts are from the model (`shoulder/cad/mass.txt`). Bought bearings use the catalogue mass. The exact solid is `shoulder/cad/actuator.step`. Loads and fits are from `shoulder/cad/calc.txt`. Ordering detail stays in `shoulder/bom.md`.

## Summary

This is a two-stage planetary shoulder joint, 30:1 overall (6:1 then 5:1). The envelope is a plain Ø100 mm cylinder, 103.9 mm long. Modelled parts weigh about 2,568 g at the 6082-T6 density of 2.70 g/cm³. The motor adds 336 g, so the actuator is about 2.90 kg.

At 24 V the motor runs at 2,160 rpm, the first carrier at 360 rpm, and the output at 72 rpm. Continuous output is 30 N·m. Proof torque is 50 N·m, including a 50 N·m tilt case. The motor torque constant used in the calc is 0.0919 N·m/A, so 30 N·m needs about 12.1 A and 50 N·m needs about 20.2 A.

The real actuator is metal. The stage-2 sun sees about 1,350 MPa contact stress at 30 N·m, which case-hardened 20MnCr5 can carry and aluminium cannot. The fit check is a 3D print of the machined parts. Bought parts (motor, bearings, pins, screws, dowels, spring, washers, shims, magnets, electronics) are not printed.

Milling pack A (`shoulder/cad/milling/`) is the file set for the first metal quotation. Geometry is still Rev 1.4. Materials were revised on 30 October 2026 to two alloys:

- **6082-T6:** encoder lid, housing, front cover. 6061-T6 may replace it if that is what the shop has. Use one aluminium only. No anodize on this order.
- **20MnCr5, one heat:** every steel part. Carburize the teeth only: sun-1, both planet sets, both rings, and the sun on carrier-1 front. Mask that carrier plate. Leave carrier-1 rear and both carrier-2 halves annealed. 16MnCr5 may replace 20MnCr5. No second steel, no nitriding, no tooth grinding.

The rear plate (08) is 3D-printed for this build and is not in the milling STEP. The housing is still machined for the metal plug, so a 6082-T6 plate can replace the print later. Planet pins stay purchased 52100 shaft. They are the needle race and are not a third milled alloy.

Three classes for the fit-check print (unchanged files):

- **3D print, then CNC:** 01, 15, 16, 18, 21, 22, 24, 32, 33, 36, 42, 45. The print file is `shoulder/cad/actuator_print.zip`. Part 08 is printed for this build and is not sent for milling.
- **Purchase:** everything else. Shop links are given only for the bearings and the wave spring.

### Rev 1.4: motor fit (from the first build)

The LA8308 was measured with a vernier: Ø92.0 mm, 27.5 mm flat face to flat face (hub face to rear stator face; the stub and the hex are not in that 27.5), a Ø2.9 × 8.9 mm shaft stub on the front, and a hex cap on the rear. The older 32.5 mm body length is withdrawn. The phase leads are flexible and leave the rear face at a radius of 32 mm, in a bundle about 13 mm across. Rev 1.3 had three faults against this motor:

1. **The motor could not go in.** The rear lip was Ø88 mm and the front was closed by the partition, so a Ø92 motor could not pass either end. Rev 1.4 moves the lip onto the rear plate. The plate becomes a Ø94.5 plug that goes into the housing's open rear bore, and eight radial M3 countersunk screws through the housing wall hold it. The body stays a plain Ø100 cylinder.
2. **Sun-1 hit carrier-1 and the partition.** Rev 1.3 used the catalogue height of 28.5 mm. A later reading of 32.5 mm has been withdrawn. The flat-to-flat length is 27.5 mm. The generator uses 27.5. (Sun-1 on the first build was already drilled for the stub, so the stub was not the cause.) Rev 1.4 uses the measured height, moves the gearbox forward 8.4 mm, bores sun-1 Ø3.5 × 10.5 for the 8.9 mm stub, and recesses carrier-1. Every axial gap is now 1.5 mm at the nominal shim. A shim pack (part 48) sets the axial position of the motor.
3. **The rear cap is a hex that stands out of the motor.** Across flats it is 17.2–17.4 mm, so the corners are 20.1 mm. It stands 6.7 mm past the rear stator face. A Ø10 mm cover is glued on the hex and adds 6.5 mm, so the cover face is 13.2 mm past that face. The centre hole is under the cover. The plate bore is Ø21.1 mm over the hex and Ø11 mm over the cover. The plate motor face is at Z 18.4 so the cover face (Z 6.2) stays 1.0 mm clear of the chip.

The gearbox, bearings, and gears are unchanged. They move forward with the hub. The hub face is at Z 46.9.

## 01 Encoder lid

3D print for the fit check, then CNC from 6082-T6. Quantity 1. Mass 11.3 g. Size Ø59.8 mm × 2 mm.

It is the rearmost cover, from Z 0 to Z 2. Four M2 countersunk screws on a Ø54 mm circle clamp it to the rear plate. A Ø32 opening in the centre clears the encoder board. The board screws are in the rear plate, not in this lid. A slot at 0° lets the encoder cable out. A notch at 180° clears the phase-lead slot. No anodize. The screws are a light joint at 0.3 N·m.

## 02 Lid screws

Purchase. Quantity 4. Mass 0.13 g each. M2 × 4 countersunk, ISO 7046 or ISO 14581. Grade 8.8 or A2 is enough.

They sit in the lid, heads at Z 0, threaded into the rear plate. Torque 0.3 N·m. No threadlocker.

## 03 Encoder PCB

Purchase. Quantity 1. The model assigns no mass. Size 30 × 30 × 1.6 mm FR4. The four holes are a rhombus: diagonals 24 mm and 19 mm, centre to centre. An M3 screw passes freely (Ø3.4 in the model).

It sits in the rear-plate pocket, square to the axes, from Z 2.5 to Z 4.1, on the motor axis. The 24 mm pair runs corner to corner of the board. It carries the AS5047P. A shielded SPI cable leaves through the plate groove. Keep grease off this board.

## 04 Encoder IC

Purchase. Quantity 1. The model assigns no mass. Package TSSOP-14, part AS5047P-ATSM.

It is soldered on the PCB, centred on the axis, from Z 4.1 to Z 5.2. With the 1.0 mm shim the cover face is at Z 6.2, so the air from the chip to the cover face is 1.0 mm (0.5–1.5 mm across the shim range). The cover wall thickness is not measured, so that air gap is not the magnet-to-chip gap. The die wants 35–70 mT. The glued cover's runout is not measured, so the 0.5 mm centring allowance is not closed (calc §9).

## 05 PCB screws

Purchase. Quantity 4. Mass 0.46 g each. M3 × 6 pan head, ISO 7045 or ISO 14583.

They clamp the PCB to four bosses in the rear plate, on the 24 mm and 19 mm diagonals. Torque 0.6 N·m. No threadlocker.

## 06 Magnet holder

Not in this actuator. The magnet is already glued under the motor's Ø10 mm cover. Do not machine a holder and do not put a pin in the covered centre hole.

## 07 Encoder magnet

Not a separate part. It is inside the glued Ø10 mm cover on the hex. Do not fit a second magnet.

## 08 Rear mount plate

3D-printed for milling pack A. Not in the milling STEP. A later metal plate is 6082-T6, the same alloy as the housing. Quantity 1. A Ø100 × 2 mm rim (Z 0–2) and a Ø94.5 plug from Z 2 to Z 18.4.

It is the part that bolts to the torso. The plug takes the place of the old housing lip: the motor is screwed to the plug's front face, and the plate and motor slide into the housing's open rear bore together. The rim seats on the housing's rear face at Z 2. The plug is Ø94.5 k6 in the housing's H7 bore (−25 to +32 µm). Both parts are 6082-T6, so the fit does not change with temperature. Eight M3 radial holes, tapped 6 mm deep at Z 6 on 22.5° + 45° steps, take the housing screws. It carries:

- the stator screws, 4 × M4 countersunk on a Ø40 mm circle at 45°;
- six M4 wire-thread inserts on a Ø76 mm circle for the torso, and two Ø4 torso dowels;
- the encoder pocket, and the encoder cable groove at 0°;
- the phase-lead slot at 180°: through the plate at a radius of 25–39 mm, 15 mm wide. It continues as a 5 mm deep groove in the rear face out to the rim. Bend the flexible leads flat into this groove.

The motor face of the plate is bored Ø21.1 mm for the hex (corners 20.1 mm, 0.50 mm radial clearance) and Ø11 mm for the Ø10 mm cover (0.50 mm radial). The hex bore runs from Z 12.2 to the motor face. The cover bore runs from Z 6.0 to Z 12.7. The plate does not pilot the motor. The countersunk stator screws centre it. The cable groove at 0° and the phase-lead slot at 180° stay. The stator hole pattern and the torso holes are unchanged from Rev 1.3, where they fitted the real motor. Two M4 jack-screw holes in the rim are worth adding so the plug can be pushed out. No anodize when the metal plate is made.

## 09 Plate screws

Purchase. Quantity 8. Mass 0.55 g each. M3 × 8 countersunk, ISO 10642, grade 12.9.

They go radially through the 2.75 mm housing wall into the plug, heads flush with the Ø100 surface. The housing countersinks are 0.1 mm forward of the plug threads, so tightening pulls the housing back onto the plate rim. That removes play in the direction the tilt load would lift the joint. Thread engagement in the plug is 5.25 mm, strip safety factor 5.2. At the proof case each screw carries about 260 N in shear (torque plus a 66 N·m tilt), a safety factor of 12.4. Wall bearing stress is 69 MPa. Torque 1.2 N·m with Loctite 243.

## 10 (deleted)

The plate dowels are gone. The radial screws locate the plate.

## 11 Stator screws

Purchase. Quantity 4. M4 × 16 countersunk, ISO 10642.

They clamp the motor stator to the rear plate on a Ø40 mm circle, heads toward the encoder at Z 8, through the shim pack. Thread engagement in the motor is 5.6 mm minus the shim pack: 5.1, 4.6 or 4.1 mm. The motor's M4 holes are deeper than 6 mm. At 4.1 mm engagement and 2.0 N·m the strip safety factor is 2.7 (calc §9). Use the motor maker's torque, not more than 2.0 N·m into an aluminium base. Loctite 243.

## 12 Motor stator

Purchase. Quantity 1. EaglePower LA8308, KV90, measured Ø92.0 × 27.5 mm flat to flat, 336 g for the whole motor. The model is an envelope only and assigns this part no mass.

It sits in the Ø94.5 housing bore with 1.25 mm radial clearance. The mounting face is at Z 19.4, on the 1.0 mm shim pack. The hub face is at Z 46.9. The flexible phase leads leave the rear face about 30 mm from the axis, under a cover about 11 × 5 mm, and can be bent. In this model they pass through the 15 mm plate slot at 180° and bend into the rear groove. The angle around the motor has not been measured.

## 13 Motor rotor

Purchase. Quantity 1. Part of the same LA8308. The model is an envelope and assigns no mass.

The bell runs around the stator, 1.25 mm radially inside the housing bore. Sun-1 bolts to the rotor hub face at Z 46.9, which is 1.5 mm behind the partition. The Ø2.9 × 8.9 mm front shaft stub sits in sun-1's Ø3.5 × 10.5 bore with 1.6 mm to spare. The rear cap is a hex, 17.3 mm across flats in the model (measured 17.2–17.4), standing from Z 12.7 to the mounting face at Z 19.4. The Ø10 mm magnet cover continues to Z 6.2. Sun-1 in this model is still drilled 4 × M3 on Ø31 and on Ø25. The measured rotor holes are 4 × M2 on a 38 mm circle.

## 14 Motor shaft

Purchase. Quantity 1. It is part of the motor. The model shows a Ø6 mm rod from Z 22.4 to Z 44.9. That rod's mass is not the motor weight.

The rear end is inside the motor. The hex and the magnet cover are on the rotor, outside the rear face. The front end comes out as the Ø2.9 stub.

## 15 Housing

3D print for the fit check, then CNC from 6082-T6 bar. Quantity 1. Mass 349.4 g. Ø100 mm × 90.4 mm, from Z 2 to Z 92.4, no flange.

It is the structural tube. The rear is open: the Ø94.5 bore runs through the rear face, so the motor, already screwed to the plate, slides in from behind. The plate plug fills that bore from Z 2 to Z 18.4. Eight Ø3.2 holes with 90° countersinks, at Z 6.1 on 22.5° + 45° steps, take the radial plate screws. Two notches in the rear face match the plate's cable grooves: 4 × 1 mm at 0° and 15 × 3 mm at 180°.

Inside, from back to front:

- the motor bore, to Z 48.4;
- a 2.5 mm partition (Z 48.4–50.9) with the Ø41.0 mm H8 labyrinth;
- the Ø85 mm K6 bore for ring-1;
- the Ø89 mm G7 bore for the cartridge.

Twelve cooling slots, 3 mm × 20 mm at Z 19–39, pierce the motor-bore wall. Two radial slots in the front face of the partition, 3.02–3.04 mm wide and 1.5 mm deep, let the ring-1 dowels slide as the aluminium grows. The thinnest section is the 2.75 mm wall at the motor bore. At 50 N·m it sees 1.4 MPa in torsion, and 3.7 MPa in bending at the 66 N·m tilt case, so the section is set by stiffness, not by strength. The plate-screw bearing stress is 69 MPa, against a 260 MPa yield for this bar. No anodize.

## 16 Ring-1

3D print for the fit check, then CNC from annealed 20MnCr5, the same heat as the other steel parts. Quantity 1. Mass 190.8 g. Size Ø85 mm h5 × 15.35 mm. Internal gear, 90 teeth, module 0.8.

It is fixed in the housing from Z 50.9 to Z 66.25 and is the reaction ring of the first stage. The OD is a light interference at room temperature and becomes a clearance of about 44–81 µm at 80 °C, which is why the dowels, not the fit, keep it from spinning when hot. Teeth are wire-EDM while the steel is soft, then the tooth zone is carburized to 0.12–0.18 mm and 58–62 HRC. Mask the outside diameter. Allow 0.03–0.05 mm growth and do not grind the teeth. Finish the Ø85 h5 diameter after heat treatment. Inspection: dimension between Ø1.2 mm pins, Mi = 70.813 mm, plus 0.015 / minus 0. Two Ø3 mm H7 holes, 7 mm deep from the rear face, on a Ø79.5 mm circle, take the dowels.

## 17 Ring-1 dowels

Purchase. Quantity 2. Mass 0.44 g each. ISO 8734 Ø3 × 8 mm, hardened, m6.

They are pressed into ring-1 and slide in the housing slots. Axis at radius 39.75 mm, angles 45° and 225°, from Z 49.4 to Z 57.4. At the proof load each pin sees about 110 N, 16 MPa shear. A Ø4 pin pressed into both the steel ring and the aluminium housing would bind as they grow differently, so these stay Ø3 in a slot.

## 18 Sun-1

3D print for the fit check, then CNC from 20MnCr5, carburized. Quantity 1. Mass 42.8 g. Flange Ø40 mm × 3 mm, teeth Ø16 mm × 10.4 mm face, overall length 18.2 mm. 18 teeth, module 0.8.

The flange bolts to the rotor hub face at Z 46.9–49.9. The teeth run from Z 54.7 to Z 65.1 and drive the three planet-1 gears. The rear face has a Ø3.5 × 10.5 mm bore for the motor's 8.9 mm shaft stub, and a Ø18 × 0.5 mm relief that clears the hub centre. The flange is drilled for both rotor patterns: 4 × M3 countersunk on Ø31 mm, and 4 × M3 countersunk on Ø25 mm at 45°. Use the pattern that matches the motor. Carburize to a case depth of 0.12–0.18 mm, 58–62 HRC on the teeth, core 30–40 HRC. Grade 7–8 is accepted. Do not grind the teeth. Span over 3 teeth, W3 = 6.082 mm, minus 0.015 / plus 0.

The labyrinth between this flange (Ø40 h8) and the partition bore (Ø41.0 H8) is 1.00–1.08 mm on the diameter at 20 °C. The flange front face is 1.5 mm from carrier-1, and the tooth tips are 1.5 mm from the carrier-1 front plate.

## 19 Sun-1 screws

Purchase. Quantity 4. Mass 0.38 g each. M3 × 5 countersunk, ISO 10642, grade 12.9.

They clamp sun-1 to the rotor, heads toward the gears. Only about 2 mm of thread enters the rotor, so the torque is 0.8 N·m, not 1.2. On the smaller Ø25 mm circle the slip safety factor at the 50 N·m proof is 6.4. Loctite 243. Fit the four screws to the pattern the rotor actually has.

## 20 Carrier-1 rear washer

Purchase. Quantity 1. Mass 1.0 g. Size Ø48 mm / Ø42 mm × 0.3 mm. Hardened spring steel, or a stack of shims if the standard ring is the wrong size.

It is the thrust face between the stationary housing partition and the back of carrier-1, from Z 50.9 to Z 51.2. Flatness within 0.02 mm.

## 21 Carrier-1 rear

3D print for the fit check, then CNC from annealed 20MnCr5, the same heat. Quantity 1. Mass 76.0 g. Envelope Ø60 mm × 14 mm, with three posts.

The plate is from Z 51.4 to Z 54.4. Three posts run forward to Z 65.4 on a Ø44 mm circle and are tapped M3. Three Ø8 mm R7 holes on a Ø43.2 mm circle hold planet pins 1. Do not carburize this part. The R7 fit on an h6 pin is 4–28 µm interference, so the pin cannot walk.

## 22 Carrier-1 front and sun-2

3D print for the fit check, then CNC from 20MnCr5, with the sun carburized. Quantity 1. Mass 92.0 g. Plate Ø60 mm, sun-2 teeth Ø20 mm × 10 mm face, overall about 24 mm. Sun-2 is 18 teeth, module 1.0.

The plate is from Z 65.4 to Z 68.4 and closes carrier-1. A Ø19 × 1.2 mm recess in its rear face gives the sun-1 tooth tips 1.5 mm of axial clearance. Sun-2 teeth run from Z 79.4 to Z 89.4 and drive the second stage. Three M3 countersunk holes on a Ø44 mm circle bolt it to the posts. Carburize the sun to a case depth of 0.15–0.20 mm, 58–62 HRC, and mask the plate and the pin holes so they do not carburize. Grade 7–8 is accepted. Do not grind the teeth. Span over 3 teeth, W3 = 7.609 mm, minus 0.015 / plus 0. Three Ø8 mm R7 holes take the front of planet pins 1.

## 23 Carrier-1 screws

Purchase. Quantity 3. Mass 0.66 g each. M3 × 10 countersunk, ISO 10642, grade 12.9.

They clamp the carrier-1 front plate to the posts, from the front face at Z 68.4. Torque 1.2 N·m with Loctite 243.

## 24 Planet-1

3D print for the fit check, then CNC from 20MnCr5, carburized. Quantity 3. Mass 41.6 g each. Size Ø30.4 mm × 10 mm face, bore Ø12 mm. 36 teeth, module 0.8.

They orbit at radius 21.6 mm, teeth from Z 54.9 to Z 64.9, between sun-1 and ring-1. Space them at 0°, 120°, and 240°. Carburize to 0.12–0.18 mm case, 58–62 HRC, and grind the bore after hardening. Bore Ø12 N6, roundness IT5/2, Ra at or below 0.8 µm. Span over 5 teeth, W5 = 11.008 mm, minus 0.015 / plus 0. Tooth grade ISO 1328 grade 7–8 is accepted. Do not grind the teeth. Sun-1's 10.4 mm face covers at least 9.7 mm of the planet face across the shim range.

## 25 Planet-1 needle bearings

Purchase. Quantity 3, plus 2 spares. Catalogue mass about 3.1 g each. The model envelope weighs 4.9 g and is only a stand-in. Drawn-cup needle roller bearing HK0810, 8 × 12 × 10 mm, open ends.

One sits in each planet-1 bore, from Z 54.9 to Z 64.9, on the Ø8 mm pin. Press it into the Ø12 N6 bore with a stepped mandrel on the stamped end. Design to the lower catalogue rating, dynamic capacity 3.69 kN.

Buy: [INA HK0810](https://www.noksbearings.com/brand/ina/hk0810/needle-roller-bearings-ina), [SKF HK 0810 data sheet](https://documents.klium.nl/9ad58f0c-40d4-47fb-ab4e-48a1f5b26eee/en/technical-data-sheet-skf-hk-0810-hk-0810-en.pdf).

## 26 Planet pins 1

Purchase. Quantity 3. Mass 6.6 g each. Size Ø8 mm × 17 mm, 52100 (EN31) bearing steel.

Each pin is the inner race of a planet-1 needle bearing. It runs from Z 51.4 to Z 68.4, through both carrier-1 plates, 6 mm of press in each. Through-harden to 58–64 HRC, grind h6, Ra at or below 0.2 µm. The holes are Ø8 R7 (4–28 µm interference). Do not use a g6 shaft or an m6 dowel: the needle clearance would be wrong. No threads in the pin.

## 27 Planet-1 rear washers

Purchase. Quantity 3. Mass 0.24 g each. Size Ø14 mm / Ø8.2 mm × 0.3 mm. A DIN 988 ring, 8 × 14 × 0.3, is the standard candidate. Its bore is 8.04–8.19 mm, so check that one sample spins free on the Ø8 h6 pin before buying the set.

They sit behind each planet-1, from Z 54.6 to Z 54.9, so the gear does not rub the carrier.

## 28 Planet-1 front washers

Purchase. Quantity 3. Mass 0.24 g each. Same ring as 27.

They sit in front of each planet-1, from Z 64.9 to Z 65.2.

## 29 Wave spring

Purchase. Quantity 1, plus 1 spare. Mass 8.6 g in the model. Smalley SSB-0335, carbon steel. Bore clears 71.4 mm, outside fits inside 85 mm, free height 5.59 mm, thickness 0.76 mm, rate 83 N/mm, 231 N at the 2.77 mm catalogue work height.

It sits on the front face of ring-1, around Z 66.25, and pushes the rear 61813 outer ring forward. At the real stack the work height is about 2.65–3.07 mm and the force stays about 186–252 N, which is enough to keep the front bearing loaded. It acts on the floating outer ring only. A stainless option is SSB-0335-S17. Lispring LB-0335 is the drop-in alternate.

Buy: [Smalley SSB-0335](https://www.smalley.com/wave-spring/ssb-0335).

## 30 Carrier-1 front washer

Purchase. Quantity 1. Mass 1.9 g. Size Ø40 mm / Ø24 mm × 0.3 mm. Same hardened strip as the other thrust washers.

It is the thrust face between carrier-1 and carrier-2, from Z 68.6 to Z 68.9. The two carriers turn at different speeds, so this washer is what they rub on.

## 31 Rear output bearing

Purchase. Quantity 1, plus 1 spare. Catalogue mass about 130 g. The model splits it into rings, balls, and shields and under-weighs that split. 61813-2Z/C3, 65 × 85 × 10 mm, metal shields.

It is the rear output bearing, from Z 68.9 to Z 78.9. The outer ring must slide in the cartridge so the wave spring can preload the pair. The inner ring is on the Ø65 mm j5 seat of carrier-2. Order C3. A normal-clearance bearing would be preloaded by about 13 µm after the press fit and the temperature difference. C3 keeps about 2 µm of clearance. Dynamic capacity 11.9 kN, static 11.5 kN. The spare is so the cartridge bore can be matched to the measured outer diameter, 3–10 µm larger than that measurement.

Buy: [61813-2Z listing](https://en.tradebearings.com/61813_2Z-80293.html). Confirm C3 is printed on the box. The SKF shielded part is 61813-2Z/C3.

## 32 Carrier-2 rear

3D print for the fit check, then CNC from annealed 20MnCr5, the same heat. Quantity 1. Mass 232.3 g. Hub Ø65 mm × 10 mm, three posts, envelope about Ø67 mm × 21 mm.

The hub is the rear inner-ring seat, from Z 68.9 to Z 78.9, Ø65 mm j5. The posts run forward to Z 89.9 on a Ø54 mm circle and are tapped M4. The post faces are the shoulder for the rear inner ring. Three Ø8 mm R7 pin holes on a Ø45 mm circle are 6 mm deep from the front and stop on a 1.0 mm shoulder. A Ø3 mm hole through that shoulder vents the press and lets a punch drive the pin out. The rear lightening groove is Ø42–Ø59 mm and 3 mm deep, and it does not break the pin shoulder. Do not carburize this part.

## 33 Bearing cartridge and ring-2

3D print for the fit check, then CNC from annealed 20MnCr5, the same heat. Quantity 1. Mass 351.0 g. Flange Ø100 mm × 7.5 mm, spigot Ø89 mm, overall length 31.5 mm. Ring-2 is 72 teeth, module 1.0, cut in the same piece.

It is the front structure, from Z 68.4 to Z 99.9. The spigot is Ø89 mm h6 in the housing's G7 bore. The Ø85 mm bore holds both 61813 outer rings. Machine that bore after measuring the bearings: 3–10 µm larger than the measured OD, and the rear ring must still slide under the spring. Ring-2 teeth run from Z 79.2 to Z 89.6. Wire-EDM the teeth while the steel is soft. Tap the eight M2.5 cover holes first and mask them. Carburize the teeth only, case 0.15–0.20 mm, 58–62 HRC, and mask the Ø89 spigot and the Ø85 bore. Do not grind the teeth. Finish Ø89 and Ø85 after heat treatment. Eight M3 counterbored holes on a Ø93 mm circle bolt the flange to the housing. Inspection of ring-2: dimension between Ø1.5 mm pins, Mi = 70.499 mm, plus 0.015 / minus 0.

## 34 Cartridge screws

Purchase. Quantity 8. Mass 1.01 g each. M3 × 10 socket head, ISO 4762, grade 12.9.

They clamp the cartridge flange to the housing. Heads at the front of the flange. Torque 1.2 N·m with Loctite 243. Slip safety factor at the proof load is 3.4. Thread engagement in the housing is 6 mm, strip safety factor 3.3 in 6082-T6.

## 35 Cartridge dowels

Purchase. Quantity 2. Mass 0.78 g each. ISO 8734 Ø4 × 8 mm, hardened, m6.

They stop the cartridge rotating in the housing, on a Ø94 mm circle, from Z 88.4 to Z 96.4. They are a backup. The eight screws carry the torque. At the proof load each pin sees about 420 N.

## 36 Planet-2

3D print for the fit check, then CNC from 20MnCr5, carburized. Quantity 3. Mass 35.2 g each. Size Ø29 mm × 10 mm face, bore Ø12 mm. 27 teeth, module 1.0.

They orbit at radius 22.5 mm, teeth from Z 79.4 to Z 89.4, between sun-2 and ring-2. Same spacing as planet-1. Carburize to 0.15–0.20 mm case, 58–62 HRC, and grind the bore. Bore Ø12 N6. Span over 4 teeth, W4 = 10.687 mm, minus 0.015 / plus 0. This is the high-load mesh: at 30 N·m the sun contact stress is about 1,350 MPa.

## 37 Planet-2 needle bearings

Purchase. Quantity 3, plus the same 2 spares as part 25. Same HK0810, 8 × 12 × 10 mm, catalogue mass about 3.1 g.

One sits in each planet-2, from Z 79.4 to Z 89.4. Same press and same capacity as part 25.

Buy: [INA HK0810](https://www.noksbearings.com/brand/ina/hk0810/needle-roller-bearings-ina), [SKF HK 0810 data sheet](https://documents.klium.nl/9ad58f0c-40d4-47fb-ab4e-48a1f5b26eee/en/technical-data-sheet-skf-hk-0810-hk-0810-en.pdf).

## 38 Planet pins 2

Purchase. Quantity 3. Mass 9.0 g each. Size Ø8 mm × 23 mm, 52100, same specification as part 26.

Each pin runs from Z 72.9 to Z 95.9. The rear 6 mm is pressed into carrier-2 rear and stops on the 1.0 mm shoulder. The front 6 mm is pressed into a blind R7 hole in carrier-2 front, with 0.3 mm of empty hole beyond the pin so the two carrier halves clamp on their faces. Grind a 0.2 mm vent flat on the front 6 mm only, clear of the needle track, so the blind hole can vent. Through-harden 58–64 HRC, grind h6, Ra at or below 0.2 µm.

## 39 Planet-2 rear washers

Purchase. Quantity 3. Mass 0.24 g each. Same Ø14 / Ø8.2 × 0.3 mm ring as part 27.

They sit behind each planet-2, from Z 79.1 to Z 79.4.

## 40 Planet-2 front washers

Purchase. Quantity 3. Mass 0.24 g each. Same ring.

They sit in front of each planet-2, from Z 89.4 to Z 89.7.

## 41 Front output bearing

Purchase. Quantity 1, plus 1 spare. Catalogue mass about 131 g. 61813-2RS1/C3, 65 × 85 × 10 mm, contact rubber seals.

It is the front output bearing, from Z 89.9 to Z 99.9, and the seals are the gearbox seal. The outer ring is located in the cartridge. The inner ring is on the Ø65 mm j5 seat of carrier-2 front. Order C3, for the same clearance reason as part 31. Dynamic capacity 11.9 kN. Use the lower static capacity, 9.65 kN. At 30 N·m and 72 rpm the calculated life of this bearing is about 209,000 hours.

Buy: [SKF 61813-2RS1](https://www.skf.com/uk/products/rolling-bearings/ball-bearings/deep-groove-ball-bearings/productid-61813-2RS1). Order the C3 clearance variant, 61813-2RS1/C3.

## 42 Carrier-2 front

3D print for the fit check, then CNC from annealed 20MnCr5, the same heat. Quantity 1. Mass 313.9 g. Flange Ø78 mm, hub Ø65 mm, overall length 14 mm. Do not carburize this part.

This is the arm flange. The hub is from Z 89.9 to Z 100.4 and is the front inner-ring seat, Ø65 mm j5. The flange runs out to Z 103.9. Six M5 holes on a Ø52 mm circle, tapped 8 mm deep in this steel, take the arm screws. A Ø40 mm H7 pilot, 2 mm deep, centres the arm. Runout within 0.02 mm TIR, face flatness within 0.03 mm. Three Ø8 mm R7 holes, blind 6.3 mm deep, take planet pins 2. Three M4 counterbores on a Ø54 mm circle clamp this half to the rear half. A Ø3 mm radial hole in the rim at Z 102.15 holds the homing magnet.

## 43 Carrier-2 screws

Purchase. Quantity 3. Mass 2.65 g each. M4 × 16 socket head, ISO 4762, grade 12.9.

They clamp the two carrier-2 halves. Heads in the front flange. Torque 4.0 N·m exactly, with a torque driver and Loctite 243. The slip safety factor is 1.4, which is the lowest joint in the actuator, so this torque is not a suggestion.

## 44 Homing magnet

Purchase. Quantity 1, plus 2 spares. Mass 0.10 g. Size Ø3 × 2 mm NdFeB N52, axially magnetised.

It is glued in the rim of the output flange at radius 36.8 mm, Z 102.15, pole facing outward. At the 1.2–2.0 mm gaps used here the field is 97–201 mT, far above the hall sensor's 6.8 mT maximum operate point. Glue with structural epoxy.

## 45 Front cover

3D print for the fit check, then CNC from 6082-T6. Quantity 1. Mass 22.3 g. Size Ø100 mm outside, Ø80 mm inside, 3 mm thick.

It is the bearing retainer, from Z 99.9 to Z 102.9. The lip touches only the front outer ring. Eight M2.5 countersunk screws on a Ø93.2 mm circle bolt it to the cartridge. A pocket at 270° holds the hall sensor, with a wire slot to the outside edge. No anodize.

## 46 Hall sensor

Purchase. Quantity 1, plus 2 spares. The model assigns no mass. TI DRV5033FAQDBZR, SOT-23, omnipolar, open drain. Bandwidth 20–30 kHz. Operate point ±3.5 mT typical, ±6.8 mT maximum. Supply 2.5–38 V.

It sits in the cover pocket at 270°, from Z 101.0 to Z 102.6, facing the homing magnet across about 1.2–2.0 mm. A 10 kΩ pull-up to 3.3 V is required. The older DRV5032FB samples at 5 Hz and would miss the magnet, which is in view for about 14 ms, so do not fit that part. DRV5033AJ is an acceptable, less sensitive, alternate.

## 47 Cover screws

Purchase. Quantity 8. Mass 0.29 g each. M2.5 × 6 countersunk, ISO 7046 or ISO 14581.

They clamp the cover to the cartridge. The cartridge threads are M2.5 and must be tapped and masked before the teeth are carburized. Torque 0.8 N·m with Loctite 222, so they can be removed without damaging the small threads.

## 48 Motor shims

Purchase, or laser-cut from shim stock. Quantity: a set of 0.25 mm and 0.5 mm shims, enough to stack 0.5–1.5 mm. The nominal pack is 2 × 0.5 mm. Size Ø50 / Ø21.1 mm, four Ø4.5 mm holes on a Ø40 mm circle at 45°. Stainless or spring-steel shim stock. The bore is Ø21.1 so it clears the hex corners.

They sit between the rear plate (Z 18.4) and the motor mounting face (Z 19.4 at the 1.0 mm pack), and set where the motor and sun-1 sit axially without moving the gearbox. To choose the pack: screw the motor to the plate on the nominal 1.0 mm pack and measure from the plate front face to the rotor hub face. The pack is 1.0 + (28.5 − reading) mm, rounded to 0.25 mm. Across 0.5–1.5 mm every axial gap (rotor to partition, sun-1 to both carrier-1 plates) stays between 1.0 and 2.0 mm. The air from the chip to the cover face stays between 0.5 and 1.5 mm (calc §9).
