shourya-khatiyan/Prime-TheHumanoid/body parts/shoulder/cad/milling/drawing/18_sun_1.pdf

VAYN shoulder · milling drawing · 18 Sun-1 | Pack A · Rev 1.4 · redrawn 31 Oct 2026

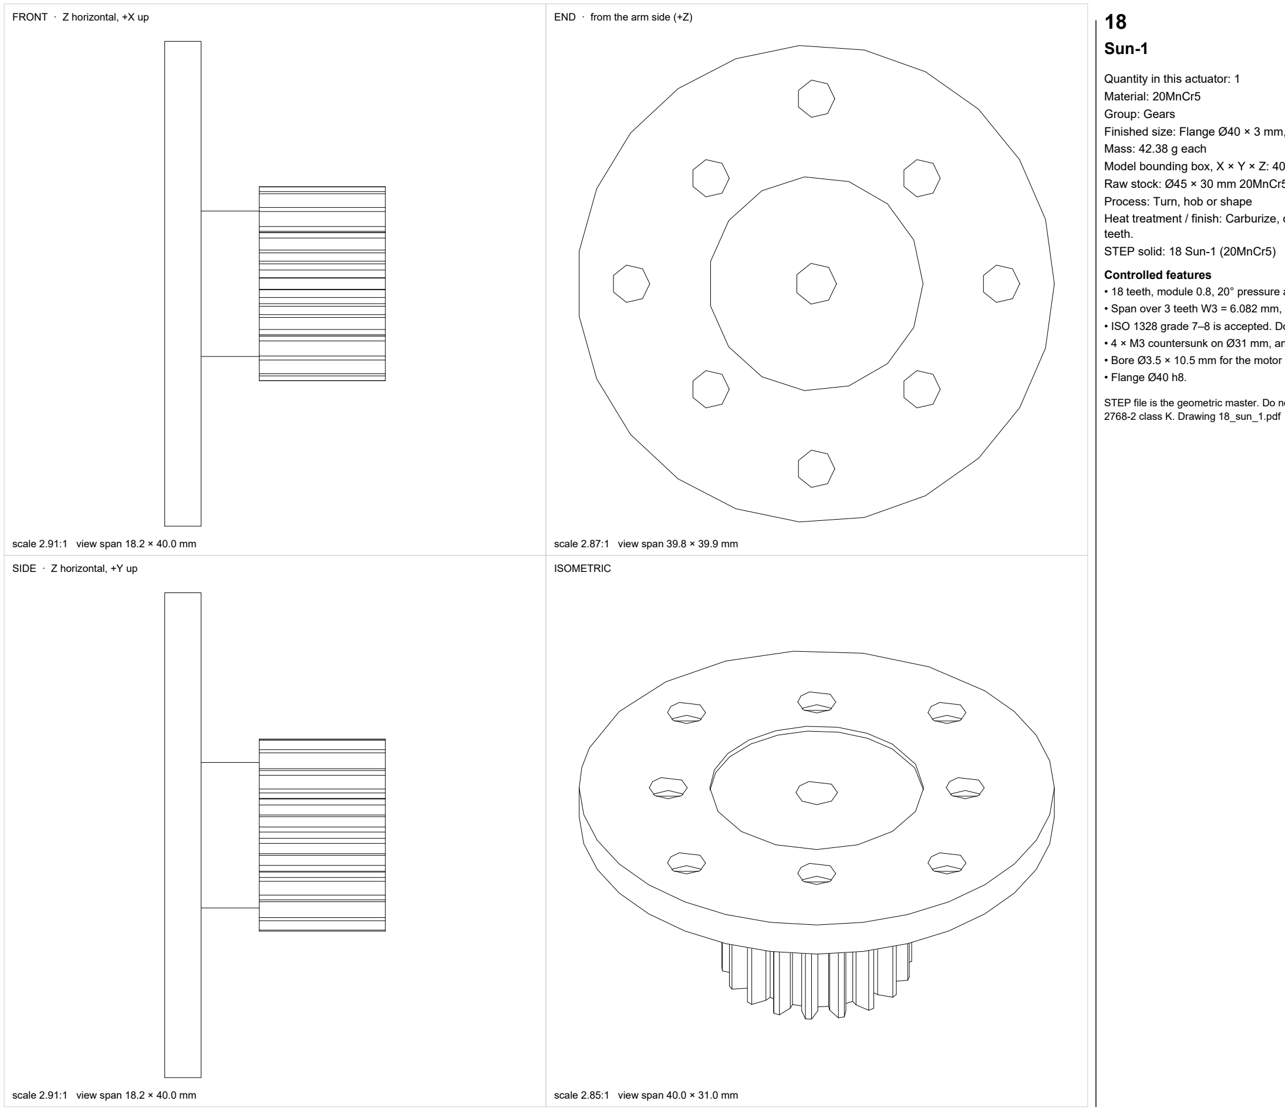
[picture p2: figure]
FRONT · Z horizontal, +X up; scale 2.91:1 view span 18.2 × 40.0 mm; END · from the arm side (+Z); scale 2.87:1 view span 39.8 × 39.9 mm; SIDE · Z horizontal, +Y up; ISOMETRIC; scale 2.85:1 view span 40.0 × 31.0 mm; Sun-1; Quantity in this actuator: 1; Material: 20MnCr5; Group: Gears; Mass: 42.38 g each; Process: Turn, hob or shape; teeth.; STEP solid: 18 Sun-1 (20MnCr5); Controlled features; • Flange Ø40 h8.; 2768-2 class K. Drawing 18_sun_1.pdf

Finished size: Flange Ø40 × 3 mm, teeth Ø16 × 10.4 mm, overall 18.2 mm

Model bounding box, X × Y × Z: 40.0 × 40.0 × 18.2 mm
Raw stock: Ø45 × 30 mm 20MnCr5, annealed, same heat as the other steel

Heat treatment / finish: Carburize, case 0.12–0.18 mm, 58–62 HRC, core 30–40 HRC. Do not grind the

- 18 teeth, module 0.8, 20° pressure angle, profile shift 0.
- Span over 3 teeth W3 = 6.082 mm, minus 0.015 / plus 0.
- ISO 1328 grade 7–8 is accepted. Do not grind the teeth. Backlash 0.05 ± 0.02 mm per mesh.
- 4 × M3 countersunk on Ø31 mm, and 4 × M3 countersunk on Ø25 mm at 45°. Use the pattern the rotor has.
- Bore Ø3.5 × 10.5 mm for the motor stub. Hub relief Ø18 × 0.5 mm.

STEP file is the geometric master. Do not scale this sheet. Sizes not listed here follow ISO 2768-1 class m and ISO
