shourya-khatiyan/Prime-TheHumanoid/body parts/arm/cad/arm-1.png

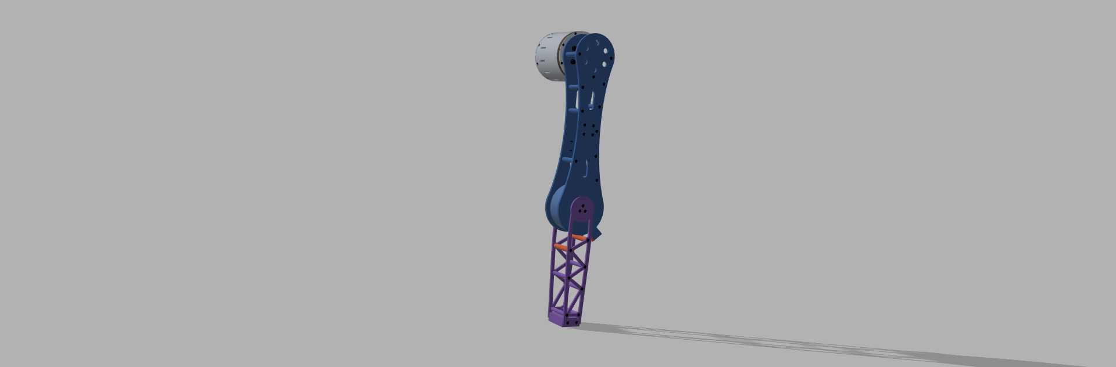
body parts/arm/cad/arm-1.png
