shourya-khatiyan/Prime-TheHumanoid/body parts/arm/cad/arm_preview.png

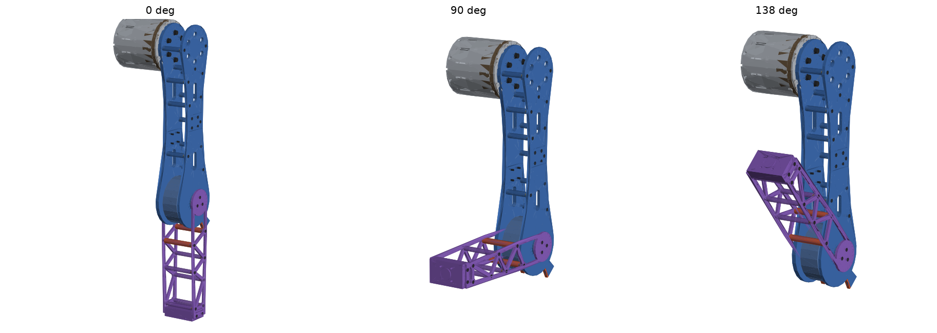
body parts/arm/cad/arm_preview.png
