shourya-khatiyan/Prime-TheHumanoid/body parts/claw/cad/claw_preview.png

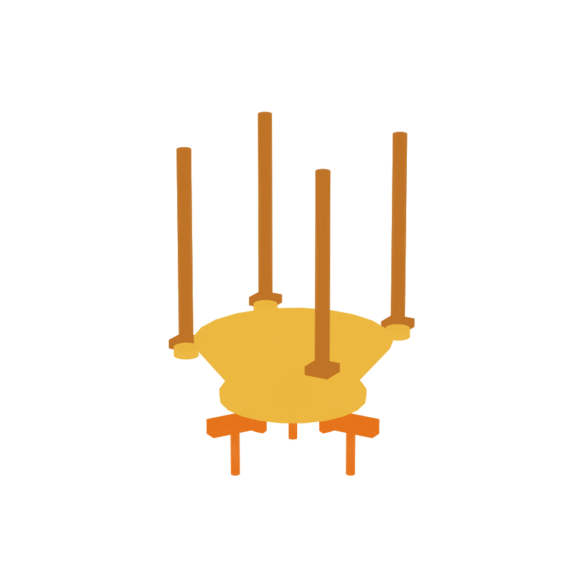
body parts/claw/cad/claw_preview.png
