shourya-khatiyan/Prime-TheHumanoid/body parts/hand/cad/hand_preview.png

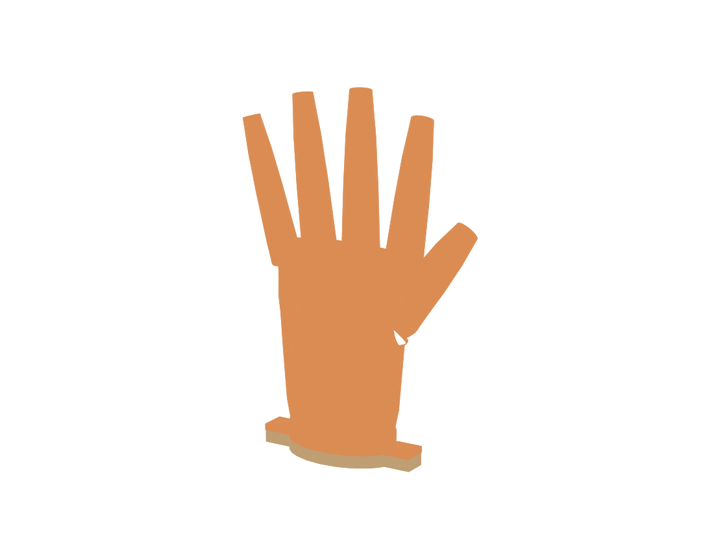
body parts/hand/cad/hand_preview.png
