shourya-khatiyan/Prime-TheHumanoid/body parts/shoulder v6/additionals/sleeve_section.png

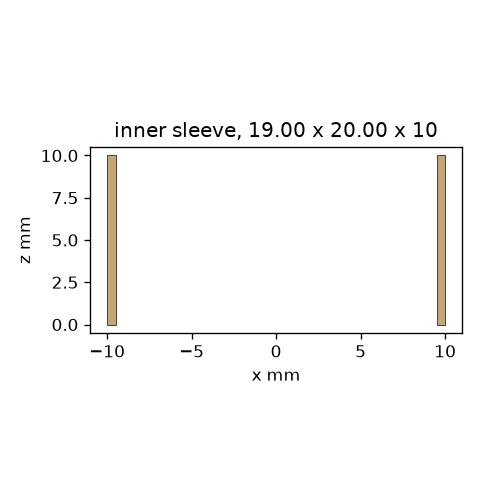
body parts/shoulder v6/additionals/sleeve_section.png
