shourya-khatiyan/Prime-TheHumanoid/body parts/shoulder v6/cad/section.png

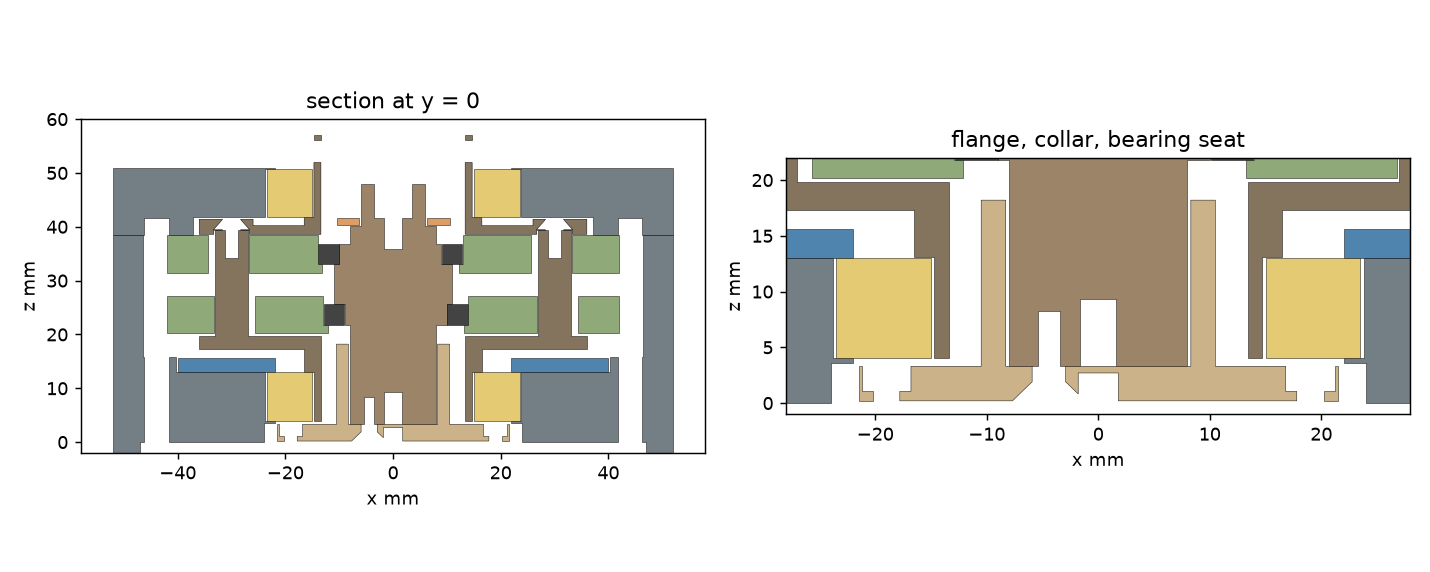
body parts/shoulder v6/cad/section.png
