shourya-khatiyan/Prime-TheHumanoid/body parts/stand-lite/cad/stand_lite_preview.png

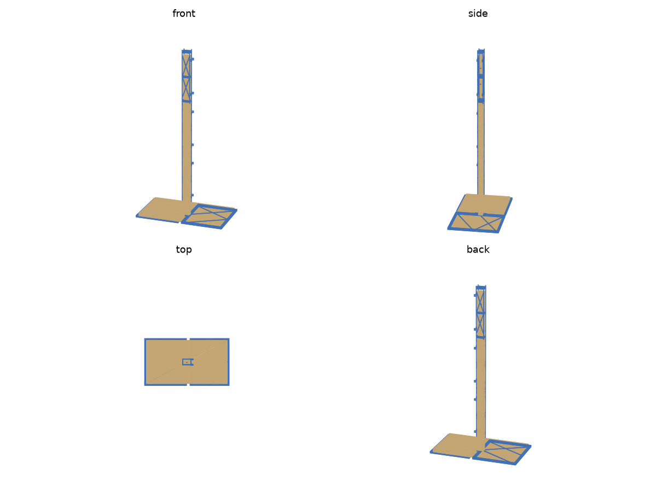
body parts/stand-lite/cad/stand_lite_preview.png
