shourya-khatiyan/Prime-TheHumanoid/body parts/stand/cad/stand_preview.png

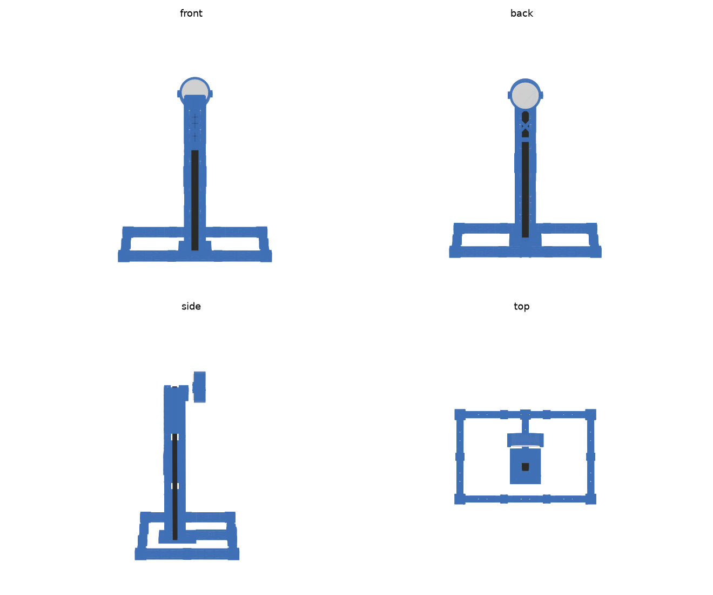
body parts/stand/cad/stand_preview.png
