shourya-khatiyan/Prime-TheHumanoid/body parts/arm/cad/arm.step

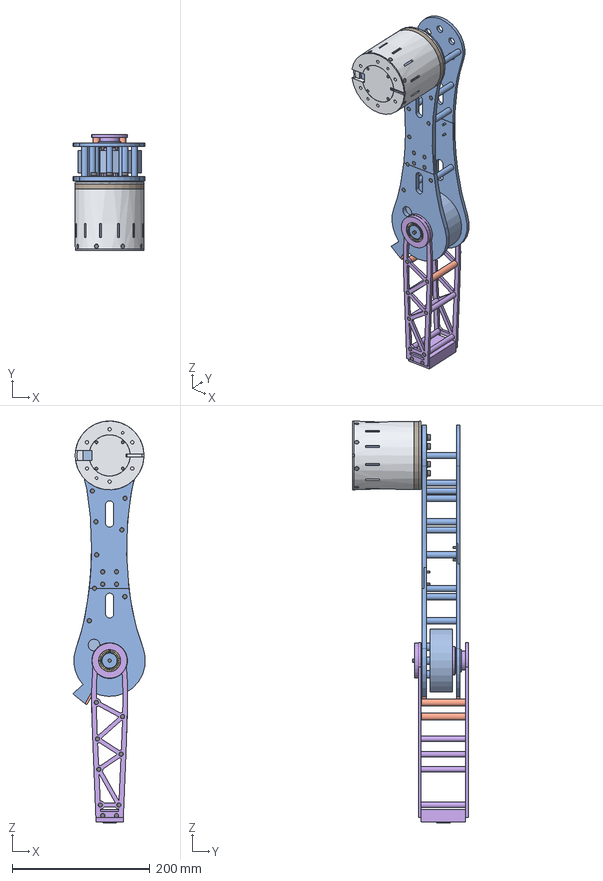
[picture p12: CAD file, 2026-10-29]
body parts/arm/cad/arm.step
105.2 x 168.2 x 583.8 mm
201 Upper inner plate, elbow piece (PETG)
202 Upper inner plate, shoulder piece (PETG)
203 Upper outer plate, elbow piece (PETG)
204 Upper outer plate, shoulder piece (PETG)
218.1 Rubber pad 3 mm, heel, inner plate
218.2 Rubber pad 3 mm, heel, outer plate
205.1 Upper spacer sleeve D9 (PETG)
230.1 Insert M3x5.7 upper spacer, inner end
231.1 Insert M3x5.7 upper spacer, outer end
232.1 Screw M3x12 ISO 10642 inner plate->spacer
233.1 Screw M3x10 ISO 10642 outer plate->spacer
205.2 Upper spacer sleeve D9 (PETG)
230.2 Insert M3x5.7 upper spacer, inner end
231.2 Insert M3x5.7 upper spacer, outer end
232.2 Screw M3x12 ISO 10642 inner plate->spacer
233.2 Screw M3x10 ISO 10642 outer plate->spacer
205.3 Upper spacer sleeve D9 (PETG)
230.3 Insert M3x5.7 upper spacer, inner end
231.3 Insert M3x5.7 upper spacer, outer end
232.3 Screw M3x12 ISO 10642 inner plate->spacer
233.3 Screw M3x10 ISO 10642 outer plate->spacer
205.4 Upper spacer sleeve D9 (PETG)
230.4 Insert M3x5.7 upper spacer, inner end
231.4 Insert M3x5.7 upper spacer, outer end
232.4 Screw M3x12 ISO 10642 inner plate->spacer
233.4 Screw M3x10 ISO 10642 outer plate->spacer
205.5 Upper spacer sleeve D9 (PETG)
230.5 Insert M3x5.7 upper spacer, inner end
231.5 Insert M3x5.7 upper spacer, outer end
232.5 Screw M3x12 ISO 10642 inner plate->spacer
233.5 Screw M3x10 ISO 10642 outer plate->spacer
205.6 Upper spacer sleeve D9 (PETG)
230.6 Insert M3x5.7 upper spacer, inner end
231.6 Insert M3x5.7 upper spacer, outer end
232.6 Screw M3x12 ISO 10642 inner plate->spacer
233.6 Screw M3x10 ISO 10642 outer plate->spacer
205.7 Upper spacer sleeve D9 (PETG)
230.7 Insert M3x5.7 upper spacer, inner end
231.7 Insert M3x5.7 upper spacer, outer end
232.7 Screw M3x12 ISO 10642 inner plate->spacer
233.7 Screw M3x10 ISO 10642 outer plate->spacer
205.8 Upper spacer sleeve D9 (PETG)
230.8 Insert M3x5.7 upper spacer, inner end
231.8 Insert M3x5.7 upper spacer, outer end
232.8 Screw M3x12 ISO 10642 inner plate->spacer
233.8 Screw M3x10 ISO 10642 outer plate->spacer
205.9 Upper spacer sleeve D9 (PETG)
230.9 Insert M3x5.7 upper spacer, inner end
231.9 Insert M3x5.7 upper spacer, outer end
232.9 Screw M3x12 ISO 10642 inner plate->spacer
233.9 Screw M3x10 ISO 10642 outer plate->spacer
205.10 Upper spacer sleeve D9 (PETG)
230.10 Insert M3x5.7 upper spacer, inner end
231.10 Insert M3x5.7 upper spacer, outer end
232.10 Screw M3x12 ISO 10642 inner plate->spacer
233.10 Screw M3x10 ISO 10642 outer plate->spacer
205.11 Upper spacer sleeve D9 (PETG)
230.11 Insert M3x5.7 upper spacer, inner end
231.11 Insert M3x5.7 upper spacer, outer end
232.11 Screw M3x12 ISO 10642 inner plate->spacer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
