shourya-khatiyan/Prime-TheHumanoid/body parts/claw/cad/claw_print.3mf

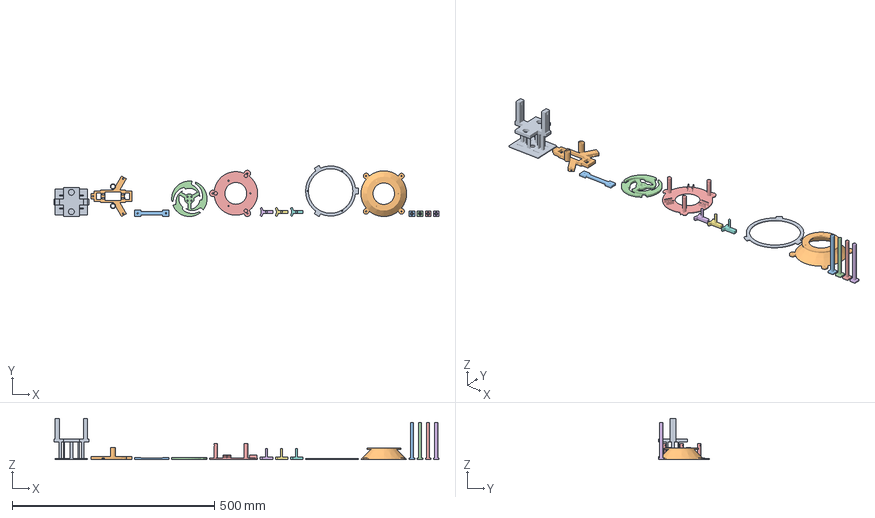
[picture p13: CAD file, 2026-11-03]
body parts/claw/cad/claw_print.3mf
952.7 x 126.5 x 102.6 mm
01_mast
02_carriage
03_stop
04_cam
05_housing
06_jaw_1
06_jaw_2
06_jaw_3
07_retainer
08_guide
09_foot_1
09_foot_2
09_foot_3
09_foot_4
