shourya-khatiyan/Prime-TheHumanoid/body parts/claw/cad/stl/06_jaw_1.stl

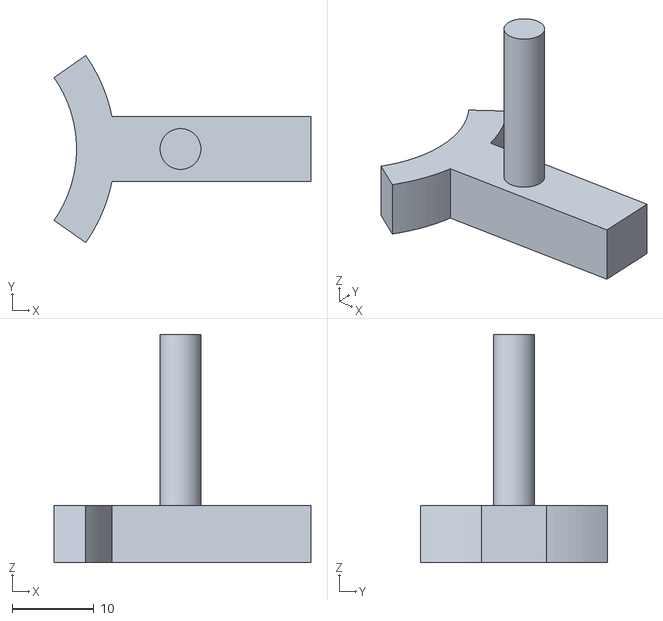
[picture p14: CAD file, 2026-11-03]
body parts/claw/cad/stl/06_jaw_1.stl
31.5 x 22.9 x 28.0
