shourya-khatiyan/Prime-TheHumanoid/body parts/hand/cad/hand.step

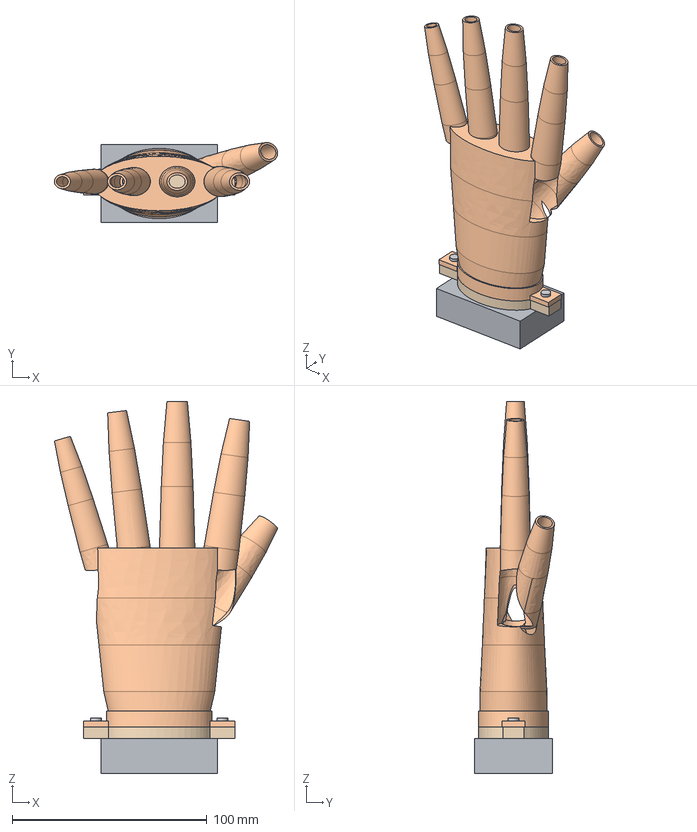
[picture p15: CAD file, 2026-11-04]
body parts/hand/cad/hand.step
114.6 x 41.1 x 191.0 mm
hand_shell
wrist_plate
wrist_block_existing
spigot_existing
m3x12_csk_1
m3x12_csk_2
m3x12_csk_3
m3x12_csk_4
m3x8_button_1
m3x8_button_2
m3_nut_1
m3_nut_2
