shourya-khatiyan/Prime-TheHumanoid/body parts/hand/cad/stl/hand_shell.stl

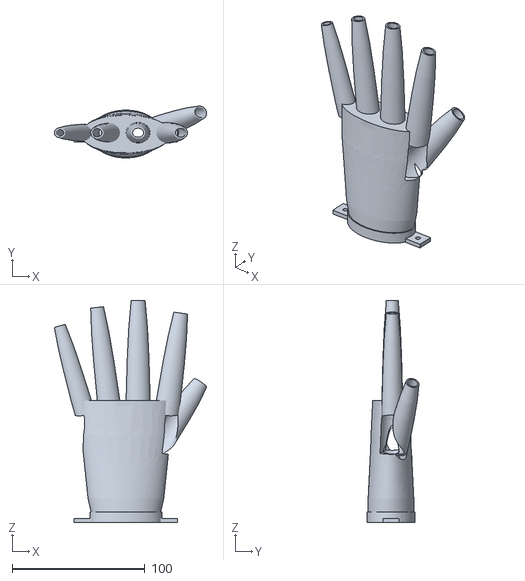
[picture p16: CAD file, 2026-11-04]
body parts/hand/cad/stl/hand_shell.stl
114.6 x 39.1 x 167.0
