shourya-khatiyan/Prime-TheHumanoid/body parts/shoulder v6/additionals/inner_sleeve_B.stl

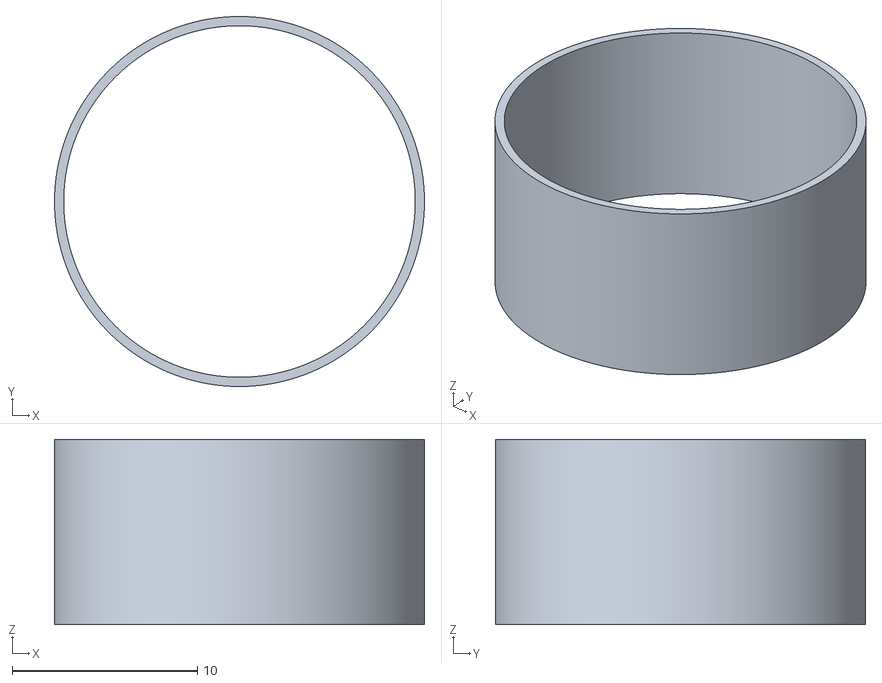
[picture p17: CAD file, 2026-11-06]
body parts/shoulder v6/additionals/inner_sleeve_B.stl
20.0 x 20.0 x 10.0
