shourya-khatiyan/Prime-TheHumanoid/body parts/shoulder v6/cad/actuator.step

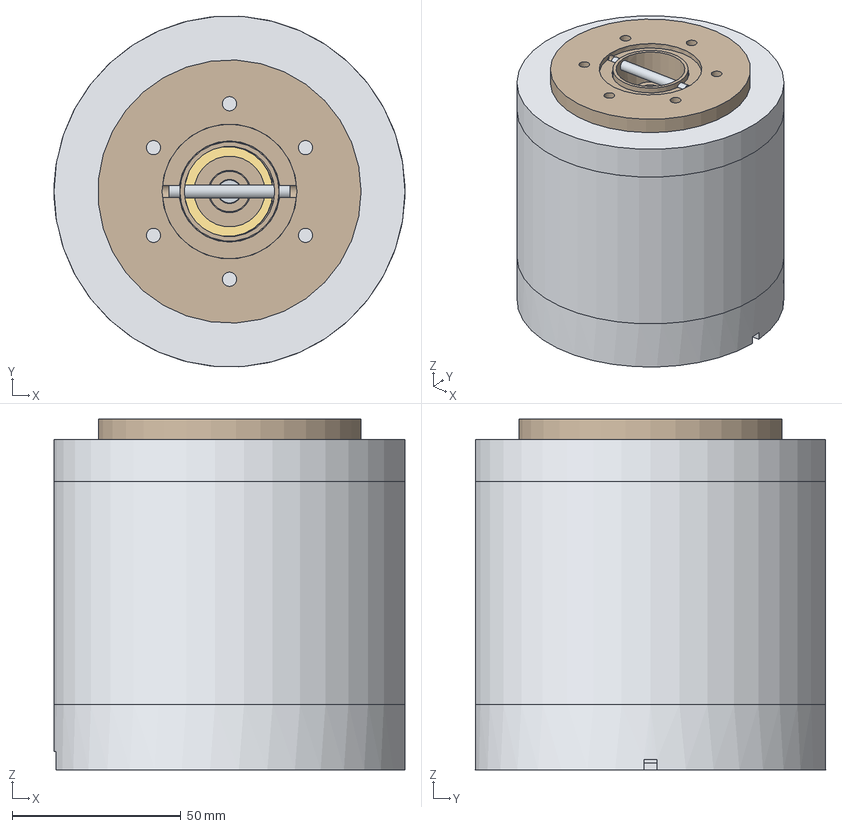
[picture p18: CAD file, 2026-11-06]
body parts/shoulder v6/cad/actuator.step
104.0 x 103.9 x 103.9 mm
02.1 Ring pin D4
02.2 Ring pin D4
02.3 Ring pin D4
02.4 Ring pin D4
02.5 Ring pin D4
02.6 Ring pin D4
02.7 Ring pin D4
02.8 Ring pin D4
02.9 Ring pin D4
02.10 Ring pin D4
02.11 Ring pin D4
02.12 Ring pin D4
02.13 Ring pin D4
02.14 Ring pin D4
02.15 Ring pin D4
02.16 Ring pin D4
02.17 Ring pin D4
02.18 Ring pin D4
02.19 Ring pin D4
02.20 Ring pin D4
02.21 Ring pin D4
02.22 Ring pin D4
02.23 Ring pin D4
02.24 Ring pin D4
02.25 Ring pin D4
02.26 Ring pin D4
02.27 Ring pin D4
02.28 Ring pin D4
02.29 Ring pin D4
02.30 Ring pin D4
02.31 Ring pin D4
02.32 Ring pin D4
02.33 Ring pin D4
02.34 Ring pin D4
02.35 Ring pin D4
02.36 Ring pin D4
02.37 Ring pin D4
02.38 Ring pin D4
02.39 Ring pin D4
02.40 Ring pin D4
02.41 Ring pin D4
02.42 Ring pin D4
02.43 Ring pin D4
02.44 Ring pin D4
02.45 Ring pin D4
02.46 Ring pin D4
01 Housing 6082-T6
03 Cycloid disc A
04 Cycloid disc B
05 Disc bearing 6704 A
06 Disc bearing 6704 B
07 Crank shaft
21 Front washer
28 Screw M4 washer
22.1 Screw M2 crank to rotor
22.2 Screw M2 crank to rotor
22.3 Screw M2 crank to rotor
22.4 Screw M2 crank to rotor
29.1 Screw M3 flange to shaft
29.2 Screw M3 flange to shaft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
