shourya-khatiyan/Prime-TheHumanoid/body parts/shoulder v6/cad/actuator_print/02.41_Ring_pin_D4.stl

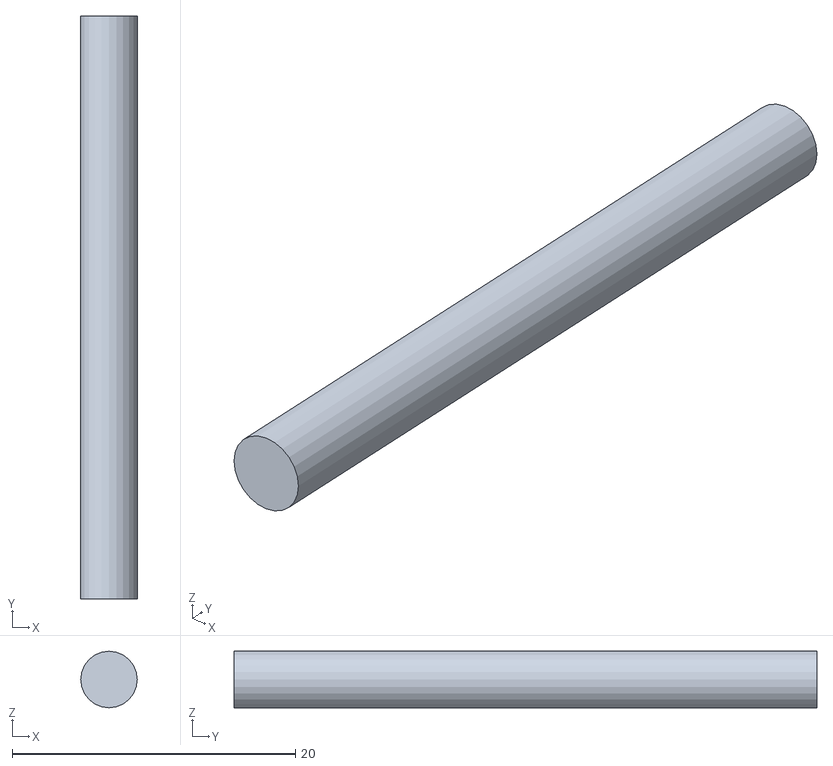
[picture p19: CAD file, 2026-11-06]
body parts/shoulder v6/cad/actuator_print/02.41_Ring_pin_D4.stl
4.00 x 41.2 x 4.00
