shourya-khatiyan/Prime-TheHumanoid/body parts/stand-lite/cad/stand_lite.step

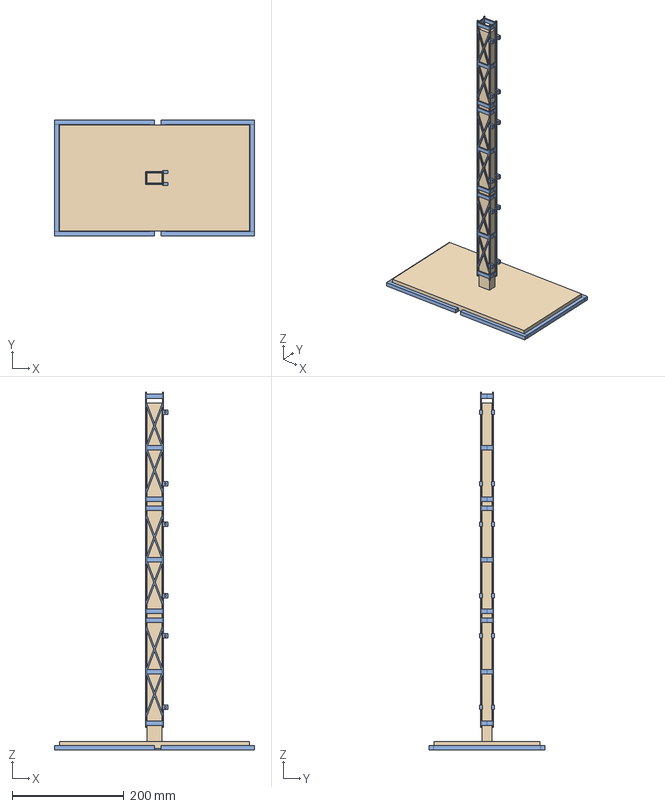
[picture p20: CAD file, 2026-11-03]
body parts/stand-lite/cad/stand_lite.step
357.6 x 207.6 x 640.0 mm
base_a
base_b
plate
stick
stick_front_1
stick_back_1
stick_front_2
stick_back_2
stick_front_3
stick_back_3
