shourya-khatiyan/Prime-TheHumanoid/body parts/stand-lite/cad/stl/stick_front_2.stl

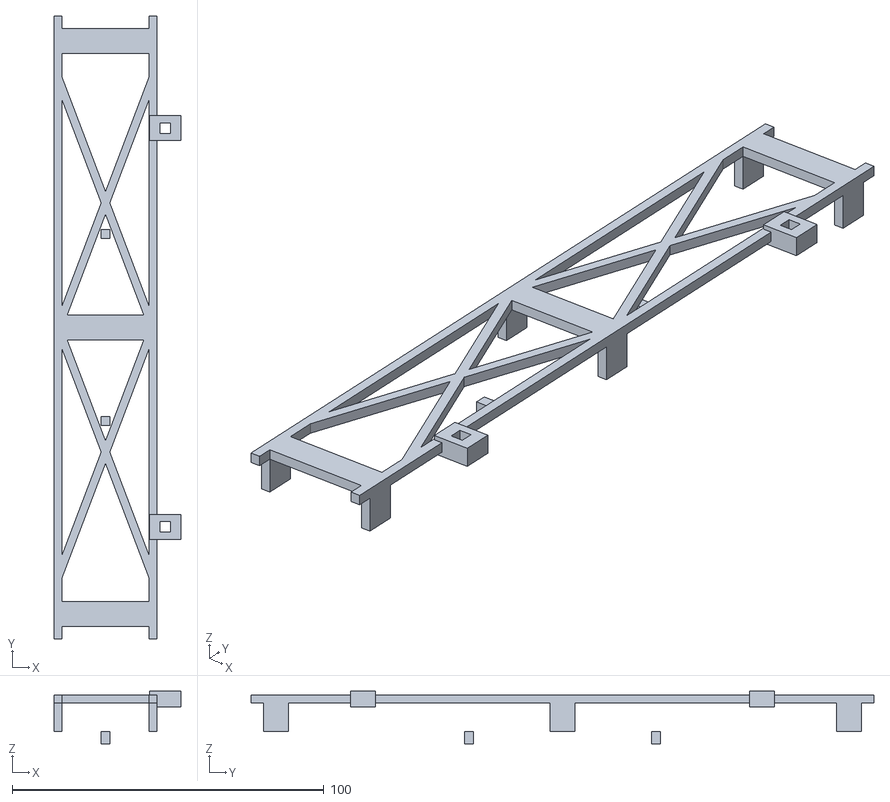
[picture p21: CAD file, 2026-11-03]
body parts/stand-lite/cad/stl/stick_front_2.stl
40.7 x 200.0 x 16.9
