shourya-khatiyan/Prime-TheHumanoid/body parts/stand/cad/stand.step

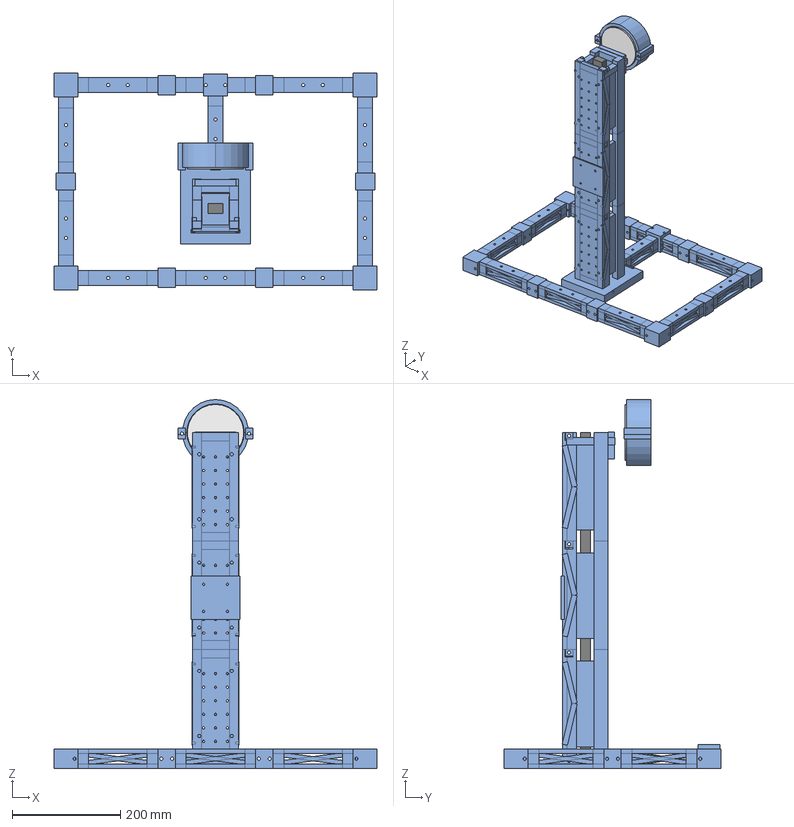
[picture p22: CAD file, 2026-11-03]
body parts/stand/cad/stand.step
596.0 x 400.0 x 681.0 mm
corner-0
corner-1
corner-2
corner-3
beam_x-4
coupler-5
beam_x-6
coupler-7
beam_x-8
beam_x-9
coupler-10
beam_x-11
coupler-12
beam_x-13
beam_y-14
coupler-15
beam_y-16
beam_y-17
coupler-18
beam_y-19
foot-20
tower_back-21
tower_front-22
tower_back-23
tower_front-24
tower_back-25
tower_front-26
beam_center-27
saddle-28
clamp_lower-29
clamp_upper-30
odrive_plate-31
stick
housing
