shourya-khatiyan/Prime-TheHumanoid/body parts/stand/cad/stl/saddle.stl

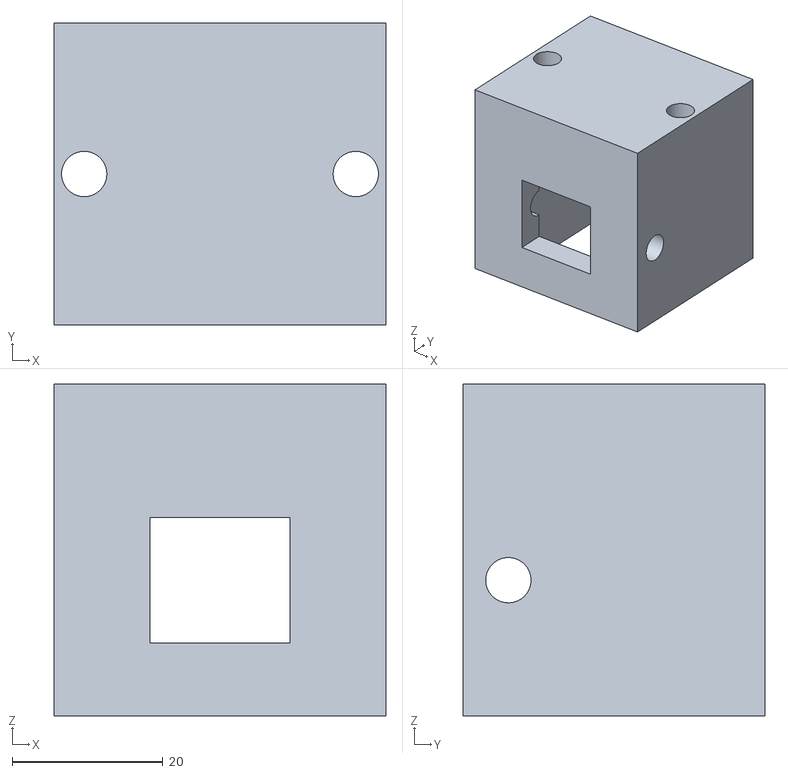
[picture p23: CAD file, 2026-11-03]
body parts/stand/cad/stl/saddle.stl
44.0 x 40.0 x 44.0
