shourya-khatiyan/Prime-TheHumanoid/body parts/claw/cad/claw.step

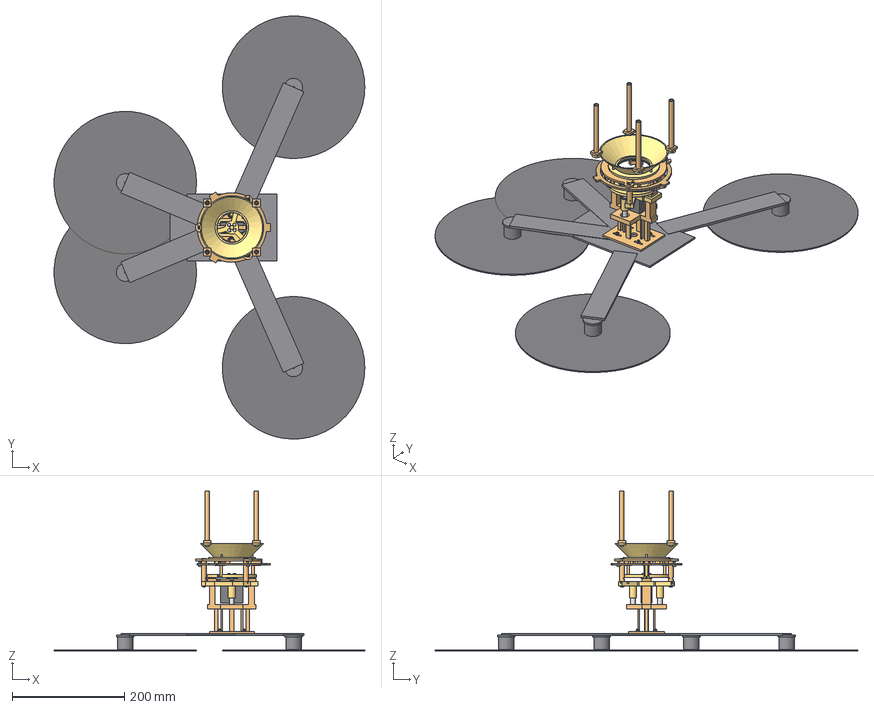
[picture p24: CAD file, 2026-11-03]
body parts/claw/cad/claw.step
553.8 x 753.9 x 285.0 mm
mast
carriage
stop
cam
housing
retainer
guide
servo
horn
jaw_1
jaw_2
jaw_3
foot_1
foot_2
foot_3
foot_4
spring_1
spring_2
screw_drone_1
nut_drone_1
screw_drone_2
nut_drone_2
screw_drone_3
nut_drone_3
screw_drone_4
nut_drone_4
screw_stop_1
nut_stop_1
screw_stop_2
nut_stop_2
screw_servo_1
nut_servo_1
screw_servo_2
nut_servo_2
screw_servo_3
nut_servo_3
screw_servo_4
nut_servo_4
screw_post_1
nut_post_1
screw_post_2
nut_post_2
screw_post_3
nut_post_3
screw_cam_1
screw_cam_2
screw_cam_3
screw_cam_4
screw_retainer_1
nut_retainer_1
screw_retainer_2
nut_retainer_2
screw_retainer_3
nut_retainer_3
screw_guide_1
nut_guide_1
screw_guide_2
nut_guide_2
screw_guide_3
nut_guide_3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
