shourya-khatiyan/Prime-TheHumanoid/body parts/claw/cad/stl/01_mast.stl

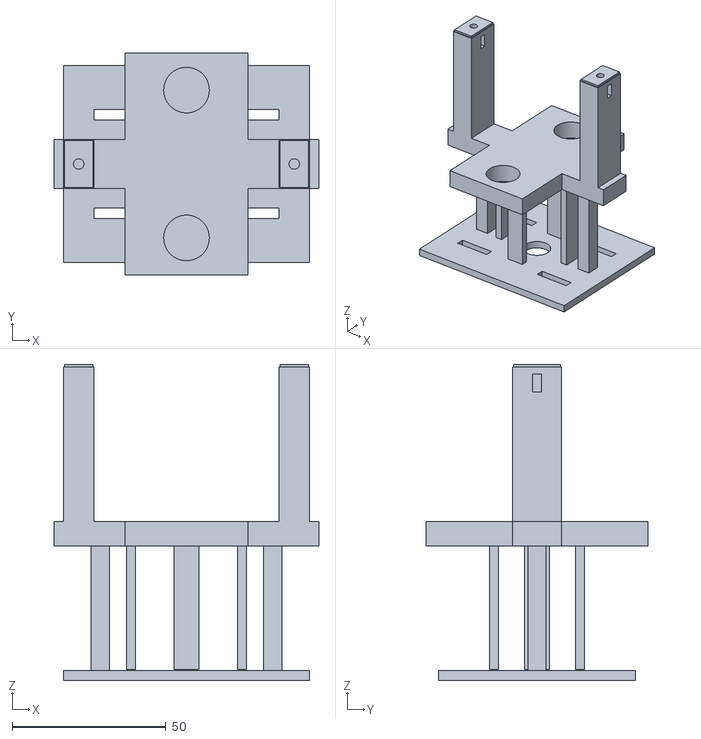
[picture p25: CAD file, 2026-11-03]
body parts/claw/cad/stl/01_mast.stl
86.0 x 72.0 x 102.6
