shourya-khatiyan/Prime-TheHumanoid/body parts/hand/cad/stl/wrist_plate.stl

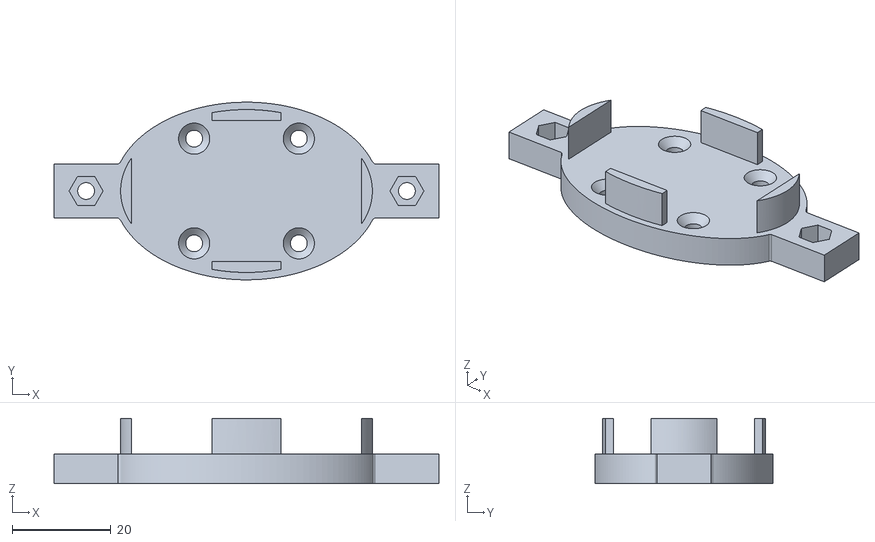
[picture p26: CAD file, 2026-11-04]
body parts/hand/cad/stl/wrist_plate.stl
78.0 x 36.0 x 13.2
