shourya-khatiyan/Prime-TheHumanoid/body parts/shoulder v6/cad/actuator_plate2.3mf

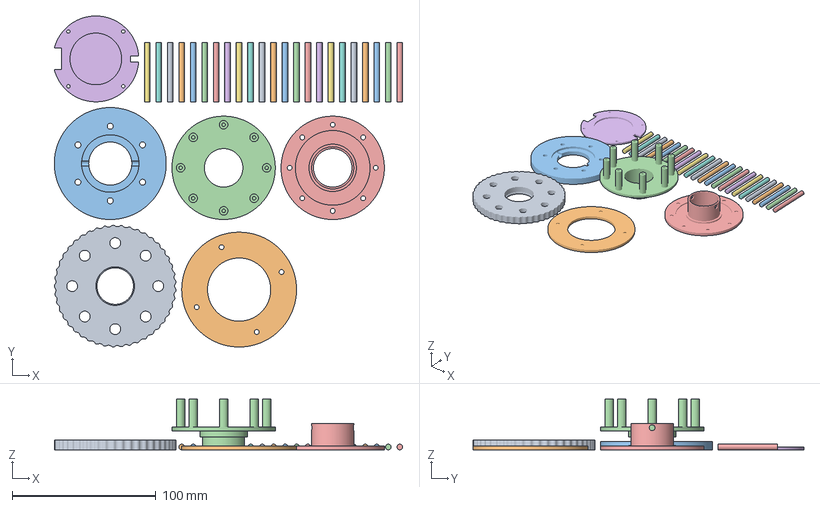
[picture p27: CAD file, 2026-11-06]
body parts/shoulder v6/cad/actuator_plate2.3mf
242.8 x 230.6 x 35.4 mm
03 Cycloid disc A
27 Bearing retainer
25 Arm flange
08 Rear carrier
23 Front plate and hub
16 Encoder lid
02.1 Ring pin D4
02.2 Ring pin D4
02.3 Ring pin D4
02.4 Ring pin D4
02.5 Ring pin D4
02.6 Ring pin D4
02.7 Ring pin D4
02.8 Ring pin D4
02.9 Ring pin D4
02.10 Ring pin D4
02.11 Ring pin D4
02.13 Ring pin D4
02.14 Ring pin D4
02.15 Ring pin D4
02.16 Ring pin D4
02.17 Ring pin D4
02.19 Ring pin D4
02.20 Ring pin D4
02.21 Ring pin D4
02.22 Ring pin D4
02.23 Ring pin D4
02.24 Ring pin D4
02.25 Ring pin D4
