shourya-khatiyan/Prime-TheHumanoid/body parts/shoulder v6/cad/actuator_print/23_Front_plate_and_hub.stl

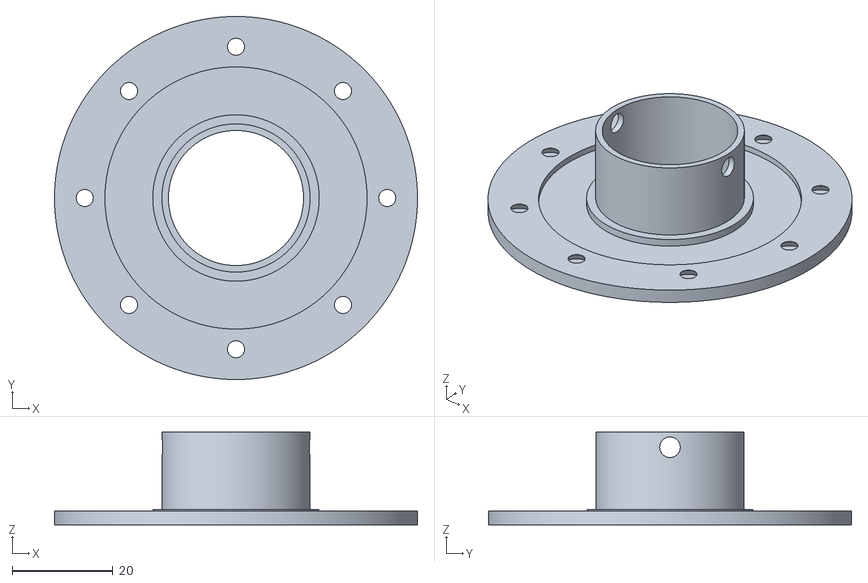
[picture p28: CAD file, 2026-11-06]
body parts/shoulder v6/cad/actuator_print/23_Front_plate_and_hub.stl
72.0 x 72.0 x 18.4
