shourya-khatiyan/Prime-TheHumanoid/body parts/stand-lite/cad/stl/stick_back_2.stl

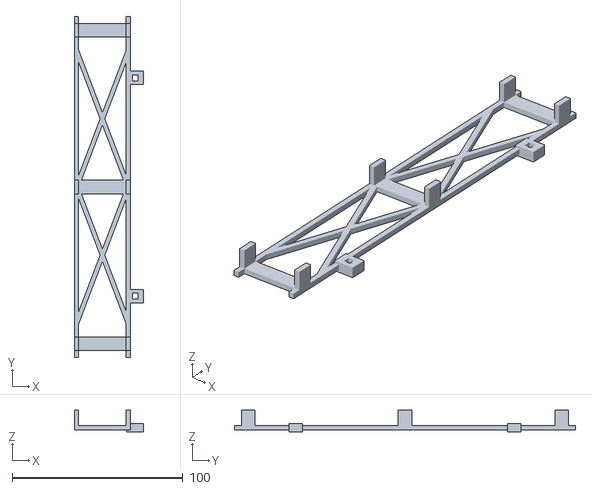
[picture p29: CAD file, 2026-11-03]
body parts/stand-lite/cad/stl/stick_back_2.stl
40.7 x 200.0 x 12.9
