shourya-khatiyan/Prime-TheHumanoid/body parts/stand/cad/stl/beam_x.stl

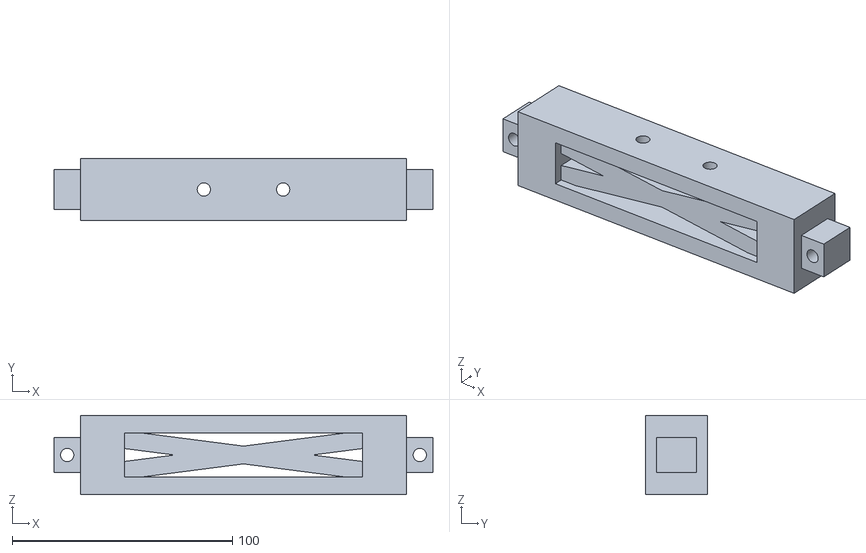
[picture p30: CAD file, 2026-11-03]
body parts/stand/cad/stl/beam_x.stl
172.0 x 28.0 x 36.0
