shourya-khatiyan/Prime-TheHumanoid/body parts/claw/cad/stl/09_foot_1.stl

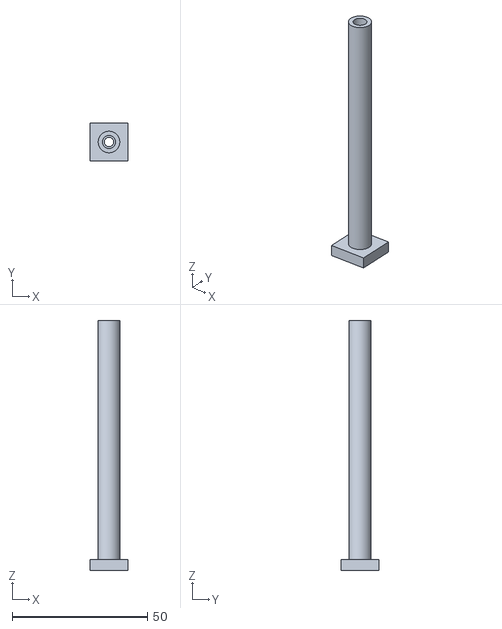
[picture p31: CAD file, 2026-11-03]
body parts/claw/cad/stl/09_foot_1.stl
14.0 x 14.0 x 92.4
