shourya-khatiyan/Prime-TheHumanoid/body parts/shoulder v6/cad/actuator_plate3.3mf

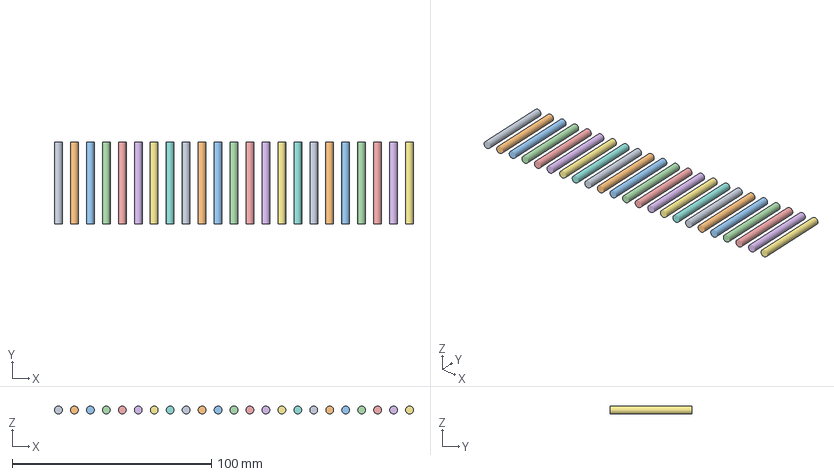
[picture p32: CAD file, 2026-11-06]
body parts/shoulder v6/cad/actuator_plate3.3mf
180.0 x 41.2 x 4.00 mm
02.26 Ring pin D4
02.27 Ring pin D4
02.28 Ring pin D4
02.29 Ring pin D4
02.30 Ring pin D4
02.31 Ring pin D4
02.32 Ring pin D4
02.33 Ring pin D4
02.34 Ring pin D4
02.35 Ring pin D4
02.36 Ring pin D4
02.37 Ring pin D4
02.38 Ring pin D4
02.39 Ring pin D4
02.40 Ring pin D4
02.41 Ring pin D4
02.42 Ring pin D4
02.43 Ring pin D4
02.44 Ring pin D4
02.45 Ring pin D4
02.46 Ring pin D4
02.12 Ring pin D4
02.18 Ring pin D4
