shourya-khatiyan/Prime-TheHumanoid/body parts/stand/cad/stl/clamp_upper.stl

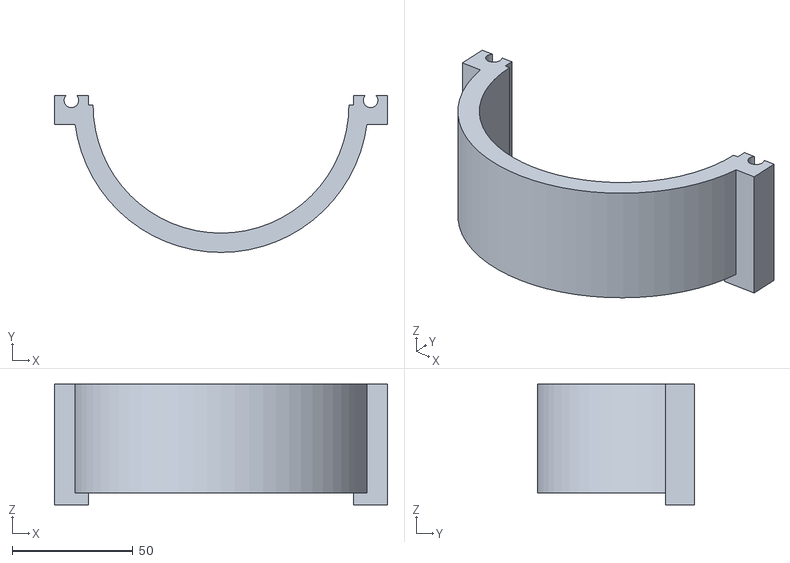
[picture p33: CAD file, 2026-11-03]
body parts/stand/cad/stl/clamp_upper.stl
138.0 x 65.0 x 50.0
