shourya-khatiyan/Prime-TheHumanoid/body parts/stand-lite/cad/stl/base_b.stl

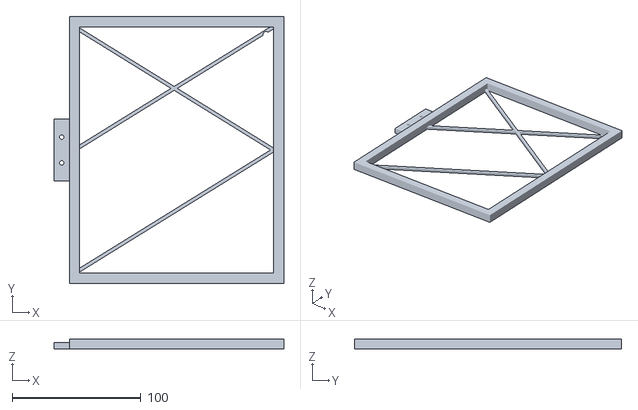
[picture p34: CAD file, 2026-11-03]
body parts/stand-lite/cad/stl/base_b.stl
178.8 x 207.6 x 8.00
