shourya-khatiyan/Prime-TheHumanoid/body parts/stand/cad/stl/foot.stl

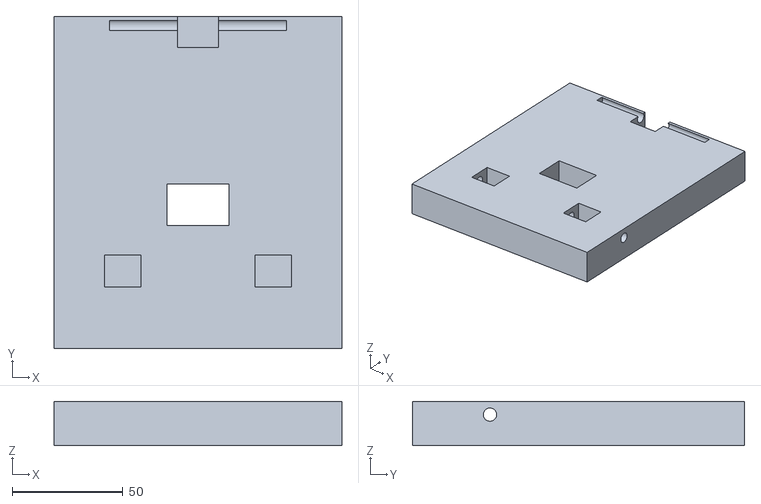
[picture p35: CAD file, 2026-11-03]
body parts/stand/cad/stl/foot.stl
130.0 x 150.0 x 20.0
