shourya-khatiyan/Prime-TheHumanoid/body parts/claw/cad/stl/08_guide.stl

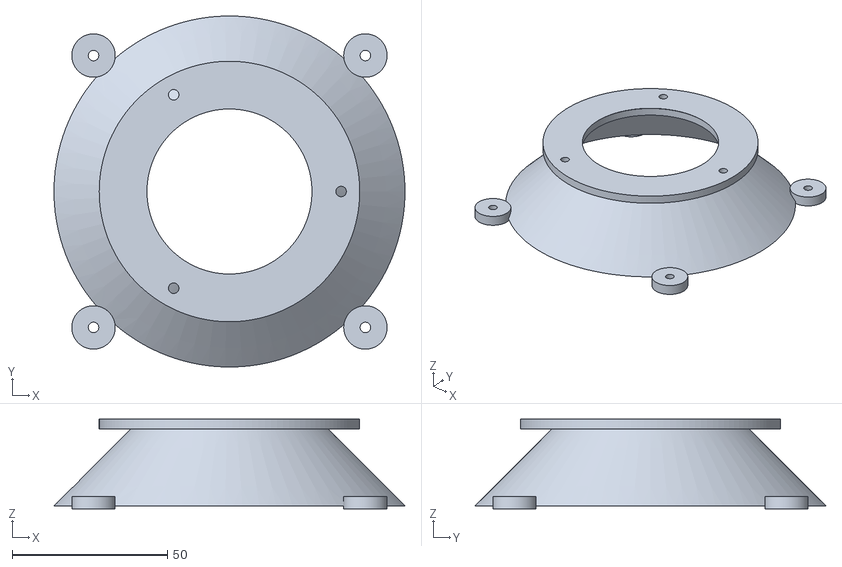
[picture p36: CAD file, 2026-11-03]
body parts/claw/cad/stl/08_guide.stl
113.2 x 113.2 x 29.0
