shourya-khatiyan/Prime-TheHumanoid/body parts/shoulder v6/cad/actuator_print/04_Cycloid_disc_B.stl

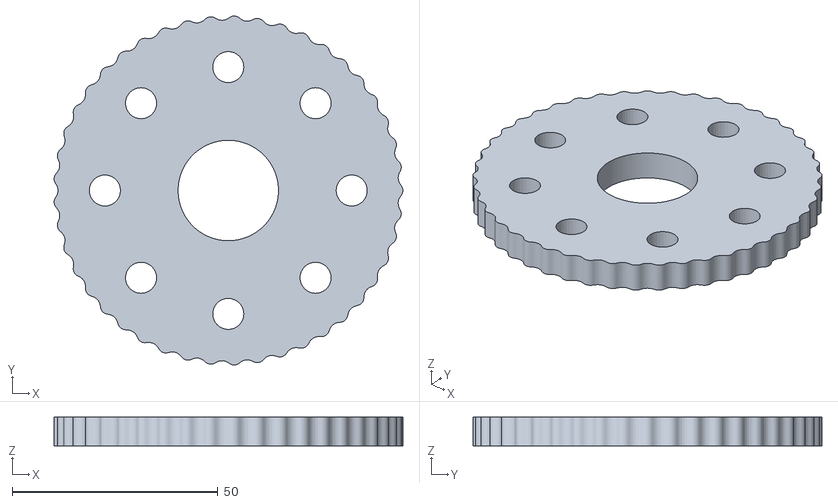
[picture p37: CAD file, 2026-11-06]
body parts/shoulder v6/cad/actuator_print/04_Cycloid_disc_B.stl
84.8 x 84.8 x 7.00
