shourya-khatiyan/Prime-TheHumanoid/body parts/stand/cad/stl/corner.stl

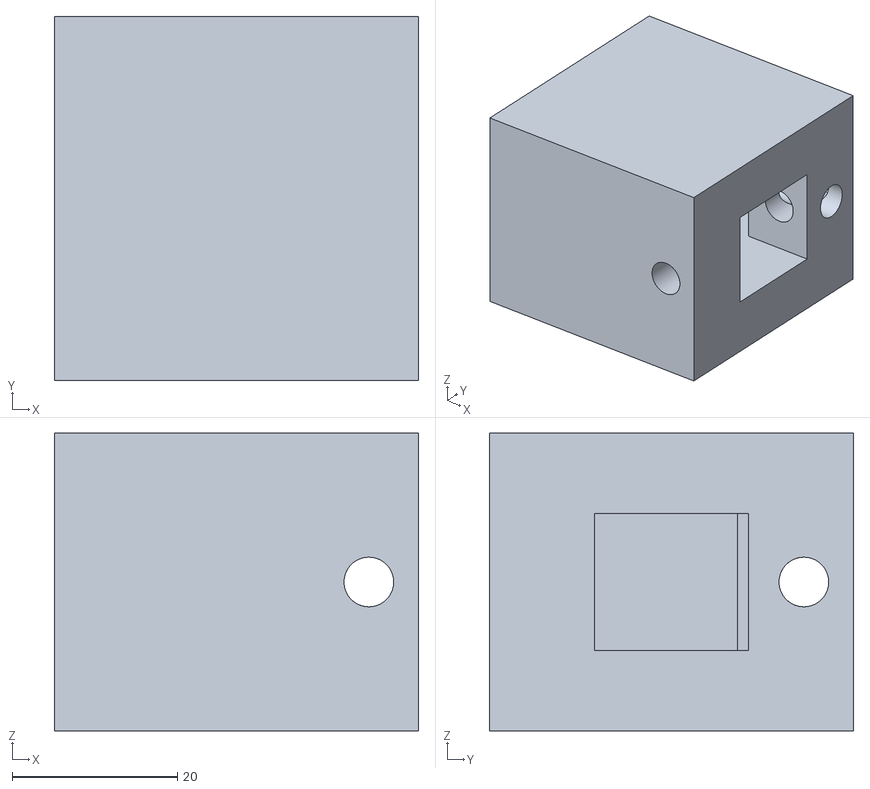
[picture p38: CAD file, 2026-11-03]
body parts/stand/cad/stl/corner.stl
44.0 x 44.0 x 36.0
