shourya-khatiyan/Prime-TheHumanoid/body parts/claw/cad/stl/04_cam.stl

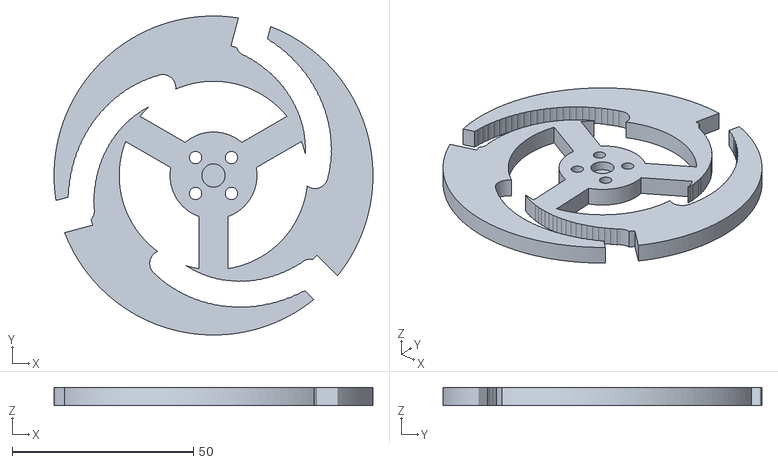
[picture p39: CAD file, 2026-11-03]
body parts/claw/cad/stl/04_cam.stl
88.0 x 88.0 x 5.00
