shourya-khatiyan/Prime-TheHumanoid/body parts/stand/cad/stl/tower_front.stl

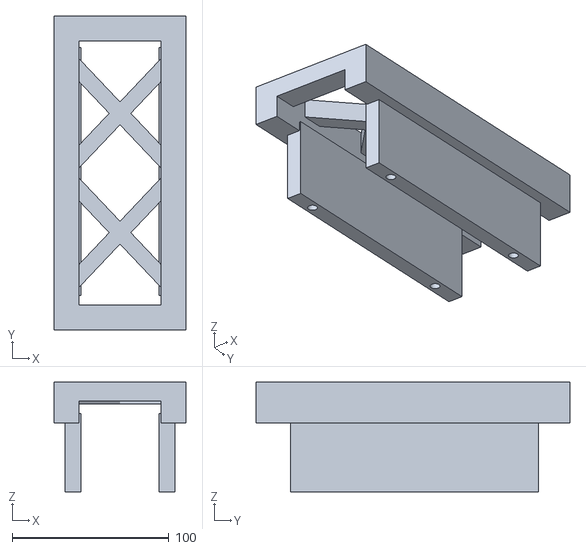
[picture p40: CAD file, 2026-11-03]
body parts/stand/cad/stl/tower_front.stl
84.0 x 200.0 x 70.0
