shourya-khatiyan/Prime-TheHumanoid/body parts/shoulder v6/cad/actuator_print/16_Encoder_lid.stl

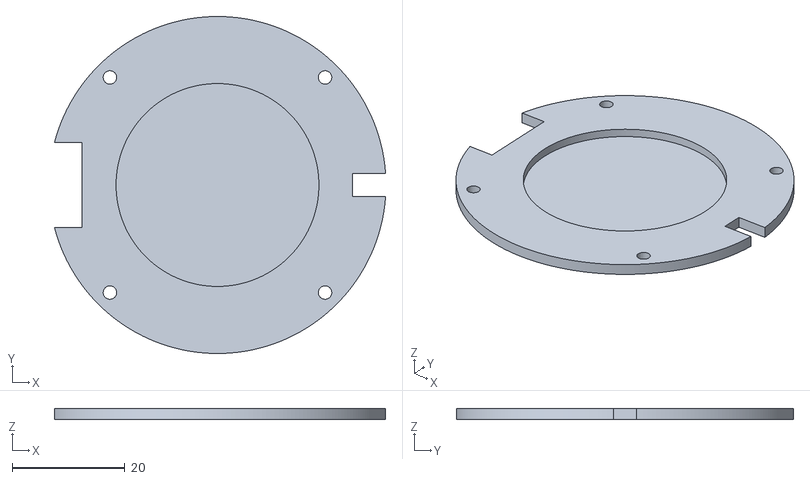
[picture p41: CAD file, 2026-11-06]
body parts/shoulder v6/cad/actuator_print/16_Encoder_lid.stl
58.8 x 59.8 x 2.00
