shourya-khatiyan/Prime-TheHumanoid/body parts/stand-lite/cad/stl/base_a.stl

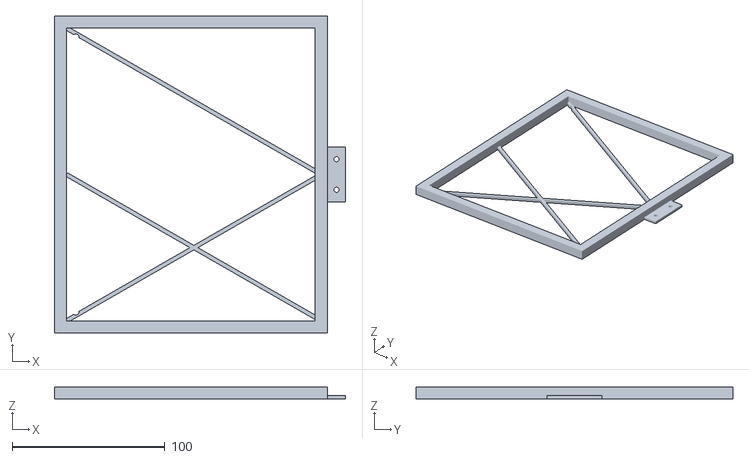
[picture p42: CAD file, 2026-11-03]
body parts/stand-lite/cad/stl/base_a.stl
190.8 x 207.6 x 8.00
