shourya-khatiyan/Prime-TheHumanoid/body parts/stand/cad/stl/coupler.stl

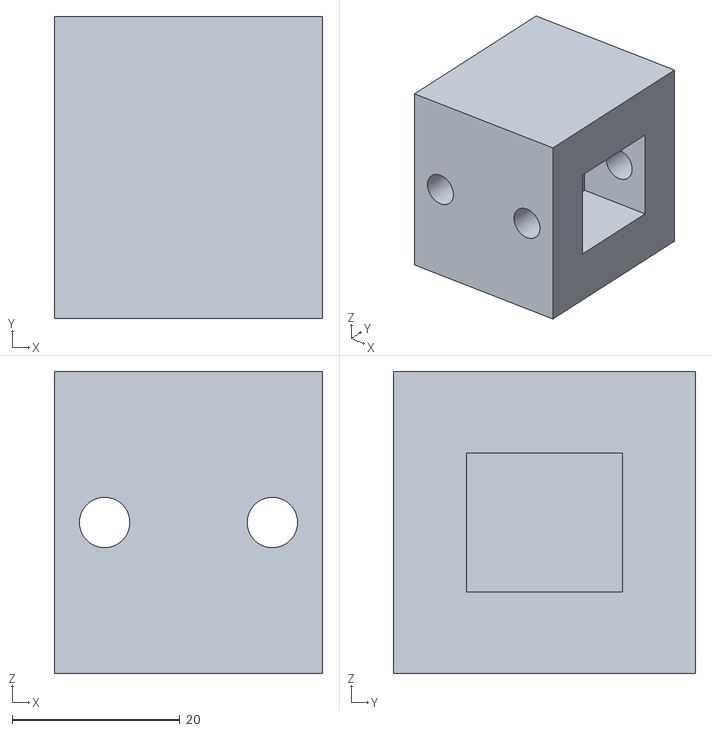
[picture p43: CAD file, 2026-11-03]
body parts/stand/cad/stl/coupler.stl
32.0 x 36.0 x 36.0
