shourya-khatiyan/Prime-TheHumanoid/body parts/shoulder v6/cad/actuator_print/07_Crank_shaft.stl

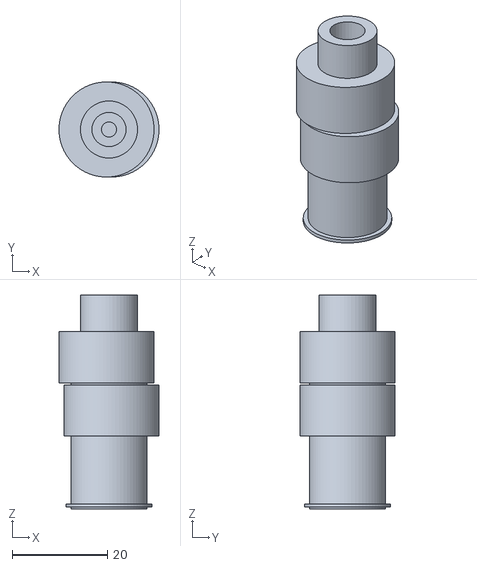
[picture p44: CAD file, 2026-11-06]
body parts/shoulder v6/cad/actuator_print/07_Crank_shaft.stl
21.1 x 20.0 x 45.0
