shourya-khatiyan/Prime-TheHumanoid/body parts/stand/cad/stl/clamp_lower.stl

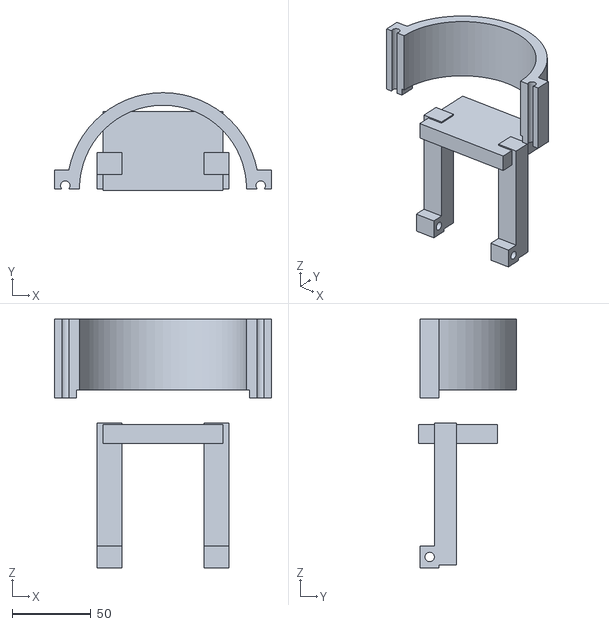
[picture p45: CAD file, 2026-11-03]
body parts/stand/cad/stl/clamp_lower.stl
138.0 x 62.0 x 158.0
