shourya-khatiyan/Prime-TheHumanoid/body parts/stand/cad/stl/beam_center.stl

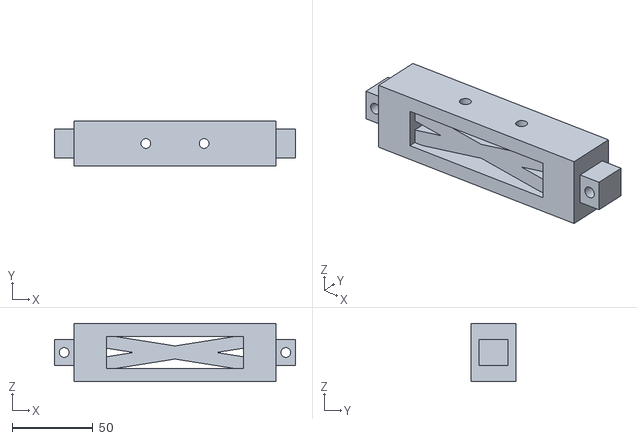
[picture p46: CAD file, 2026-11-03]
body parts/stand/cad/stl/beam_center.stl
149.0 x 28.0 x 36.0
