shourya-khatiyan/Prime-TheHumanoid/body parts/claw/cad/stl/02_carriage.stl

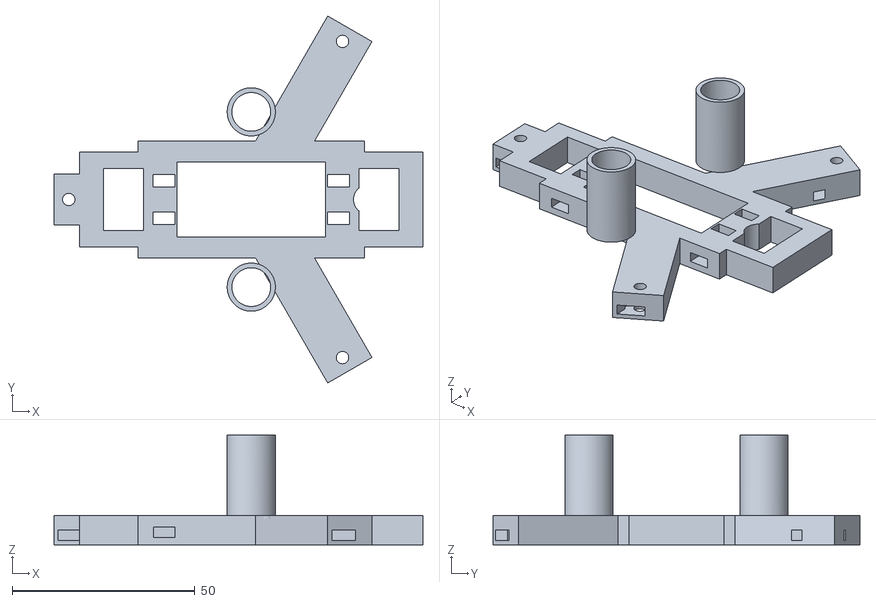
[picture p47: CAD file, 2026-11-03]
body parts/claw/cad/stl/02_carriage.stl
101.0 x 100.5 x 30.0
