shourya-khatiyan/Prime-TheHumanoid/body parts/stand/cad/stl/odrive_plate.stl

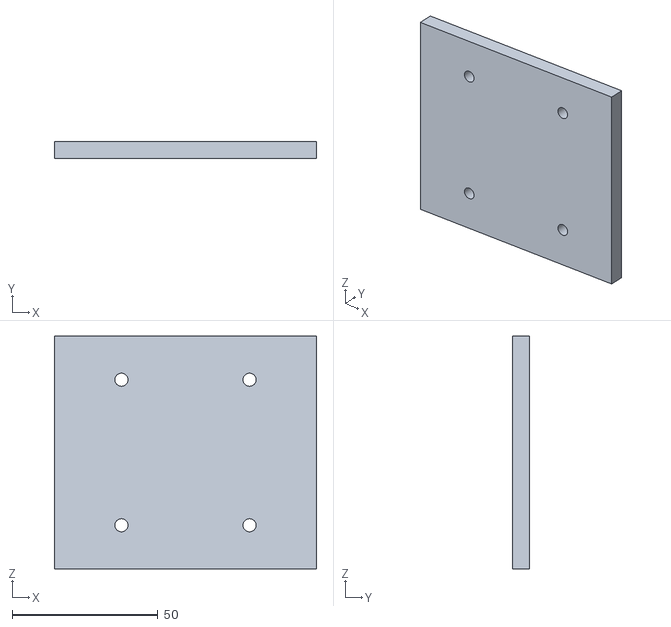
[picture p48: CAD file, 2026-11-03]
body parts/stand/cad/stl/odrive_plate.stl
90.0 x 6.00 x 80.0
