shourya-khatiyan/Prime-TheHumanoid/body parts/stand/cad/stl/fit_coupon.stl

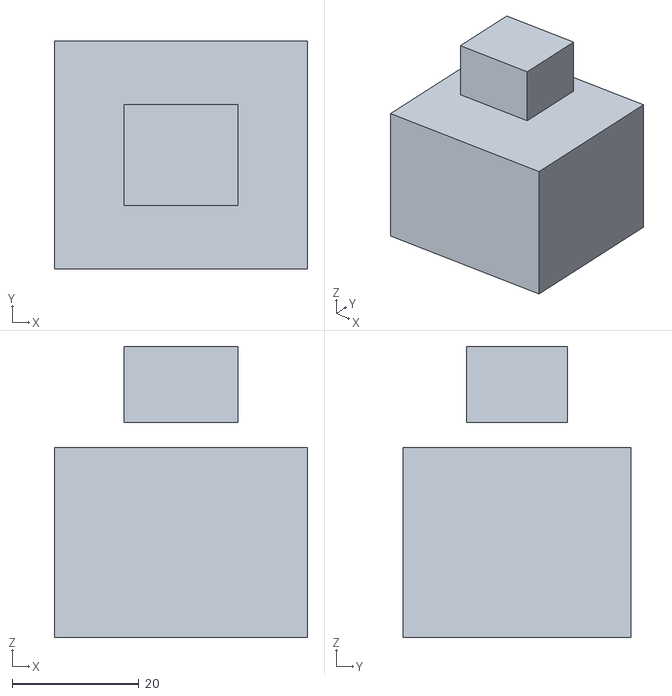
[picture p49: CAD file, 2026-11-03]
body parts/stand/cad/stl/fit_coupon.stl
40.0 x 36.0 x 46.0
