shourya-khatiyan/Prime-TheHumanoid/body parts/claw/cad/stl/07_retainer.stl

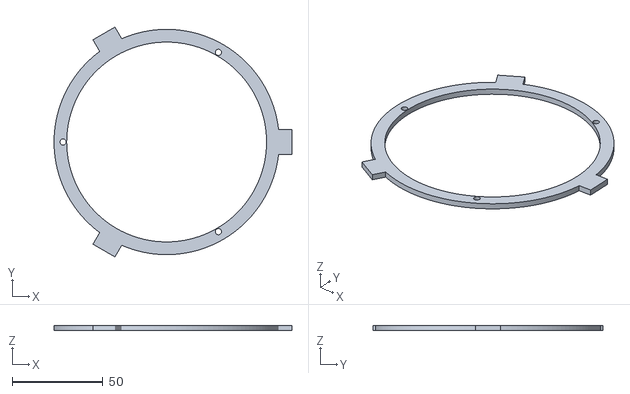
[picture p50: CAD file, 2026-11-03]
body parts/claw/cad/stl/07_retainer.stl
131.0 x 126.5 x 3.00
