shourya-khatiyan/Prime-TheHumanoid/body parts/stand/cad/stl/tower_back.stl

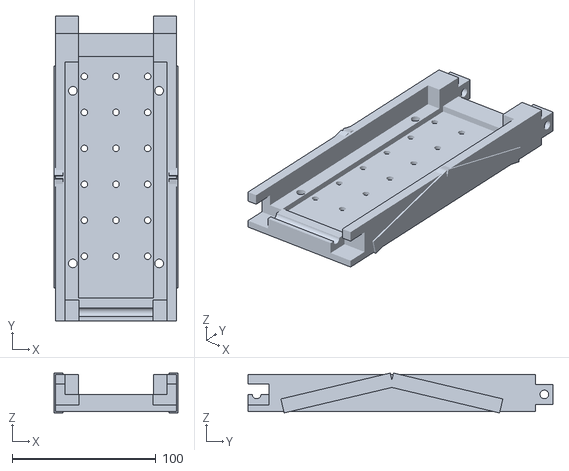
[picture p51: CAD file, 2026-11-03]
body parts/stand/cad/stl/tower_back.stl
86.0 x 212.0 x 27.7
