shourya-khatiyan/Prime-TheHumanoid/body parts/claw/cad/stl/05_housing.stl

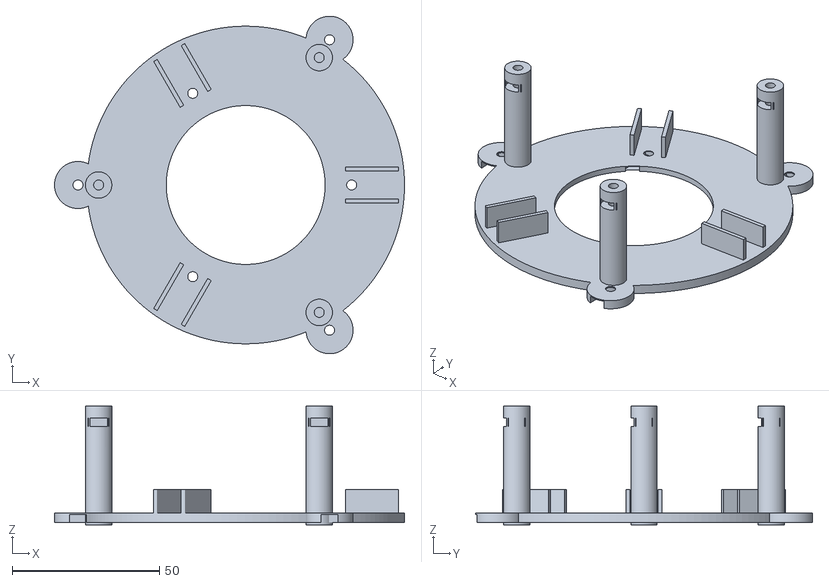
[picture p52: CAD file, 2026-11-03]
body parts/claw/cad/stl/05_housing.stl
119.0 x 114.7 x 40.4
