shourya-khatiyan/Prime-TheHumanoid/body parts/stand/cad/stl/beam_y.stl

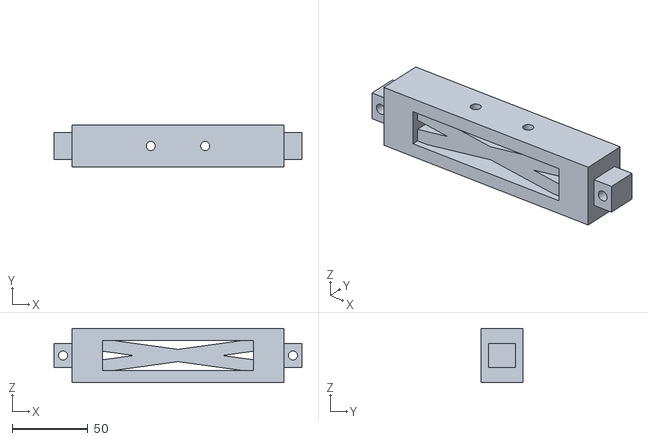
[picture p53: CAD file, 2026-11-03]
body parts/stand/cad/stl/beam_y.stl
164.0 x 28.0 x 36.0
