shourya-khatiyan/Prime-TheHumanoid/body parts/claw/cad/stl/03_stop.stl

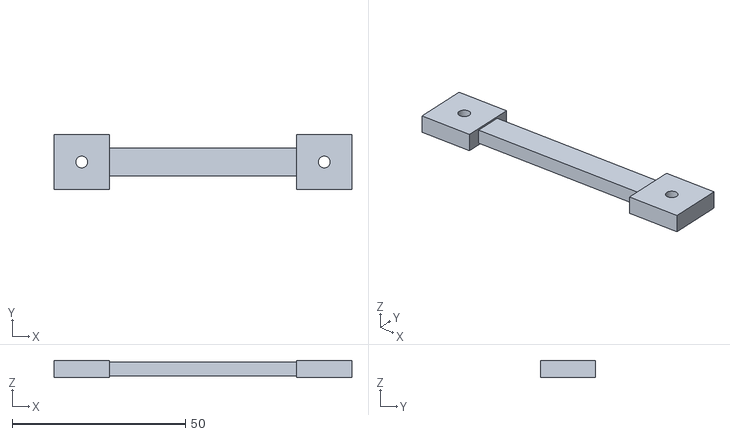
[picture p54: CAD file, 2026-11-03]
body parts/claw/cad/stl/03_stop.stl
86.0 x 16.0 x 5.00
