shourya-khatiyan/Prime-TheHumanoid/body parts/shoulder v6/cad/actuator_print/01_Housing_6082-T6.stl

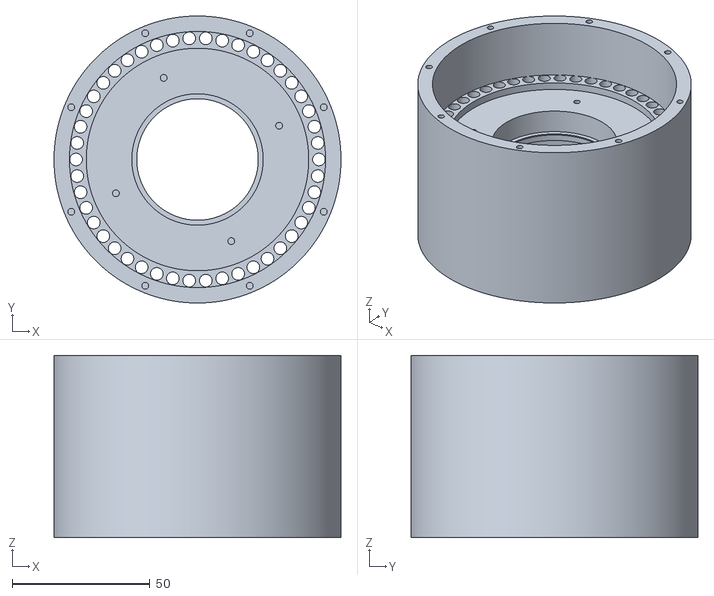
[picture p55: CAD file, 2026-11-06]
body parts/shoulder v6/cad/actuator_print/01_Housing_6082-T6.stl
104.0 x 104.0 x 66.0
