shourya-khatiyan/Prime-TheHumanoid/body parts/shoulder v6/cad/actuator_print/15_Front_cover.stl

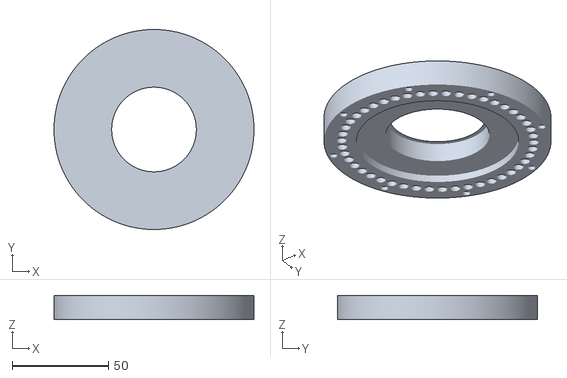
[picture p56: CAD file, 2026-11-06]
body parts/shoulder v6/cad/actuator_print/15_Front_cover.stl
104.0 x 104.0 x 12.5
