shourya-khatiyan/Prime-TheHumanoid/body parts/shoulder v6/cad/actuator_print/31_Fit_coupon.stl

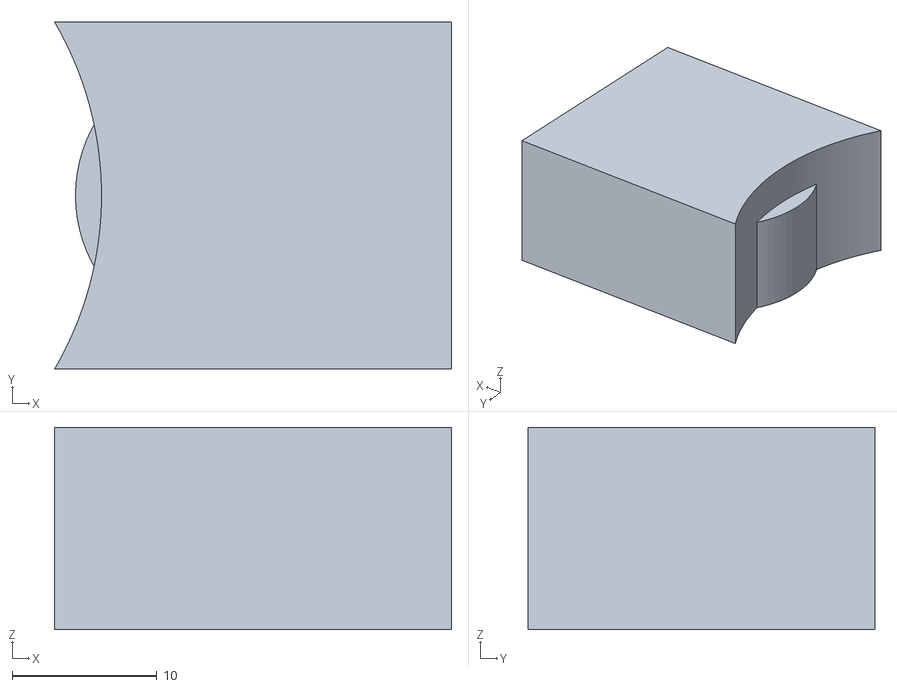
[picture p57: CAD file, 2026-11-06]
body parts/shoulder v6/cad/actuator_print/31_Fit_coupon.stl
27.4 x 24.0 x 14.0
