shourya-khatiyan/Prime-TheHumanoid/body parts/shoulder v6/cad/actuator_print/08_Rear_carrier.stl

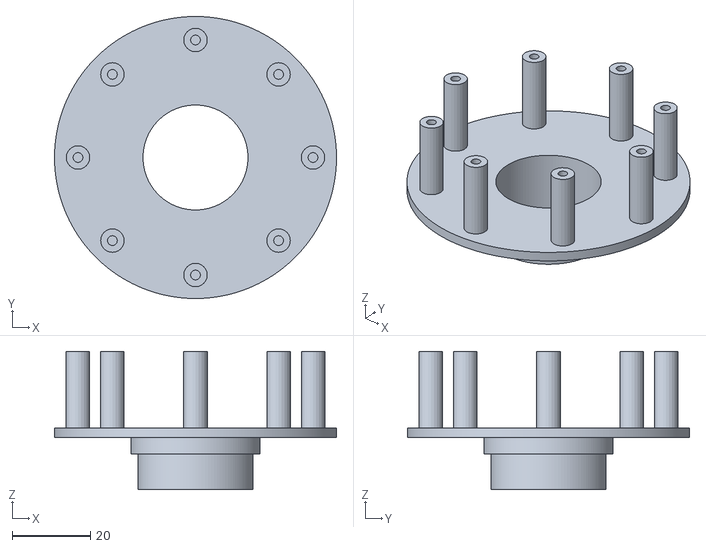
[picture p58: CAD file, 2026-11-06]
body parts/shoulder v6/cad/actuator_print/08_Rear_carrier.stl
72.0 x 72.0 x 35.3
