shourya-khatiyan/Prime-TheHumanoid/body parts/shoulder v6/cad/actuator_print/27_Bearing_retainer.stl

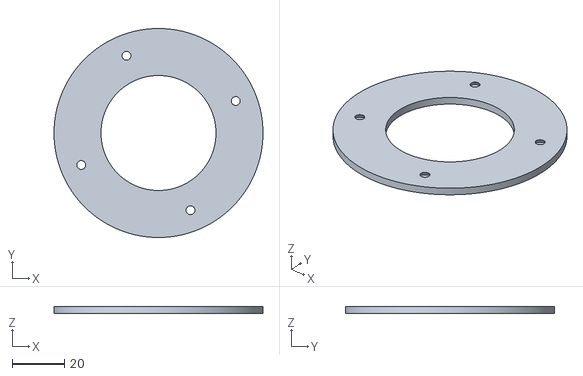
[picture p59: CAD file, 2026-11-06]
body parts/shoulder v6/cad/actuator_print/27_Bearing_retainer.stl
80.0 x 80.0 x 2.60
