shourya-khatiyan/Prime-TheHumanoid/body parts/shoulder v6/cad/actuator_print/25_Arm_flange.stl

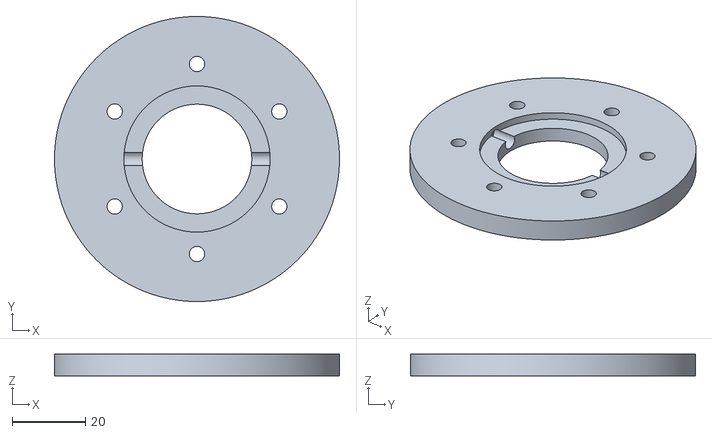
[picture p60: CAD file, 2026-11-06]
body parts/shoulder v6/cad/actuator_print/25_Arm_flange.stl
78.0 x 78.0 x 6.00
