shourya-khatiyan/Prime-TheHumanoid/body parts/shoulder v6/cad/actuator_print/13_Rear_plate_6082-T6.stl

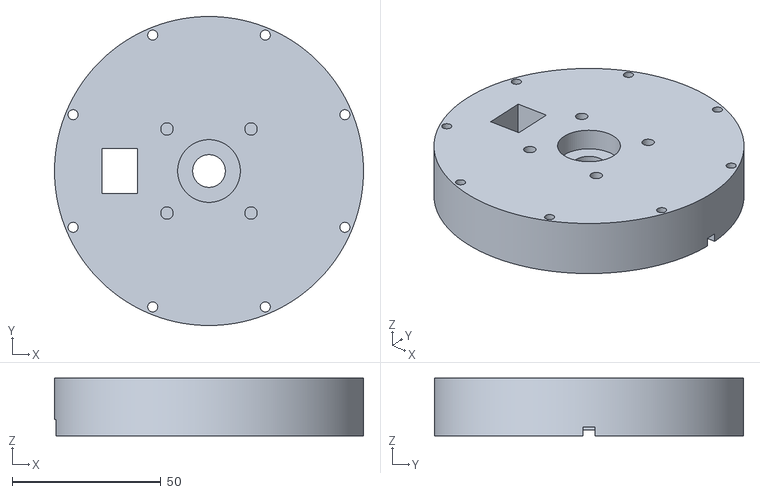
[picture p61: CAD file, 2026-11-06]
body parts/shoulder v6/cad/actuator_print/13_Rear_plate_6082-T6.stl
104.0 x 104.0 x 19.4
