shourya-khatiyan/Prime-TheHumanoid/body parts/shoulder v6/cad/actuator_print/19_Crank_flange.stl

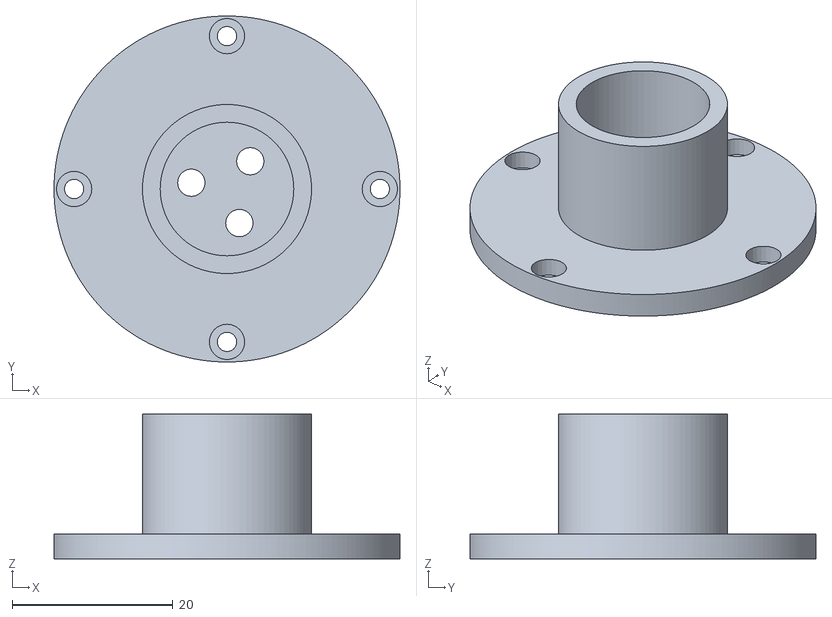
[picture p62: CAD file, 2026-11-06]
body parts/shoulder v6/cad/actuator_print/19_Crank_flange.stl
43.0 x 43.0 x 18.0
