shourya-khatiyan/Prime-TheHumanoid/body parts/shoulder v6/cad/actuator_print/26_Cross_pin_D4.stl

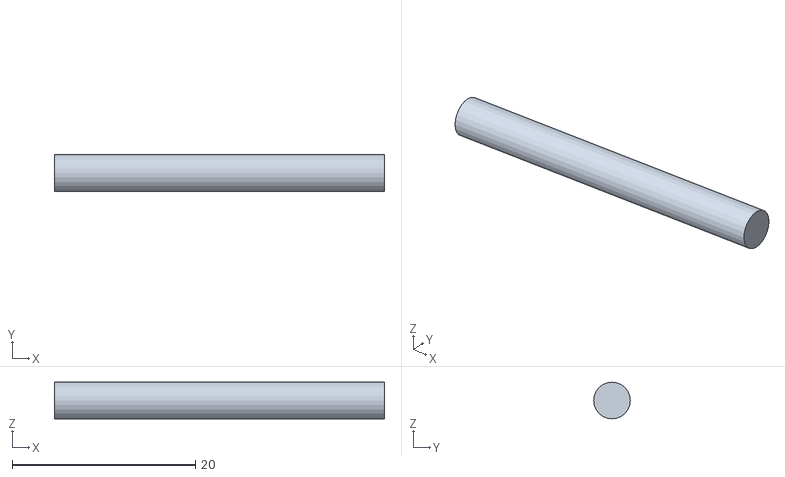
[picture p63: CAD file, 2026-11-06]
body parts/shoulder v6/cad/actuator_print/26_Cross_pin_D4.stl
36.0 x 4.00 x 4.00
