shourya-khatiyan/Prime-TheHumanoid/(list of files, cad)

Other CAD files:
body parts/shoulder v6/cad/actuator_print/02.18_Ring_pin_D4.stl
body parts/shoulder v6/cad/actuator_print/03_Cycloid_disc_A.stl
body parts/shoulder v6/cad/actuator_print/02.12_Ring_pin_D4.stl
body parts/shoulder v6/cad/actuator_print/02.13_Ring_pin_D4.stl
body parts/arm/cad/arm.3mf
body parts/arm/cad/arm.f3d
body parts/elbow v0/cad/actuator.3mf
body parts/elbow v0/cad/actuator.step
body parts/hand/cad/hand.3mf
body parts/shoulder v2/cad/actuator.3mf
body parts/shoulder v2/cad/actuator.step
body parts/shoulder v3/cad/actuator.3mf
body parts/shoulder v3/cad/actuator.step
body parts/shoulder v4/cad/actuator.3mf
body parts/shoulder v4/cad/actuator.step
body parts/shoulder v5/cad/actuator.3mf
body parts/shoulder v5/cad/actuator.step
body parts/shoulder v6/cad/actuator.3mf
body parts/shoulder v6/cad/actuator_print/21_Front_washer.stl
body parts/shoulder/cad/actuator.3mf
body parts/shoulder/cad/actuator.step
body parts/shoulder/cad/actuator_occ.3mf
body parts/shoulder/cad/milling/step/VAYN_shoulder_milling.step
body parts/stand-lite/cad/stand_lite.3mf
