shourya-khatiyan/Prime-TheHumanoid/obsidian-robot-vault/Experimenting with training.md

# OpenVLA Fine-Tuning Experimentation Techniques

Here is a detailed table of all the techniques we can experiment with during our OpenVLA fine-tuning.

---

## Training Optimization Techniques

| Technique | What It Does | How We Use It | What We Can Change | Precautions |
| :--- | :--- | :--- | :--- | :--- |
| Batch Size | The number of samples the model sees before updating its weights. | Set in our dataloader or training script. | Try 4, 8, 16, 32, 64, or 128. | Larger batches need more memory. If we get out of memory errors, we must reduce it. |
| Gradient Accumulation | Simulates a larger batch by summing gradients over several steps before updating. | Set `gradient_accumulation_steps` in our training script. | Try 2, 4, or 8 steps. | Too many steps can slow down training. It does not reduce memory usage for activations. |
| Learning Rate | Controls how big a step the model takes when updating its weights. | Set in our optimizer. | Try values like `1e-5`, `5e-5`, `1e-4`, `5e-4`, or `1e-3`. | Too high leads to unstable training. Too low makes training very slow. |
| Learning Rate Warmup | Gradually increases the learning rate from a small value to our target. | Use a warmup scheduler like linear warmup. | Try warmup steps of 100, 500, or 1000. | Skipping warmup can cause early training instability. |
| Learning Rate Decay | Gradually reduces the learning rate as training progresses. | Use a scheduler like step decay or cosine annealing. | Try step decay every 5 epochs or cosine annealing over the total epochs. | Decaying too early can prevent the model from learning fully. |
| Optimizer | The algorithm that updates our model weights. | Choose Adam, AdamW, or SGD. | AdamW is usually safest. SGD with momentum can generalize better. | AdamW needs weight decay set separately. SGD needs careful learning rate tuning. |
| Weight Decay | Adds a penalty for large weights to prevent overfitting. | Set the `weight_decay` parameter in our optimizer. | Try `0.0`, `0.01`, `0.001`, or `0.0001`. | Too much weight decay can underfit. Too little can overfit. |
| Gradient Clipping | Prevents gradients from becoming too large and destabilizing training. | Add `clip_grad_norm_` or `clip_grad_value_` to our training loop. | Try max norm of `0.5`, `1.0`, or `5.0`. | Clipping too aggressively can slow learning. Too little may not prevent instability. |
| Mixed Precision Training | Uses lower precision numbers to speed up training and save memory. | Use `torch.cuda.amp` or similar. | Try `float16` or `bfloat16`. | Some operations may not work well in lower precision. Monitor for accuracy drops. |

---

## Memory and Speed Techniques

| Technique | What It Does | How We Use It | What We Can Change | Precautions |
| :--- | :--- | :--- | :--- | :--- |
| Gradient Checkpointing | Saves memory by recomputing activations during backward pass instead of storing them. | Use `torch.utils.checkpoint` around certain layers. | Checkpoint entire transformer blocks or just specific layers. | Increases training time because it recomputes. Use only when memory is tight. |
| Efficient Data Loading | Loads data in parallel so GPUs are not waiting idle. | Set `num_workers` in our dataloader. | Try 2, 4, 8, or 16 workers. | Too many workers can use too much CPU memory. Too few can starve the GPU. |
| FastVLA Tokenization | Compresses action sequences into compact tokens for faster training. | Use FastVLA implementation from the OpenVLA codebase. | Try different action chunk sizes. | May reduce inference speed. Test performance carefully. |
| Parallel Decoding | Predicts multiple action tokens at once during inference. | Follow the OpenVLA-OFT recipe. | Experiment with different decoding strategies. | May affect prediction quality. Always validate on our test set. |
| Action Chunking | Predicts a sequence of future actions in one go. | Follow the OpenVLA-OFT recipe. | Try chunk sizes of 8, 16, or 32. | Larger chunks can improve speed but may reduce flexibility. |
---

## Regularization Techniques

| Technique | What It Does | How We Use It | What We Can Change | Precautions |
| :--- | :--- | :--- | :--- | :--- |
| Dropout | Randomly ignores some neurons during training to prevent overfitting. | Add `torch.nn.dropout` layers to our model. | Try dropout rates of 0.1, 0.2, or 0.5. | Too high can underfit. Too low has little effect. |
| Early Stopping | Stops training when validation performance stops improving. | Monitor validation loss and stop after a set number of epochs without improvement. | Try patience of 3, 5, or 10 epochs. | Stopping too early can leave performance on the table. |
| Label Smoothing | Makes labels softer to prevent overconfidence. | Set `label_smoothing` in our loss function. | Try smoothing values of 0.05, 0.1, or 0.2. | Too much smoothing can hurt performance. |
| Data Augmentation | Creates modified versions of our data to increase dataset size. | Apply random transforms like rotation, cropping, or color jitter. | Try different combinations of transforms. | Unrealistic augmentations can hurt real-world performance. |
| Synthetic Instruction Augmentation | Uses an LLM to create new language instructions for our data. | Generate paraphrases of existing instructions. | Try different LLMs or prompting strategies. | Poor quality generations can confuse the model. |

---

## Model Architecture Techniques

| Technique | What It Does | How We Use It | What We Can Change | Precautions |
| :--- | :--- | :--- | :--- | :--- |
| LoRA Rank | Controls how many trainable parameters we add to the model. | Set `lora_rank` in our LoRA configuration. | Try ranks of 4, 8, 16, 32, or 64. | Higher ranks need more memory. Lower ranks may not capture enough task-specific knowledge. |
| LoRA Target Modules | Which layers we apply LoRA to. | Set `target_modules` in our LoRA configuration.  | Try targeting only attention layers or both attention and feedforward layers. | Targeting more layers uses more memory. Targeting too few may limit adaptation. |
| Freezing Layers | Keeps some parts of the model frozen and not updated. | Set `requires_grad = false` for specific layers. | Try freezing the vision encoder or parts of the language model. | Freezing too much may prevent the model from learning our specific task. |
| Full Fine-Tuning | Updates all model parameters. | Simply disable LoRA and train normally. | Can try for higher performance. | Requires much more memory and time. Risk of catastrophic forgetting. |
---

## Hyperparameter Tuning Techniques

| Technique | What It Does | How We Use It | What We Can Change | Precautions |
| :--- | :--- | :--- | :--- | :--- |
| Grid Search | Tries every combination of hyperparameters from a fixed list. | Define a grid and run experiments for each combination. | Try different combinations of learning rate and batch size. | Can be very expensive. Only use for a small number of parameters. |
| Random Search | Randomly samples hyperparameters from a defined range. | Define ranges and sample randomly. | Try random values for learning rate and rank. | More efficient than grid search. Does not guarantee finding the best combination. |
| Bayesian Optimization | Uses a probabilistic model to find optimal hyperparameters. | Use a library like Optuna or Hyperopt. | Define a search space and run for a fixed number of trials. | Can be complex to set up. Works well for medium number of parameters. |
| Hyperband | Stops poor performing configurations early to save resources. | Use a library like Optuna or Keras Tuner. | Set maximum epochs and reduction factor. | Can stop configurations that might have improved later. Use with care. |

---

## Checkpointing and Recovery Techniques

| Technique | What It Does | How We Use It | What We Can Change | Precautions |
| :--- | :--- | :--- | :--- | :--- |
| Saving Checkpoints | Saves the complete training state at regular intervals. | Use `model.save_checkpoint` or a callback. | Save every epoch or every n steps. | Saving too frequently uses disk space. Saving too rarely risks losing progress. |
| Best Model Checkpoint | Saves only the model that performs best on validation data. | Use a callback that monitors validation loss. | Monitor validation loss or validation accuracy. | Need a validation set. Saving only the best means we may not save the final state. |
| Checkpoint Retention Limit | Limits how many old checkpoints we keep. | Set `save_total_limit` in our checkpoint callback. | Try keeping 1, 3, or 5 checkpoints. | Keeping too few means we cannot roll back far. Keeping too many uses disk space. |
| Training Resume | Restarts training from a saved checkpoint. | Load the checkpoint state and continue training. | Resume from the latest checkpoint or a specific one. | Need to ensure all training states are saved and loaded correctly. |

---

## How to Use This Table for Our Experiments

The best way to use this table is to be systematic. We should not change everything at once. Here is a simple process we can follow.

1. **Start with a baseline.** Run one full training with the standard OpenVLA LoRA recipe. Record our results. This is our reference point.

2. **Pick one technique.** Choose something we want to experiment with from the table. For example, we might try increasing batch size or trying a different learning rate.

3. **Change only that one thing.** Keep everything else exactly the same as our baseline.

4. **Run the experiment.** Train our model again with only that one change.

5. **Compare the results.** Check if the change improved our validation loss, training time, or final performance.

6. **Decide what to do next.** If the change helped, we can keep it and try another. If it did not help, we can try a different variation or discard it.

7. **Combine successful changes.** After we find a few changes that work, we can combine them together for even better results.

This systematic approach will help us understand what works best for our specific project and avoid wasting time on changes that do not help.
