shourya-khatiyan/Prime-TheHumanoid/body parts/shoulder/cad/milling/drawing/01_encoder_lid.pdf

VAYN shoulder · milling drawing · 01 Encoder lid | Pack A · Rev 1.4 · redrawn 31 Oct 2026
01

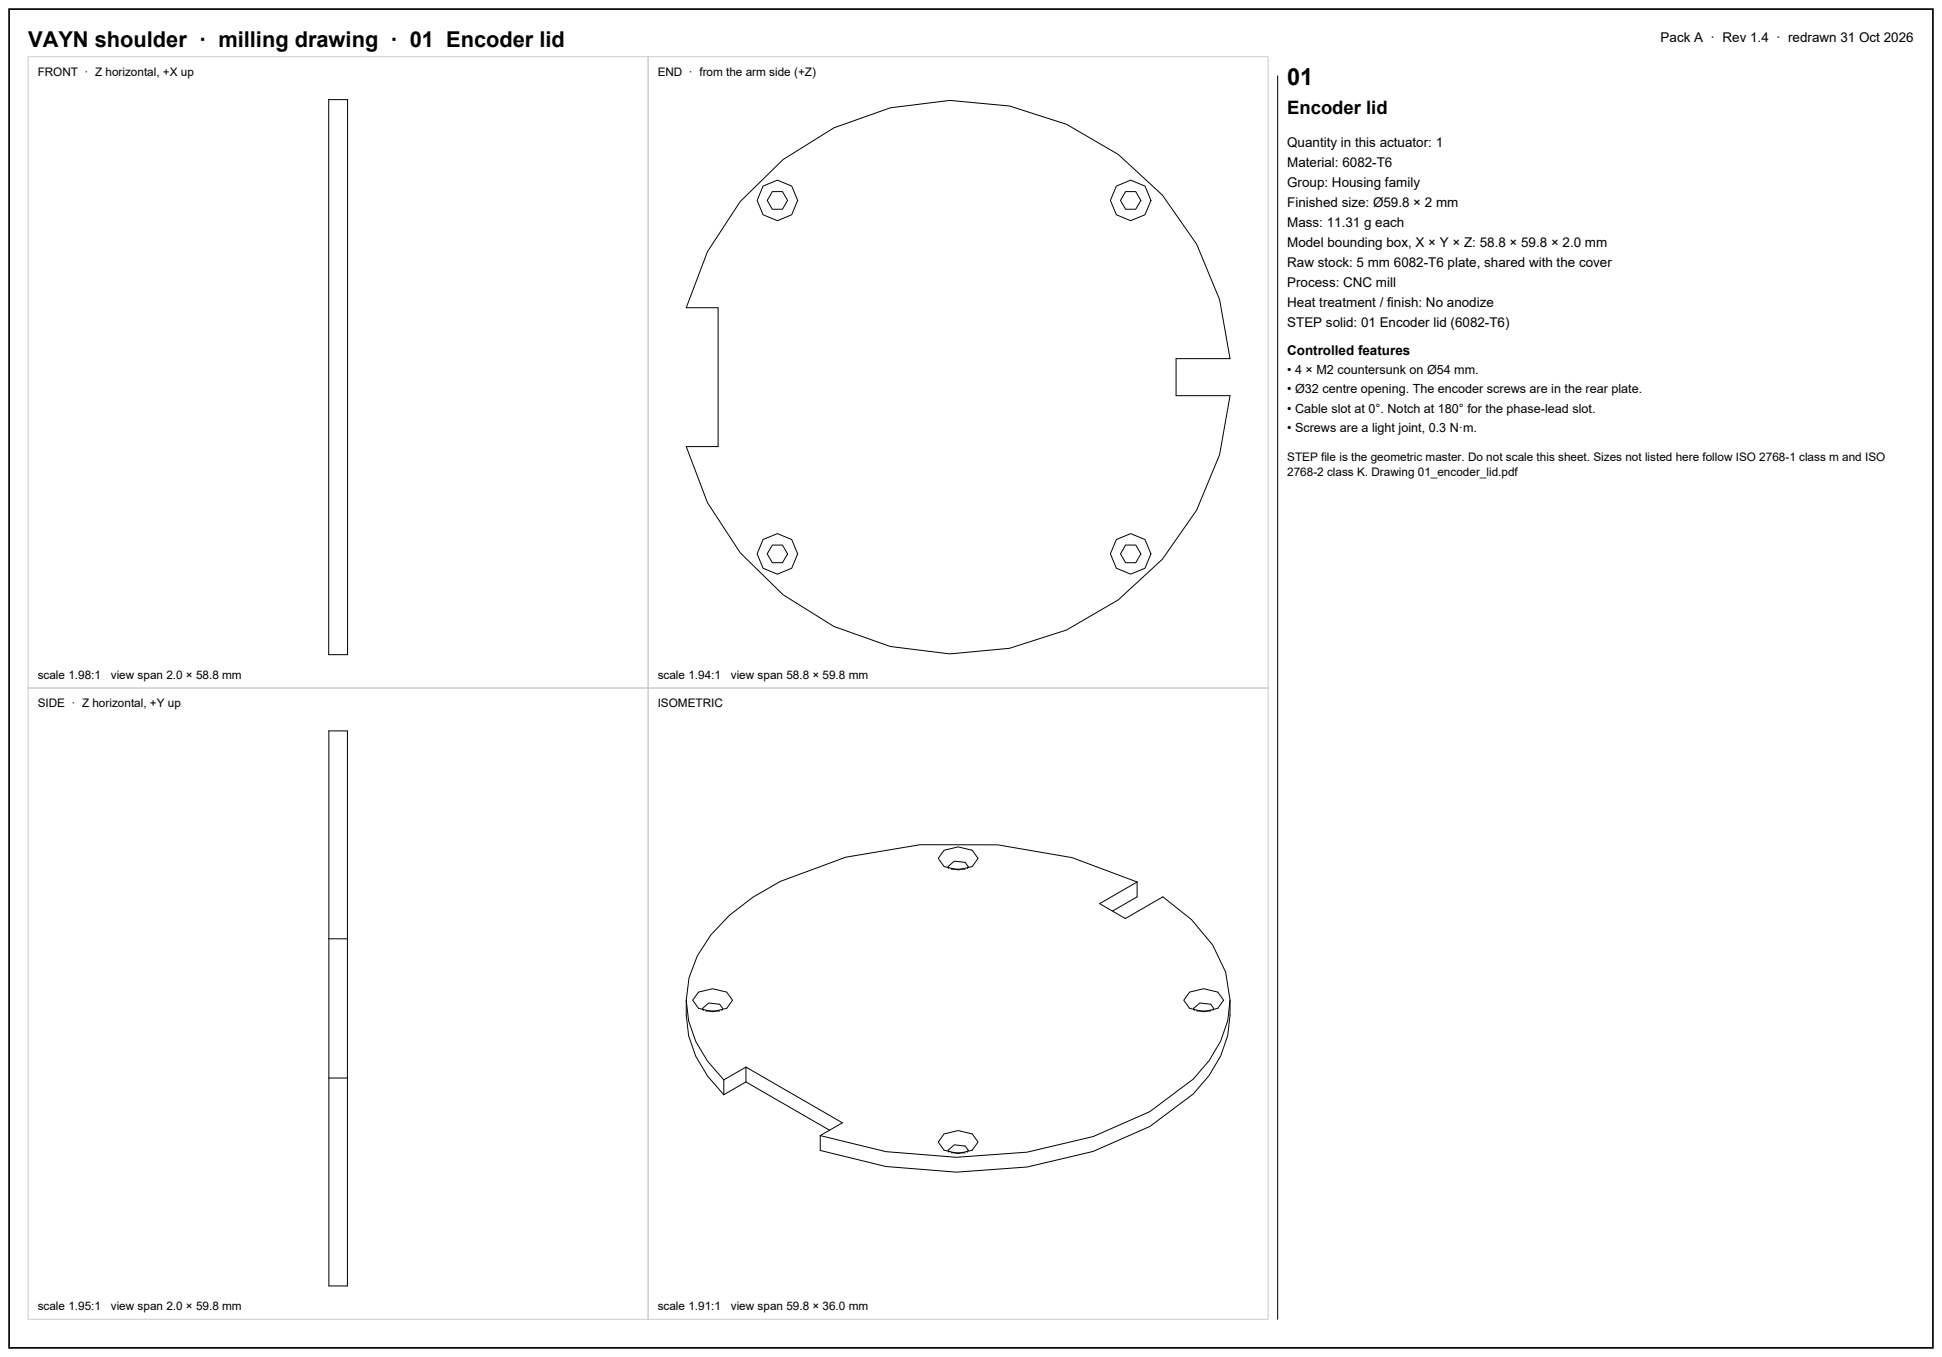
[picture p64: page 1]
ISOMETRIC; Encoder lid

FRONT · Z horizontal, +X up

END · from the arm side (+Z)

Quantity in this actuator: 1
Material: 6082-T6
Group: Housing family
Finished size: Ø59.8 × 2 mm
Mass: 11.31 g each
Model bounding box, X × Y × Z: 58.8 × 59.8 × 2.0 mm
Raw stock: 5 mm 6082-T6 plate, shared with the cover
Process: CNC mill
Heat treatment / finish: No anodize
STEP solid: 01 Encoder lid (6082-T6)

Controlled features
• 4 × M2 countersunk on Ø54 mm.
• Ø32 centre opening. The encoder screws are in the rear plate.
• Cable slot at 0°. Notch at 180° for the phase-lead slot.
• Screws are a light joint, 0.3 N·m.

STEP file is the geometric master. Do not scale this sheet. Sizes not listed here follow ISO 2768-1 class m and ISO
2768-2 class K. Drawing 01_encoder_lid.pdf

scale 1.98:1 view span 2.0 × 58.8 mm

scale 1.94:1 view span 58.8 × 59.8 mm

SIDE · Z horizontal, +Y up

scale 1.95:1 view span 2.0 × 59.8 mm

scale 1.91:1 view span 59.8 × 36.0 mm
