shourya-khatiyan/Prime-TheHumanoid/body parts/shoulder/cad/milling/drawing/21_carrier_1_rear.pdf

# VAYN shoulder · milling drawing · 21 Carrier-1 rear

21

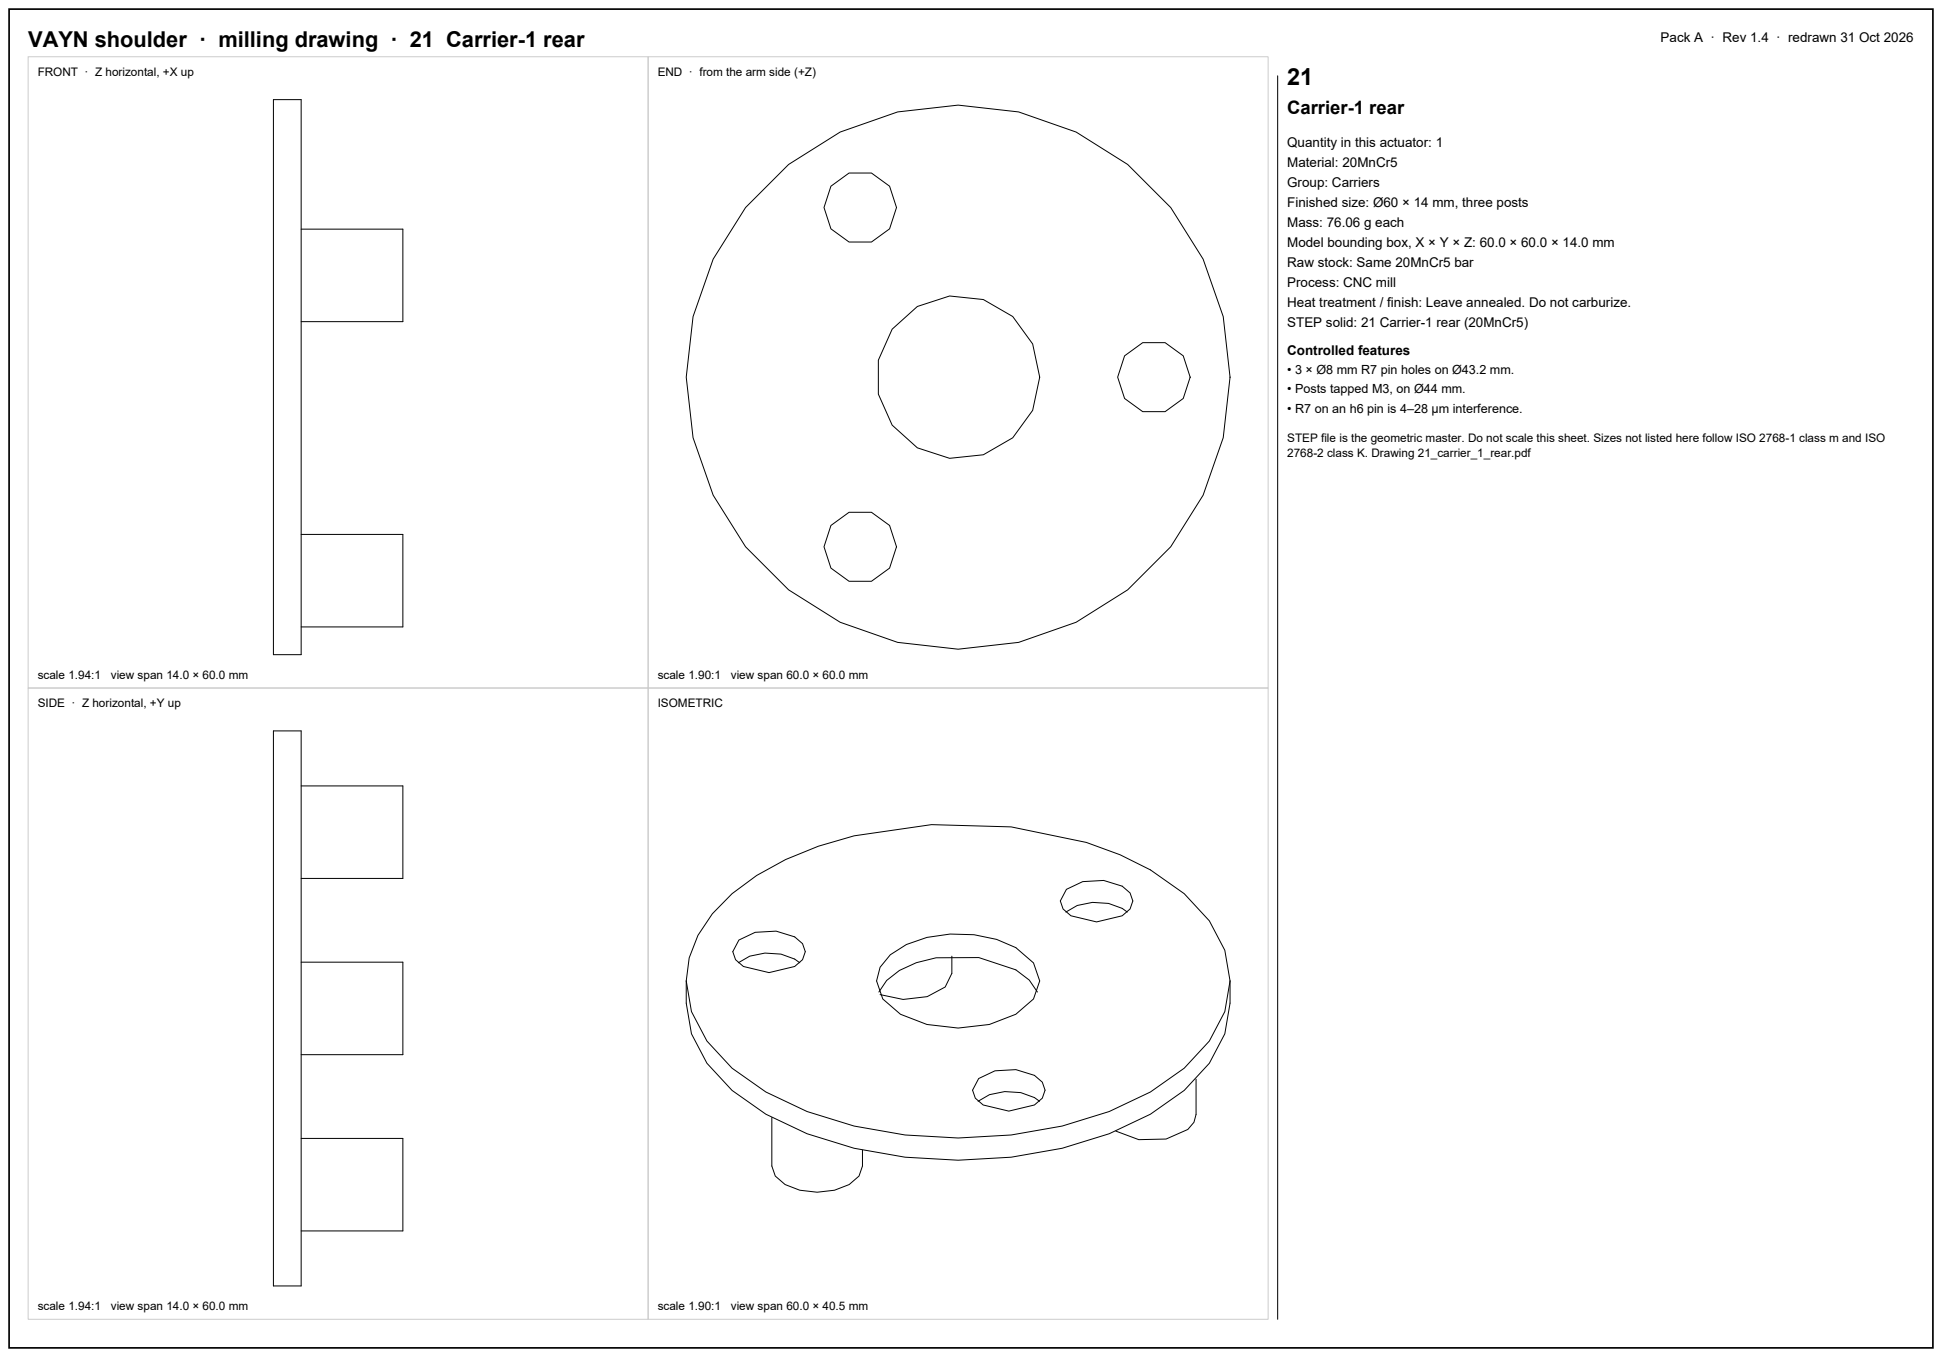
[picture p65: page 1]
ISOMETRIC; Carrier-1 rear

Pack A · Rev 1.4 · redrawn 31 Oct 2026

FRONT · Z horizontal, +X up

END · from the arm side (+Z)

Quantity in this actuator: 1
Material: 20MnCr5
Group: Carriers
Finished size: Ø60 × 14 mm, three posts
Mass: 76.06 g each
Model bounding box, X × Y × Z: 60.0 × 60.0 × 14.0 mm
Raw stock: Same 20MnCr5 bar
Process: CNC mill
Heat treatment / finish: Leave annealed. Do not carburize.
STEP solid: 21 Carrier-1 rear (20MnCr5)

Controlled features
• 3 × Ø8 mm R7 pin holes on Ø43.2 mm.
• Posts tapped M3, on Ø44 mm.
• R7 on an h6 pin is 4–28 µm interference.

STEP file is the geometric master. Do not scale this sheet. Sizes not listed here follow ISO 2768-1 class m and ISO
2768-2 class K. Drawing 21_carrier_1_rear.pdf

scale 1.94:1 view span 14.0 × 60.0 mm

scale 1.90:1 view span 60.0 × 60.0 mm

SIDE · Z horizontal, +Y up

scale 1.90:1 view span 60.0 × 40.5 mm
