shourya-khatiyan/Prime-TheHumanoid/odrive/backend/profiles/vayn_shoulder.yaml

# actuator profile for the vayn shoulder bench actuator (phase 1, rev 0).
# every limit here is enforced by the backend before a write reaches the odrive.
# values marked "unproven" must be replaced by measured data from the test runners.

name: VAYN shoulder actuator rev0
axis: 0

motor:
  kv: 90
  pole_pairs: 20
  # datasheet 0.186 ohm is line-to-line; odrive reports phase-to-neutral
  phase_resistance_ohm: 0.093
  resistance_tolerance: 0.6        # accept measured R within +-60 %
  current_continuous_a: 12         # continuous current limit (A)
  current_peak_a: 30               # peak current limit for 90KV 6S-12S BLDC
  calibration_current_a: 5
  resistance_calib_max_voltage_v: 4.0

# AS5047P wired over SPI (SCK/MISO/MOSI/CS) = absolute mode: 14-bit angle, no index search.
# if it is ever wired over its A/B/I pins instead, use mode INCREMENTAL, cpr 4000, use_index true.
encoder:
  mode: SPI_ABS_AMS
  cpr: 16384
  cs_gpio: 4
  use_index: false

gear:
  ratio: 30                        # 2-stage planetary gearbox: stage 1 (6:1) x stage 2 (5:1) = 30:1
  stages: [6, 5]
  efficiency: 0.87                 # unproven, set from characterization

limits:
  vel_max_turns_s: 30              # motor side; 30 turn/s = 1800 RPM (360 deg/s at 30:1 joint)
  pos_min_turns: -100              # motor turns from encoder zero
  pos_max_turns: 100
  bring_up_current_a: 12           # current limit used during commissioning

power:
  bus_min_v: 18.0                  # 6S LiPo min (3.0 V/cell)
  bus_max_v: 52.0                  # 12S LiPo full charge is 50.4 V (4.2 V/cell)
  overvoltage_trip_v: 54.0         # protects 56V ODESC bus above 12S full charge
  undervoltage_trip_v: 16.0        # below 6S cutoff
  brake_resistance_ohm: 2.0
  max_regen_current_a: 0.0
  dc_max_negative_current_a: -0.01 # bench psu cannot sink current; regen goes to the brake resistor

thermal:
  fet_warn_c: 70
  fet_abort_c: 85
  motor_warn_c: 80
  motor_abort_c: 100

watchdog:
  timeout_s: 0.5
