shourya-khatiyan/Prime-TheHumanoid/(commit log)

2026-10-05 Update actuator design and mass report: Adjusted dimensions and hole placements in `gen_actuator_3mf.py`, corrected mass values in `mass_report.txt`, and updated sensor model in BOM documentation. En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
    [VAYN_Shoulder_Actuator_Rev1_3.3mf, VAYN_Shoulder_Actuator_Rev1_3.step, VAYN_Shoulder_Actuator_Rev1_3_OCC.3mf]
2026-10-06 Remove obsolete files and add new actuator design documentation: Deleted outdated binary files and CAD specifications for the VAYN Shoulder Actuator. Introduced new design files, including 3MF and ST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
    [VAYN_Shoulder_Actuator_Rev1_2.3mf, actuator.3mf, actuator.step, actuator_occ.3mf]
2026-10-06 Add elbow actuator research and CAD files: Introduced comprehensive documentation for the elbow actuator, detailing design specifications, geometry, loads, and motion targets. Added CAD files in vari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
    [actuator.3mf, actuator.step]
2026-10-06 Update elbow actuator documentation and CAD files: Completed CAD Rev 1.0 for the elbow actuator, including detailed part specifications in `parts.md`, a comprehensive Bill of Materials in `bom.md`, a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
    [actuator.3mf, actuator.step]
2026-10-06 Add .gitignore and update elbow actuator documentation: Introduced a .gitignore file to exclude unnecessary files and directories. Updated mass estimates and part specifications in `research.md`, `bo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
    [actuator.3mf, actuator.step]
2026-10-07 Add initial documentation and CAD files for VAYN Arm Rev 0: Introduced comprehensive Bill of Materials (BOM) in `bom.md`, detailing print and metal parts, along with sourcing and assembly instruction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
    [arm.3mf, arm.step]
2026-10-07 Update arm documentation and CAD files for Rev 0: Revised part specifications in `parts.md` to reflect the removal of the dummy hand, updated mass estimates, and clarified design loads. Enhanced CAD 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
    [arm.3mf, arm.step]
2026-10-07 Refine arm documentation and CAD files for Rev 0: Updated BOM in `bom.md` to reflect the removal of the dummy hand and revised mass estimates. Adjusted part specifications in `parts.md` for improved 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
2026-10-07 Update arm documentation and CAD files for Rev 0: Revised BOM in `bom.md` to reflect updated part specifications, including the two-plate upper arm and cone-cage forearm. Adjusted mass estimates in `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
    [arm.3mf, arm.step]
2026-10-13 Add BOM and sourcing guides for VAYN Arm and Elbow Actuator: Introduced comprehensive documentation in `purchase.md`, `arm_bom.md`, and `elbow_bom.md` detailing print and metal parts, sourcing links,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
    [101_Adapter_plate_6061-T6_CNC.stl, 115_Front_ring_6061-T6_CNC_4_mm.stl]
2026-10-13 Update VAYN Shoulder Actuator documentation and CAD files for Rev 1.4: Adjusted shoulder flange dimensions in `arm_params.py` and updated mass estimates in `parts.md` to reflect changes in design. Re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
    [actuator.3mf, actuator.step, actuator_occ.3mf, arm.3mf, arm.step]
2026-10-13 Update CAD files and documentation for VAYN Arm and Elbow Actuator: Revised binary files for arm and shoulder components, including updated STEP, 3MF, and STL formats. Adjusted part specifications in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
    [actuator.3mf, actuator.step, actuator_occ.3mf, arm.3mf, arm.step]
2026-10-13 Update legal documentation for non-disclosure agreements and design transmittals: Revised clauses in the NDA to clarify confidentiality terms, including conditions for disclosing information and obli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
2026-10-14 Add comprehensive documentation and CAD files for VAYN Arm Rev 0: Introduced detailed BOMs in `purchase.md`, `arm_bom.md`, and `elbow_bom.md`, outlining print and metal parts, sourcing links, and pri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
    [101_Adapter_plate_6061-T6_CNC.stl, 115_Front_ring_6061-T6_CNC_4_mm.stl, actuator.3mf, actuator.step, actuator_occ.3mf, arm.3mf, arm.step]
2026-10-14 Add initial backend and frontend setup for VAYN ODrive terminal: Introduced .gitignore to exclude unnecessary files, added PowerShell scripts for development and production builds, and created a READ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
    [odrive-0.5.1.json, odrive-0.5.6.json, odrive-interface-0.5.1.yaml, odrive-interface-0.5.6.yaml]
2026-10-15 Enhance frontend components and styles for ODrive dashboard: Added a new OdriveHologram component for 3D visualization, updated main.tsx to include additional font weights, and refined CSS styles acr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
2026-10-15 Refactor backend and frontend components for ODrive: Updated main.py to read the token from a file, enhancing security. Added a new read_many method in MockTransport for batch processing. Improved ph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
    [main.py, mock.py]
2026-10-15 Enhance ODrive frontend and backend functionality: Added mock transport option in device connection order for improved testing. Introduced a ViewBoundary component to handle rendering errors graceful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
    [device.py]
2026-10-15 Refactor DeviceWorker and job handling in ODrive backend: Simplified device connection order logic, added idle current masking to prevent flatlining in plots, and enhanced error handling in job conte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
    [commissioning.py, device.py, fibre_usb.py, health.py]
2026-10-15 Implement open-loop motor spin functionality in MockTransport and frontend: Added support for a new `open_loop` job to drive motors without encoders, enhancing testing capabilities. Updated MockTrans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
    [mock.py, test_mock_flow.py]
2026-10-17 Update VAYN Shoulder Actuator CAD files and BOM for Rev 1.4: Revised material specifications for key components, transitioning from 6061-T6 to 7075-T651 for the encoder lid and magnet holder. Updated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
    [VAYN_shoulder_milling.step]
2026-10-17 Update CAD drawings for VAYN Shoulder components: Adjusted mass values and clarified model bounding box descriptions across multiple PDF files. Updated the milling quotation ZIP file to reflect the l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
2026-10-19 Refactor development scripts and enhance backend functionality: Updated `dev.ps1` and `dev.sh` to allow mode argument overrides for better flexibility in device simulation. Improved `run.py` to load 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
    [aliases.py, commissioning.py, main.py, mock.py, run.py, safety.py, test_mock_flow.py, tuning.py]
2026-10-19 Implement origin management and position window enforcement in backend: Added `set_origin` operation to define axis zero positions, enhancing position window handling. Updated safety checks to preven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
    [characterize.py, commissioning.py, main.py, safety.py, test_mock_flow.py, tuning.py]
2026-10-25 Add initial documentation and setup for VAYN ODrive bench GUI: Created context.md for project overview and hardware specifications. Introduced Untitled file detailing project status, setup instructio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
    [101_Adapter_plate_6061-T6_CNC.stl, 115_Front_ring_6061-T6_CNC_4_mm.stl, actuator.3mf, actuator.step, arm.3mf, arm.step]
2026-10-29 Update arm documentation and CAD files for Rev 2.1: Revised purchase.md to reflect updated component specifications and availability. Enhanced arm_bom.md with new mass estimates and part details. Upd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
    [arm.3mf, arm.f3d, arm.step]
2026-10-29 Update VAYN documentation and add new files for RT Core implementation: Introduced VAYN-6.2.1 revision notes across multiple documents, detailing hardware choices and architectural decisions. Added n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
2026-10-30 Add Safety MCU Nucleo Build Guide and update documentation index: Introduced a comprehensive guide for building the VAYN Safety MCU, detailing components, wiring, and operational rules. Updated the d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
2026-10-30 Update shoulder actuator CAD files and BOM for material revisions: Changed material specifications from 7075-T651 to 6082-T6 for the encoder lid, magnet holder, and rear mount plate. Updated steel co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
    [VAYN_shoulder_milling.step]
2026-10-30 Add measurements for EaglePower LA8308 motor and Meukron encoder board: Introduced detailed specifications for the EaglePower LA8308 motor, including dimensions, electrical characteristics, and CAD a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
2026-10-30 Update Meukron encoder measurements: Revised specifications for screw hole dimensions, clarified mounting hole layouts, and corrected assumptions regarding screw types. Added detailed measurements fo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
2026-10-31 Add shoulder actuator v2 design files and calculations: Introduced new actuator design documentation, including decisions on gear configurations and stress analysis. Added CAD files for actuator comp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
    [actuator.3mf, actuator.step]
2026-10-31 Add shoulder v3 actuator design files and calculations: Introduced new documentation for the shoulder v3 pitch joint, detailing design specifications, size, and torque calculations. Added CAD files i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
    [actuator.3mf, actuator.step]
2026-10-31 Add elbow actuator design files and documentation: Introduced comprehensive documentation for the VAYN elbow actuator, including a Bill of Materials (BOM), part specifications, and assembly instructi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
    [actuator.3mf, actuator.step]
2026-10-31 Update elbow actuator documentation and add fit failure analysis: Revised the elbow actuator's research and BOM to reflect assembly issues encountered during testing. Added a new fit failure report d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
2026-10-31 Add shoulder v4 actuator design files and calculations: Introduced new documentation for the shoulder v4 coaxial cycloid actuator, detailing design specifications, torque calculations, and assembly i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
    [actuator.3mf, actuator.step]
2026-10-31 Update shoulder v3 actuator documentation and CAD files: Added a new section on gear correction detailing adjustments to pin clearance and output hole dimensions. Updated actuator STEP file with revi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
    [actuator.3mf, actuator.step]
2026-10-31 Update EaglePower LA8308 motor specifications across documentation and CAD files: Revised motor dimensions from 32.5 mm to 27.5 mm flat-to-flat in multiple files, including parts documentation, CAD s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
    [actuator.3mf, actuator.step, actuator_occ.3mf]
2026-10-31 Update shoulder v2 actuator STEP file with revised Cartesian point coordinates: Adjusted multiple Cartesian points from 48.9 to 43.9 and from 51.9 to 46.9 to enhance accuracy in design specifications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
    [actuator.3mf, actuator.step]
2026-10-31 Update shoulder v4 actuator documentation and CAD files: Revised the rear housing design to include a planetary rear plate with encoder pocket, cable groove, and phase lead slot. Added a new counters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
    [actuator.3mf, actuator.step]
2026-10-31 Update shoulder actuator documentation and CAD files: Revised actuator mass and dimensions in parts documentation and BOM to reflect changes in the shoulder joint design. Adjusted encoder PCB mountin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
    [actuator.3mf]
2026-10-31 Update shoulder actuator documentation and CAD files: Revised actuator dimensions and mass in parts documentation and BOM to reflect changes in the shoulder joint design. Removed magnet holder specif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
    [actuator.3mf, actuator.step]
2026-10-31 Update shoulder v5 actuator documentation and CAD files: Introduced the new two-stage cycloid design with revised dimensions and specifications. Updated actuator calculations and scripts to reflect c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
    [actuator.3mf, actuator.step]
2026-10-31 Update shoulder v4 actuator documentation and CAD files: Revised dimensions and specifications for the crank bearing and housing design to enhance assembly clarity and performance. Adjusted CAD scrip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
    [actuator.3mf, actuator.step]
2026-10-31 Update shoulder actuator documentation and CAD files: Revised dimensions for the encoder lid and housing to reflect accurate measurements, including adjustments to mass and specifications. Updated CA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
    [VAYN_shoulder_milling.step, actuator.3mf, actuator.step]
2026-11-03 Add claw actuator design files and documentation: Introduced new CAD files for the 250 ml Bisleri neck claw, including STL, 3MF, and STEP formats. Added a Python script for generating the claw design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
    [01_mast.stl, 02_carriage.stl, 03_stop.stl, 04_cam.stl, 05_housing.stl, 06_jaw.stl, 07_retainer.stl, beam_center.stl]
2026-11-03 Add neck claw BOM and update CAD files: Introduced a new Bill of Materials (BOM) for the neck claw, detailing parts required for assembly. Updated CAD files, including STEP, 3MF, and STL formats, to 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
    [01_mast.stl, 02_carriage.stl, 03_stop.stl, 04_cam.stl, 05_housing.stl, 06_jaw.stl, 06_jaw_1.stl, 06_jaw_2.stl]
2026-11-03 Update neck claw documentation and CAD files: Revised the Bill of Materials (BOM) for the neck claw to reflect changes in printed parts and specifications. Updated the checks file with new measuremen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
    [01_mast.stl, 02_carriage.stl, 04_cam.stl, 05_housing.stl, 06_jaw_1.stl, 06_jaw_2.stl, 06_jaw_3.stl, 07_retainer.stl]
2026-11-04 Add presentation script and update story documentation: Introduced a new presentation script detailing the development of a humanoid robot, including challenges faced in sourcing components and the d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
    [hand.3mf, hand.step, hand_shell.stl, wrist_plate.stl]
2026-11-04 Update service pattern logic and configuration parameters: Modified the service pattern function to adjust the joint threshold for releasing the pattern and added logic for handling the sweep phase. 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
2026-11-06 Add Run-Arm batch file and update firmware version to 0.2.23: Introduced a new batch file for executing the PowerShell script to control the arm firmware. Updated the firmware version in the configur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
2026-11-06 Add shoulder v6 documentation and CAD files: Introduced new Bill of Materials (BOM) detailing purchased parts for the shoulder actuator, including specifications for screws, bearings, and pins. Added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
    [actuator.3mf, actuator.step, actuator_plate2.3mf, actuator_plate3.3mf]
2026-11-06 Update shoulder v6 actuator documentation and CAD files: Revised the crank shaft description to clarify that it is a single solid piece with an integrated Ø16 core. Updated the checks file with new m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
    [actuator.3mf, actuator.step, actuator_plate2.3mf, actuator_plate3.3mf]
2026-11-06 Update shoulder v6 actuator documentation and CAD files: Revised the Bill of Materials (BOM) to reflect updated journal dimensions and clarified the crank flange design as a single piece. Enhanced th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
    [01_Housing_6082-T6.stl, 02.10_Ring_pin_D4.stl, 02.11_Ring_pin_D4.stl, 02.12_Ring_pin_D4.stl, 02.13_Ring_pin_D4.stl, 02.14_Ring_pin_D4.stl, 02.15_Ring_pin_D4.stl, 02.16_Ring_pin_D4.stl]
2026-11-06 Update shoulder v6 actuator documentation and CAD files: Revised the Bill of Materials (BOM) to include updated dimensions for the disc bearings and journals. Enhanced decisions documentation with de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
    [actuator.3mf, actuator.step, actuator_plate2.3mf, actuator_plate3.3mf]
2026-11-06 Update shoulder v6 actuator CAD files and checks: Modified multiple 3MF and ZIP files for actuator components to ensure alignment with the latest design specifications. Enhanced the checks file with 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
    [actuator.3mf, actuator.step, actuator_plate2.3mf, actuator_plate3.3mf]
